HudsonReynolds/451-DBF-Team01/Assignment Deliverables/A2, Team 01, AAE451B.pdf

# System Assumptions & Constraints

# Assumptions: Environment

## - Density, ρ = 1.225 kg/m³

- Density at sea level, roughly where entire mission takes place
- From Anderson, standard atmosphere tables

## - Gravitational acceleration, g = 9.81 m/s²

- Known constant gravitational acceleration value
- NIST Fundamental Physical Constants

## - Takeoff friction coefficient, μTO

= 0.05
- From Gudmundsson, table 18-4
- Value used for concrete runway, no brakes

## - Landing friction coefficient, μlanding

= 0.08
- From Gudmundsson, table 18-4
- Value used for wet grass, no brakes

# Assumptions: Performance

- ϕcruise = 0.75
- Sadraey, chapter 4 page 126

### - γ = 16.7 degrees

- Calculated from mission altitude and estimated distance for climb
- Mission altitude: 30m
- Estimated climb distance: 100m

### - Span efficiency, e = 0.7

- Selected conservative value from range given by Sadraey, chapter 4 page 122
- AR = 5
- Selected aspect ratio of wing based on aircraft type and stall speed
- From Sadraey, table 5.8

# Assumptions: Performance

### - Max lift coefficient, CL,max = 1.5

- Selected from Sadraey, table 4.11 for home-built aircraft

### - Cruise lift coefficient, CL,C = 0.3

- Typical value for subsonic aircraft, Sadraey, chapter 4 page 132

### - Takeoff lift coefficient, CL,TO = 0.3

- Before rotation and no flaps, therefore similar to cruise

### - Lift coefficient at rotation, CLR = 1.24

- Calculated from CL,max and takeoff speed, 1.1 from takeoff velocity multiplier, Sadraey
- CD,0 = 0.04
- Selected from Sadraey, table 4.12 for home-built/GA with fixed gear
- CD = 0.048
- Calculated from CD,0, CL,C, and induced drag factor
- Sadraey, equation 4.41
- K = 0.091 induced drag factor, from Sadraey, eqn 4.41

# Assumptions: Performance

### - Takeoff drag coefficient, CD,TO = 0.048

- Before rotation and no flaps, therefore similar to cruise

### - Ground roll drag coefficient, CDG = 0.033

- Sadraey, equation 4.67a

### - Load factor, n = 1.5

- Selected conservative value from recommended range for RC planes
- From Sadraey, table 10.9
- ηp = 0.75
- From Gudmundsson, table 3-3 for fixed pitch propellor

### - ηp,TO = 0.45

- From Gudmundsson, table 3-3 for fixed pitch propellor, average efficiency during takeoff

# Assumptions: Performance

### - Stall speed, Vstall = 10.5 m/s

- Selected middle value from recommended stall speed range
- Range from A2 Handout from class

### - Cruise speed, Vcruise = 23.5 m/s

- Calculated from CL,max, CL,C, and stall speed

### - Takeoff speed, VTO

= 11.6 m/s
- From Sadraey, chapter 4, page 132
- Used 1.1 * Vstallas conservative value for takeoff velocity

### - Rturn = 20 m

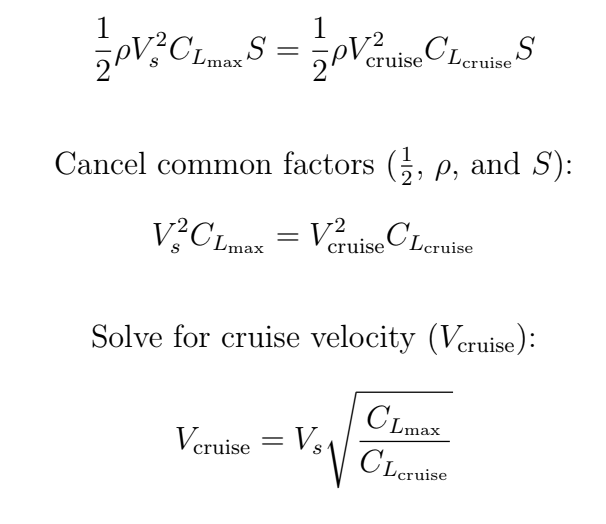
[picture p1: figure]

- Selected value smaller than required turn radius for mission flight path that also allowed for turn speed between stall and cruise speeds

### - Maneuver speed, VM = 14.8 m/s

- Calculated from selected turn radius and load factor

# Constraints (From RFP)

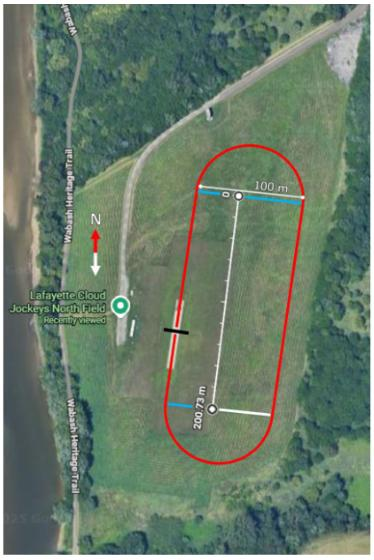
[picture p2: figure]

### - Wingspan ≤ 1.5 m - Aircraft Length ≤ 0.75 m - Aircraft Height ≤ 0.75 m - MTO ≤ 6 kg

- hcruise = 30 m
- Rturn,max = 50 m

### - STO ≤ 25 m

- Pmotor,max ≤ 1 kW

### - Stable with and without payload - Mpayload = 520g ± 10g - Lpayload = 50.8 mm (± 1mm) - Cost ≤ $400

# Constraints: Stall

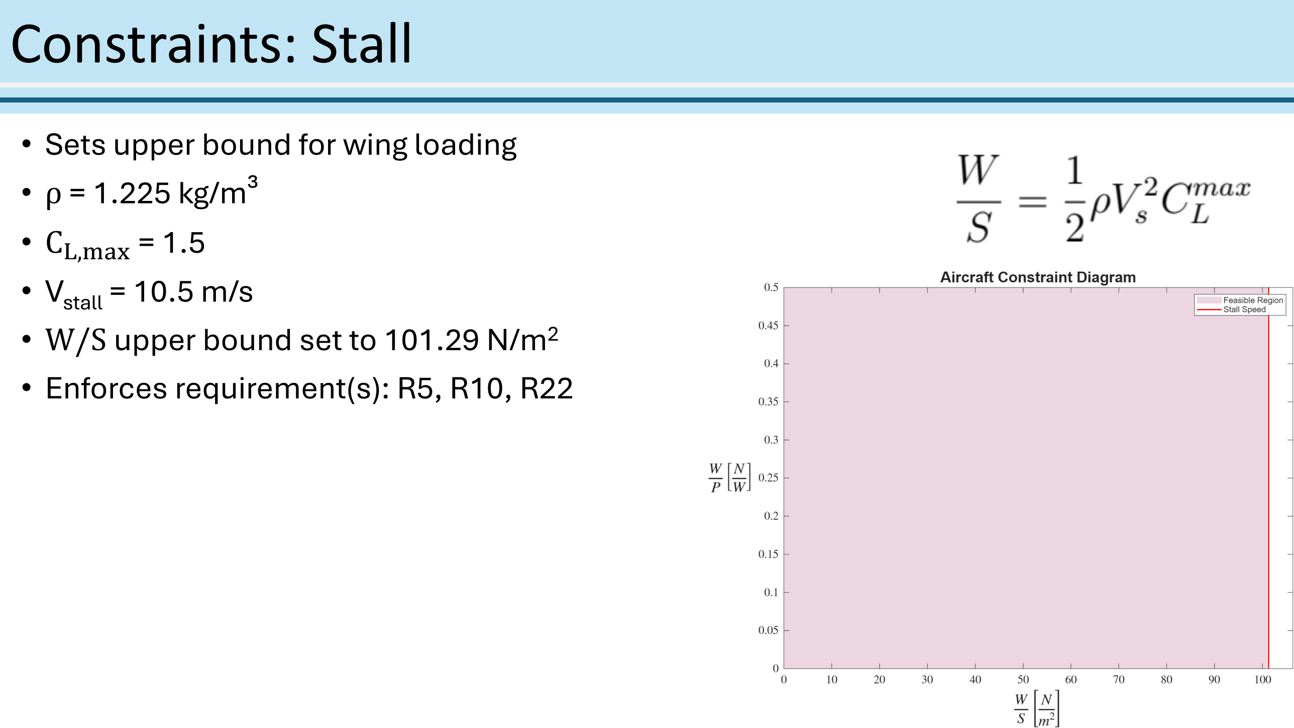
[picture p3: page 8]

### - Sets upper bound for wing loading - ρ = 1.225 kg/m³

- CL,max = 1.5

### - Vstall = 10.5 m/s - W/S upper bound set to 101.29 N/m² - Enforces requirement(s): R5, R10, R22

# Constraints: Climb

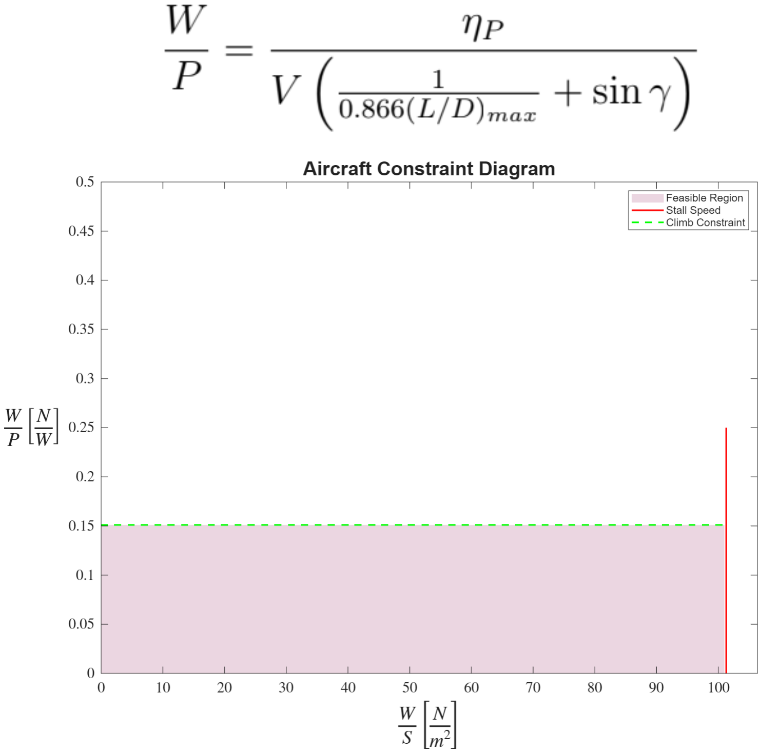
[picture p4: figure]

### - Sets upper bound for power loading

- ηp = 0.75

### - Vstall = 10.5 m/s

•

L
D max

= 6.23

### - γ = 16.7 degrees - Power loading limit set to 0.15 N/W - Enforces requirement(s): R2, R21, R22

# Constraints: Cruise

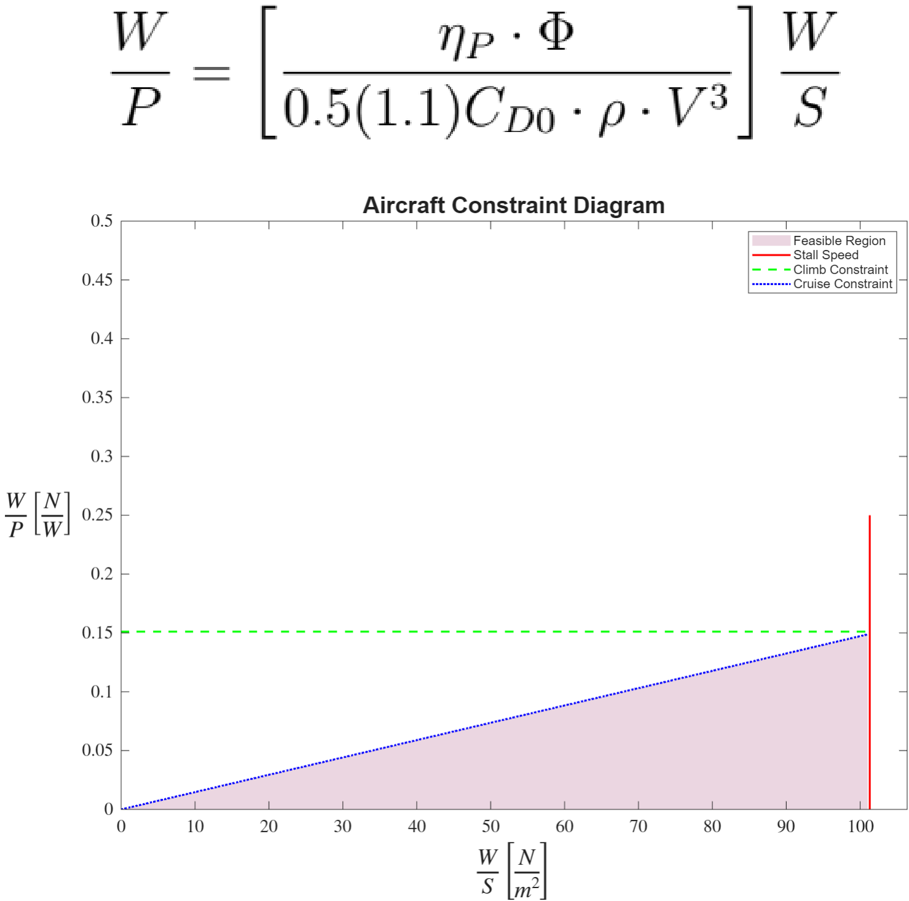
[picture p5: figure]

### - Sets upper bound for power loading

- ηp = 0.75

### - Vcruise = 23.5 m/s

- ϕcruise = 0.75

### - ρ = 1.225 kg/m³

- CD,0 = 0.04

### - Power loading limit set to 0.15 N/W at 101.29 N/m² - Enforces requirement(s): R3, R21

# Constraints: Maneuver

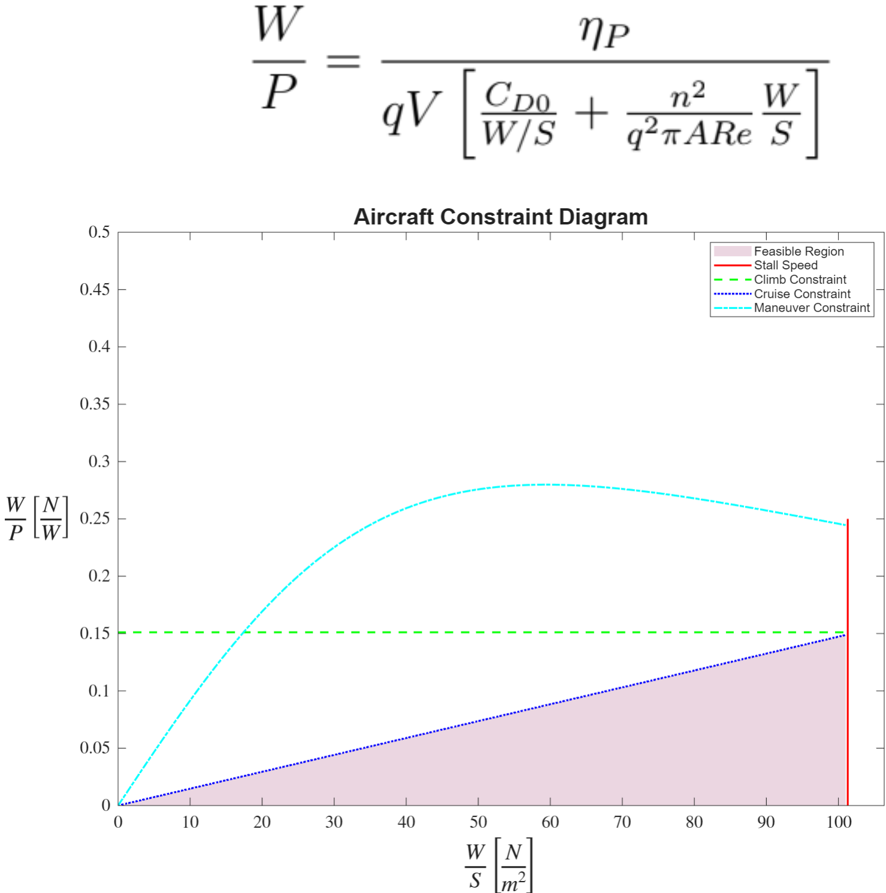
[picture p6: figure]

- Sets upper bound for power loading in our case
- ηp = 0.75
- q = 0.5 * ρ * V² = 134.3 Pa
- CD,0 = 0.04
- VM = 14.8 m/s
- Minimum turn radius of 20 m allows for maneuverability off the runway
- VM found using
- VM greater than VM,stall = 12.86, so chosen turn speed is viable
- n = 1.5
- AR = 5
- e = 0.7
- Does not impact feasible region
- Enforces requirement(s): R3, R4, R19

# Constraints: Take-Off

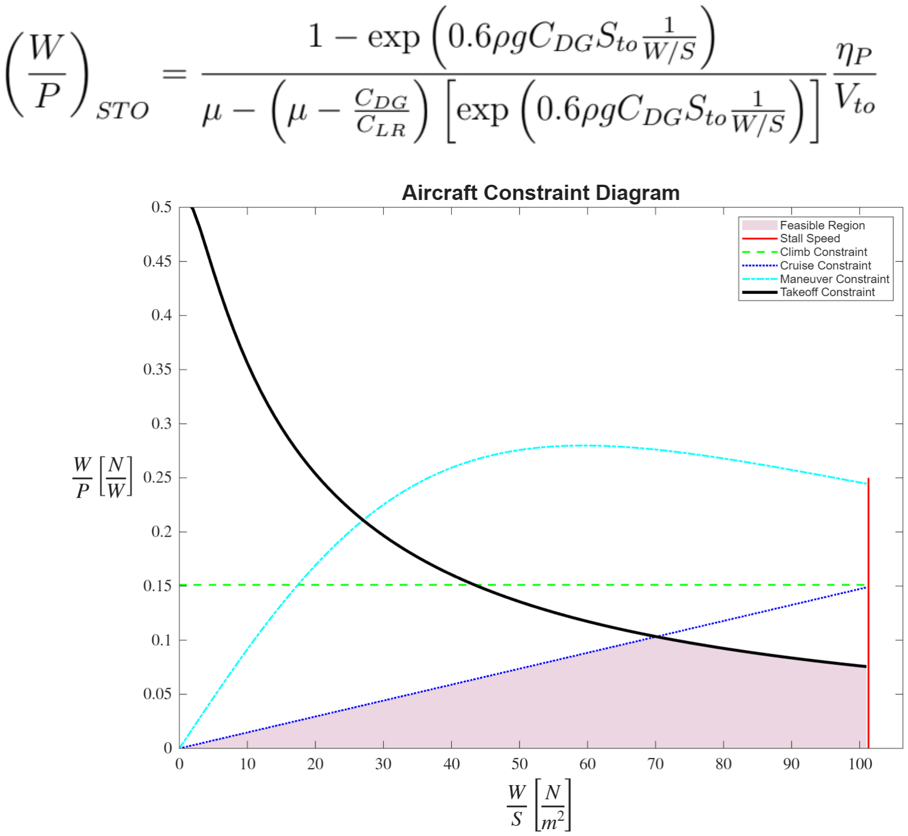
[picture p7: figure]

### - Sets upper bound for power loading - ηp,TO = 0.45 - ρ = 1.225 kg/m³ - g = 9.81 m/s² - CDG = 0.033 - CLR = 1.24

- μTO

= 0.05

### - STO = 25 m

- VTO

= 11.6 m/s

### - Power loading limit set to ~0.07 N/W at 101.29 N/m² - Enforces Requirement(s): R1, R21, R22

# Design Point

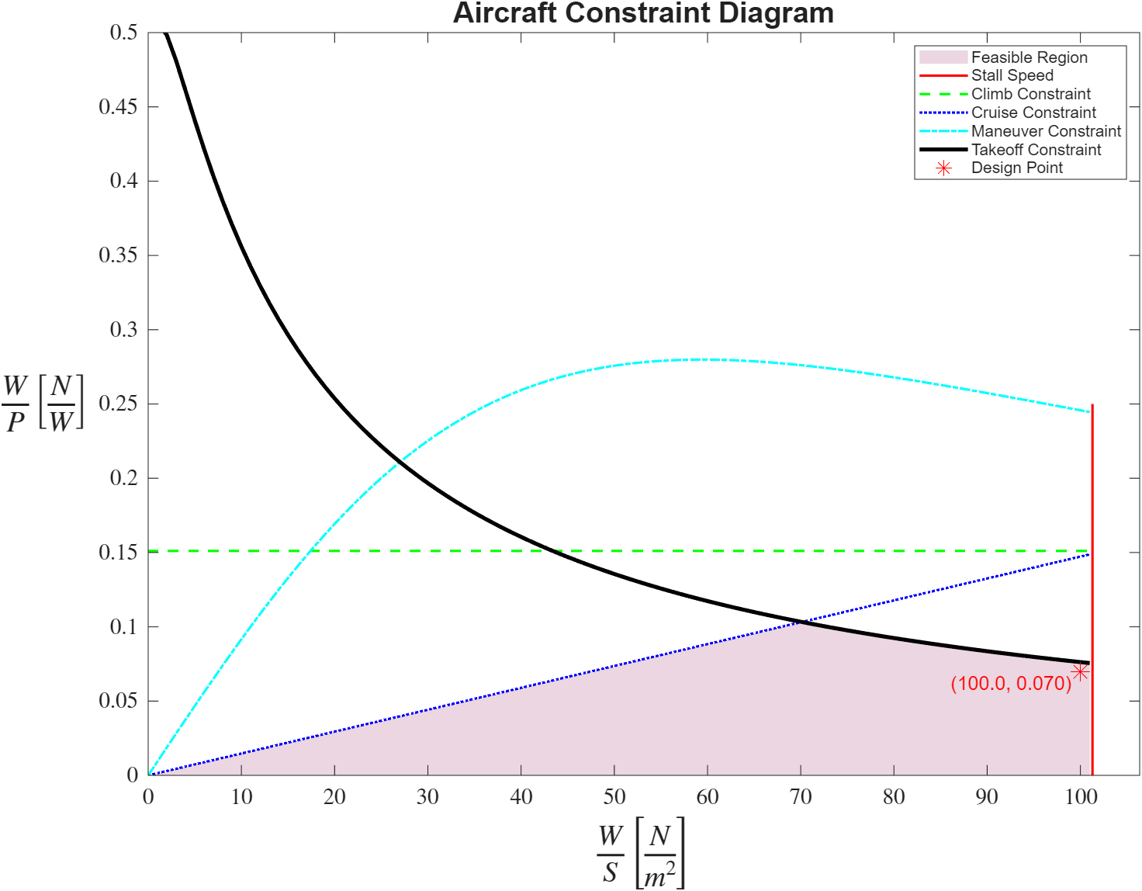
[picture p8: figure]

# Design Point

## - Wing loading selected at 100 N/m²

### - Near maximum for assumed stall speed - Minimizes wing area in feasible design space, reduces cost

## - Power loading selected at 0.07 N/W

### - Near maximum in design space for selected wing loading - Minimizes power requirement

## - Chose design point near takeoff and stall corner rather than near takeoff and climb corner because this allows for much smaller wing area with relatively similar required power

# Appendix

# Code:

Code for this project can be found in our team's GitHub repo here. (https://github.com/HudsonReynolds/451-DBF-Team01)

# Sources

Sadraey, M. H. (2012). Aircraft Design: A Systems Engineering Approach.

Gudmundsson, S. (2022). General Aviation Aircraft Design.

Anderson, J. D. (2016). Introduction to Flight, Eighth Edition.

## AAE 451 Lecture Notes
