HudsonReynolds/451-DBF-Team01/Assignment Deliverables/AAE451B, Team 01, A4.pdf

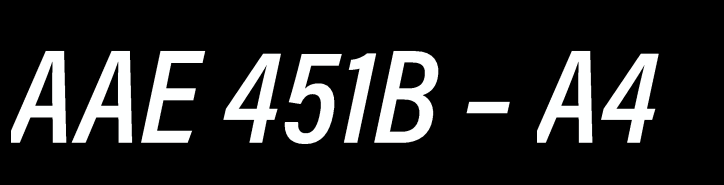
[picture p9: figure]
AAE 451B –A4

# Team 01

9/6/2026

Component | Option 1 | Option 2 | Option 3 | Option 4
Wings | High Wing | Mid Wing | Low Wing | Biplane
Propulsion | Tractor | Pusher | Double Tractor | Double Pusher
Landing Gear | Tricycle | Tail Dragger | Skis | Bicycle
Fuselage | Cylindrical Tube | Box Tube | Lifting Body | No external
Empennage | Conventional | V-Tail | H-Tail | Swept Tail

# - Below are 4 selected concepts for our vehicle - The options were chosen so that A, B, C, and D are feasible

Concept | Wing | Propulsion | Landing Gear | Fuselage | Empennage
1 | High Wing | Tractor | Tricycle | Cylindrical | Standard Tail
2 | Low Wing, Dihedral & Taper | Tractor | Tricycle | Cylindrical | Swept Vertical
3 | High Wing, Taper & Camber | Double Tractor | Tail Dragger | Cylindrical | H-tail
4 | Biplane | Tractor | Tail Dragger | Oval | Swept Vertical

- The letter "Y" signifies being compliant with the presented limit.
- The letter "N" signifies a lack of compliance to the presented limit.
Concept | Within Span Limit? | Within Weight Limit | Within Power Limit? | Holds Battery + Payload? | Passes Gate?
1 | Y | Y | Y | Y | Y
2 | Y | Y | Y | Y | Y
3 | Y | Y | Y | Y | Y
4 | Y | Y | Y | Y | Y

1. Takeoff distance: This is a hard requirement set by the RFP and can vary with aircraft configuration.
2. Ease of assembly: There are multiple requirements within the RFP that relate to the speed in which the aircraft needs to be transitioned from a state of disassembled storage to its flight ready configuration, including the empty weight being assembled in under 5 minutes, and the battery and payload being installed within 2 minutes.
3. Battery access: Circles back to RFP requirement of a hard 2 minute cap on battery installation, as well as the RFP requirement that the battery needs to be able to be accessed and removed without removal of aircraft components.
4. Safe landing: RFP dictates a landing within a soft grass field must be conducted without significant damage.
5. Stable/controllable: We need to ensure that our aircraft can reliably complete the 3 lap flight path presented in the RFP while also providing predictable flight behavior so the external pilot may easily avoid potential obstacles in the form of wildlife and/or bystanders.
6. Cost: Because our budget of $400 is a hard constraint, using expensive materials or manufacturing processes are out of the question. Factoring in cost for manufacturing allows us to obtain a realistic
design compromising material benefits for feasibility.

# Evaluation Matrix

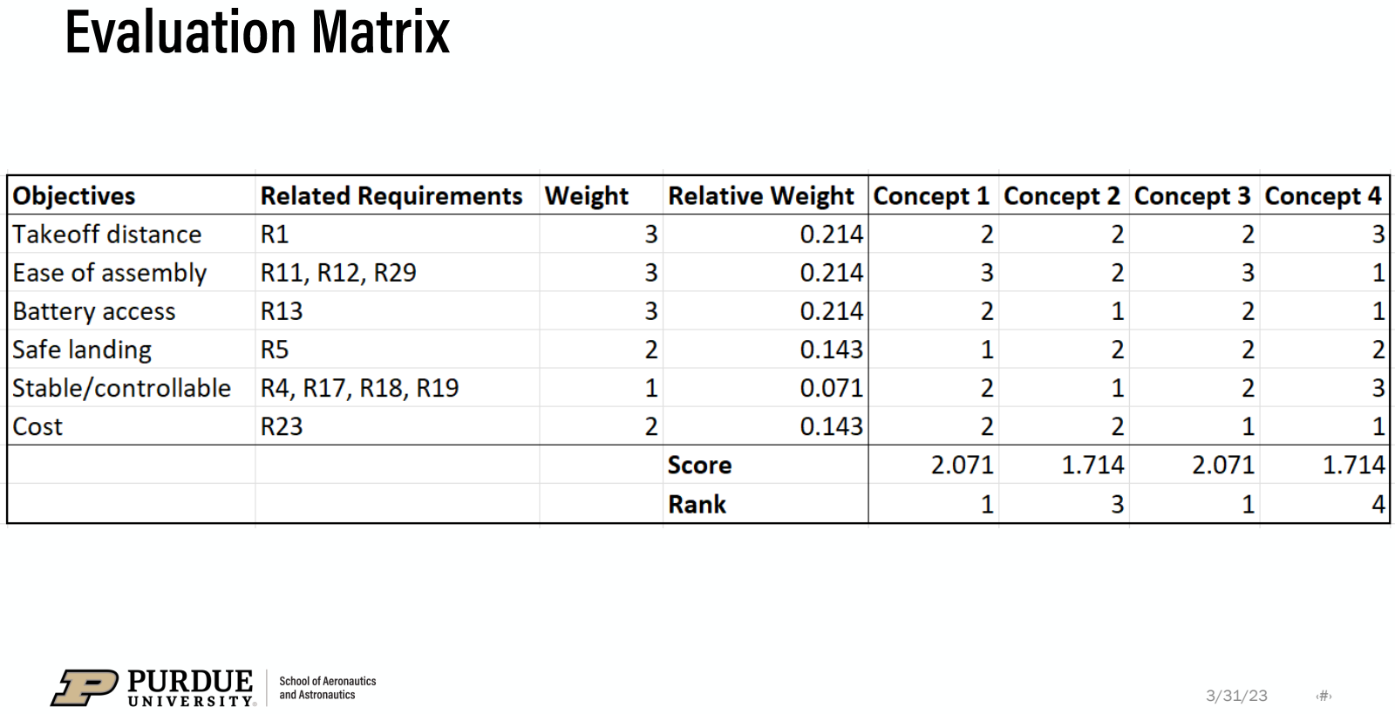
[picture p10: page 6]

# - Takeoff distance was weighted heavily because it is a hard requirement

- Ease of assembly and battery access were also weighted heavily because these can be significantly

# affected by the configuration selection

- Safe landing was given a medium weight because this can be affected by configuration, but is also

# affected by pilot ability

- Cost was also given a medium weight because it a strict requirement, but we expect most configurations

# can stay within budget

- Stable/controllable was given the lowest weight because it can be affected by configuration, but between

# the concepts we traded, stability will largely come down to the detailed design

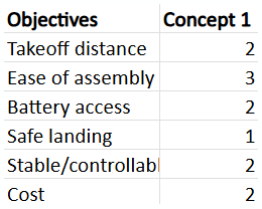
[picture p11: figure]

## - Consists of a high-wing with a NACA 2412 airfoil

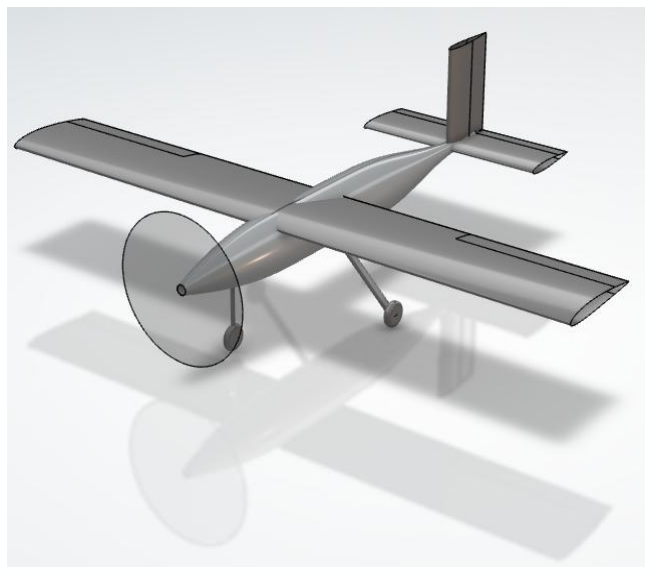
[picture p12: figure]

### - Straight wing (no twist or sweep, taper ratio of 1)

## - Ailerons that occupy 50% of span and 25% of chord

## - Tricycle landing gear - no extra clearance needed for tractor propeller

## - Standard tail

## - Payload, battery, and primary avionics reside in fuselage cavity

## - First row of parameter sheet

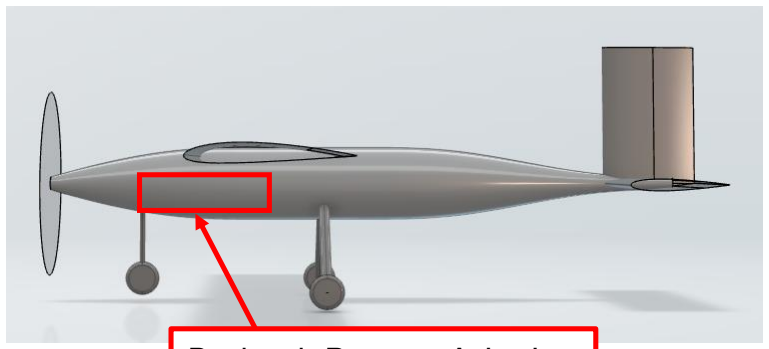
[picture p13: figure]
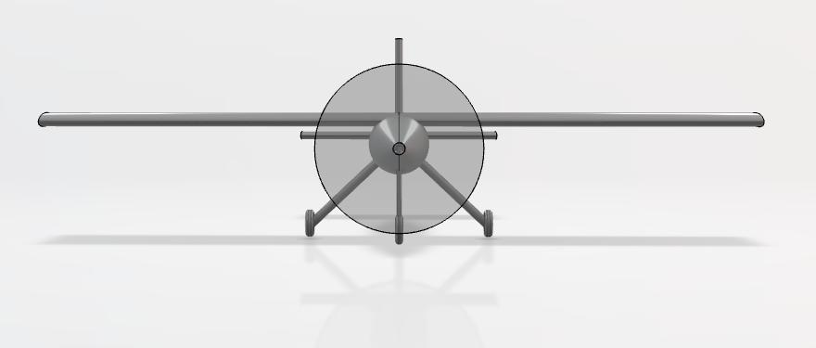
[picture p14: figure]

### 3/31/23 ‹#› Payload, Battery, Avionics

## Score Justification

- Takeoff distance: Given a 2 due to the lift C_L, no flaps, and wing area being about average relative to other choices
- Ease of assembly: High wing, single motor, and single rudder make this simple to assembly
- Battery access: Battery could be accessed through either the side or bottom, but not top
- Safe landing: Risk of a tail strike during landing if not careful
- Stable/controllable: High wings are more stable
- Cost: Relatively simple design without duplicated components

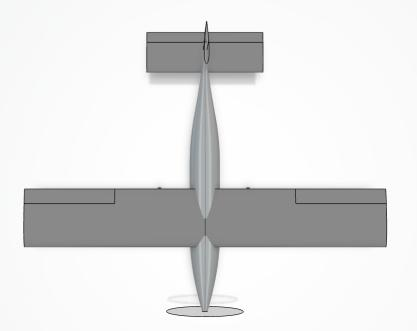
[picture p15: figure]

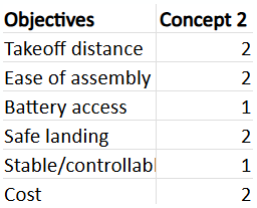
[picture p16: figure]

## - Consists of a low-wing with a NACA 2415 airfoil

### - Straight wing for 40% span, other 60% at 5° dihedral, taper ratio 0.75

## - Ailerons only on dihedral part of wing

## - Tail Dragger landing gear – gives extra prop clearance for tractor

## - Swept Tail at 5° backward with tapered vertical stabilizer

## - Payload, battery, and primary avionics reside in fuselage cavity

## - Second row of parameter sheet

# Bent Tapered Low-Wing, Standard Tail, Tail Dragger

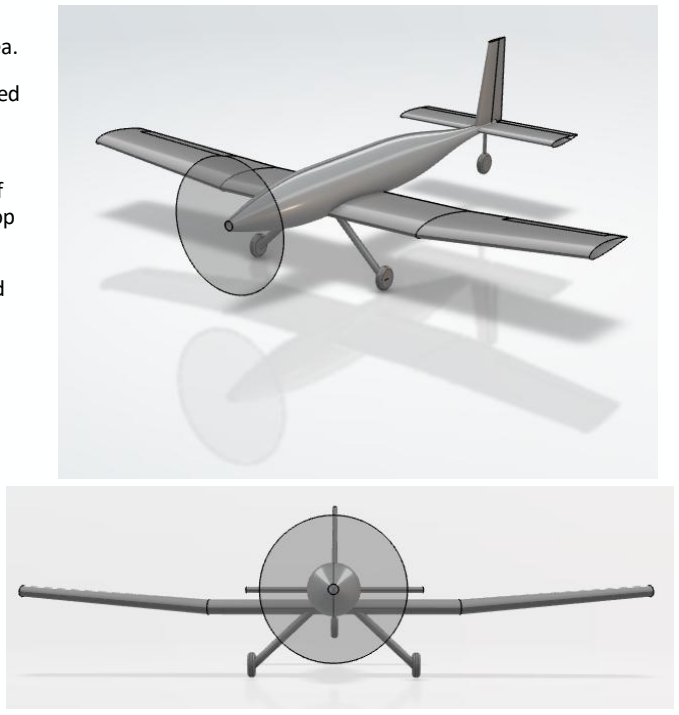
[picture p17: figure]
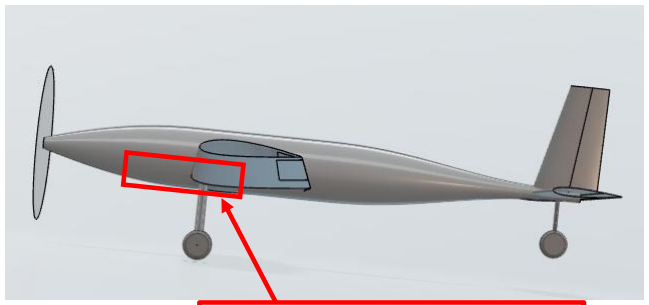
[picture p18: figure]

### 3/31/23 ‹#› Payload, Battery, Avionics

## Score Justification

- Takeoff distance: Given a 2 due to the lift C_L, no flaps, and wing area being about average relative to other choices.
- Ease of assembly: Simple aircraft with minimal components, but due to low wing might be hard to assembly the landing gear, wing, and body with the payload and battery in this area.
- Battery access: Wing/body structure will interfere with desired battery location, possibly making it harder to fit a battery in this area with ease.
- Safe landing: Tail dragger is easier to land because less risk of tail strike, more prop clearance, and twin props decrease prop size and lower strike risk, but easier to flip than tricycle
- Stable/controllable: Propeller adds net torque to vehicle, and swirled flow hits the tail that can cause instabilities.
- Cost: Low overall cost due to minimal material and single engine.

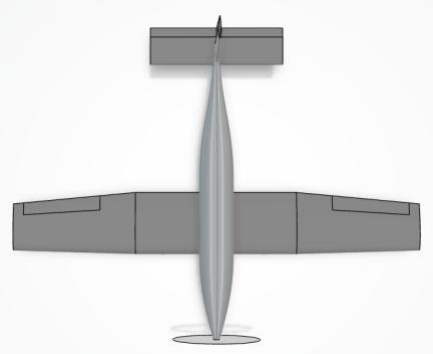
[picture p19: figure]

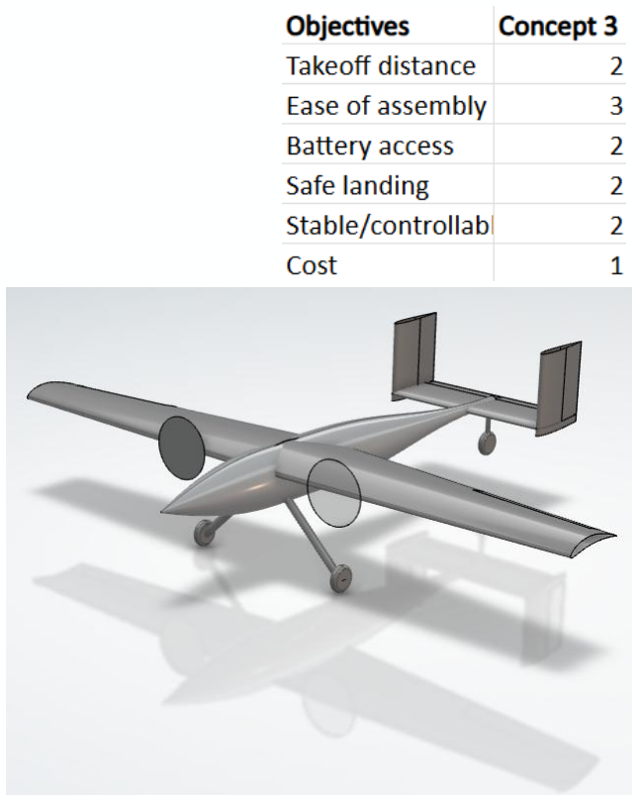
[picture p20: figure]

## - Consists of a high-wing with E423 airfoil to balance H-tail moment

### - Taper ratio 0.6, no twist or sweep

## - Ailerons on only ~38% of wing; double tractor propellers on front

## - Tail Dragger landing gear – gives extra prop clearance

## - H-tail with smaller span and smaller vertical height than standard

## - Payload, battery, and primary avionics reside in fuselage cavity

## - Third row of parameter sheet

# Cambered High-Wing, H-Tail, Double Tractor, Tail Dragger

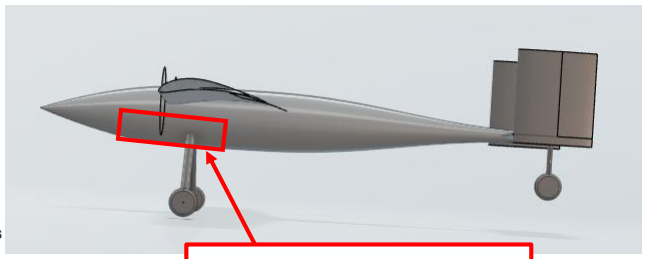
[picture p21: figure]

### Payload, Battery, Avionics

## Score Justification

- Takeoff distance: Given a 2 due to the lift C_L, no flaps, and wing area being about average relative to other choices. Initial AoA from tail dragger but smaller props less efficient
- Ease of assembly: Two motors and two rudders make assembly more complicated
- Battery access: Battery could be accessed through either the side or bottom, but not top
- Safe landing: Tail dragger is easier to land because less risk of tail strike, more prop clearance, and twin props decrease prop size and lower strike risk, but easier to flip than tricycle
- Stable/controllable: Dual engines cancel out torque, and increases stability in low speeds and while turning
- Cost: Dual engines more expensive and require more avionics, also additional tail material brings cost up

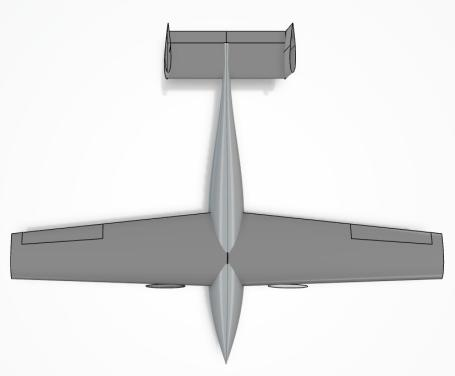
[picture p22: figure]
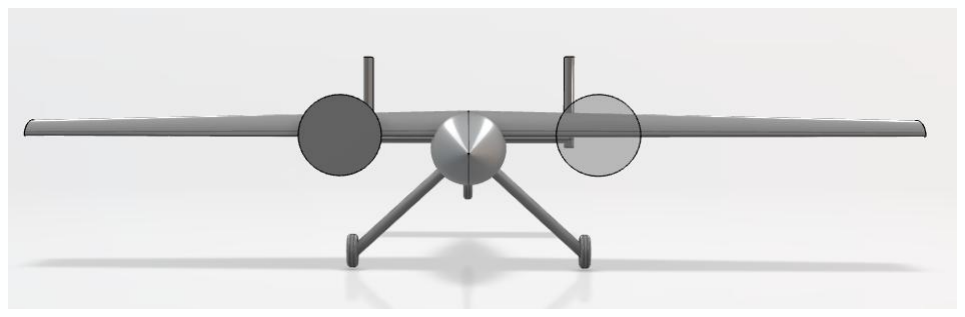
[picture p23: figure]

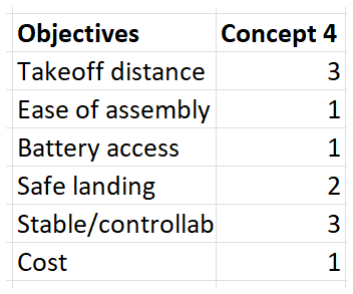
[picture p24: figure]

## - Consists of two wings with NACA 0012 airfoils

## - Straight wings (no twist or sweep) attached to oval fuselage

## - Ailerons on only ~38% of lower wing, none on upper wing

## - Tail Dragger landing gear – gives extra prop clearance

## - Standard tail, slightly swept vertical stabilizer

## - Payload, battery, and primary avionics reside in fuselage cavity

## - Fourth row of parameter sheet

# Biplane, H-Tail, Standard Tail, Tail Dragger

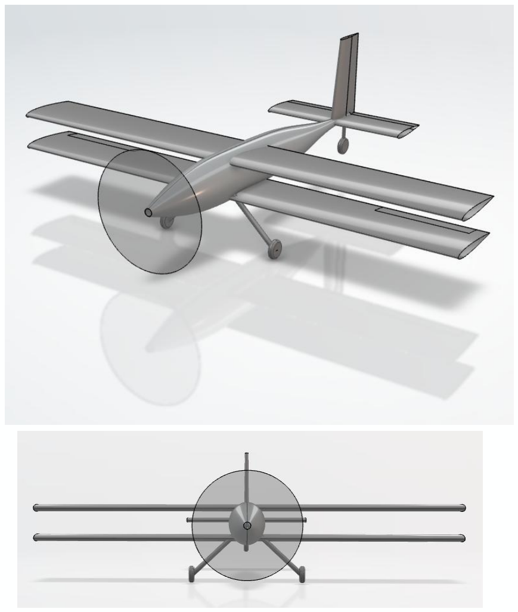
[picture p25: figure]
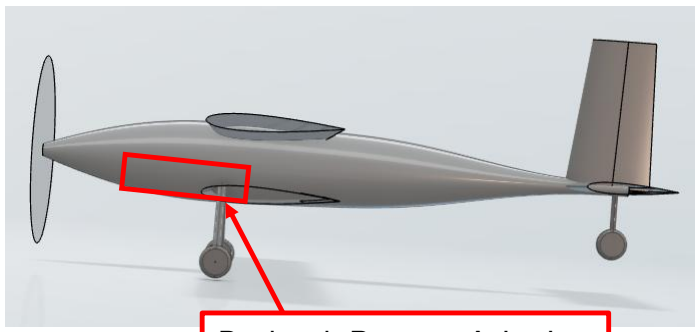
[picture p26: figure]

### 3/31/23 ‹#› Payload, Battery, Avionics

## Score Justification

- Takeoff distance: Given a 3 due to the high wing area and better clearance of prop from the ground, as well as a starting AoA from tail dragger gear.
- Ease of assembly: Increased amount of build and assembly required for 2 wings, location of components within the vehicle become harder to fit.
- Battery access: Wing/body structure will interfere with desired battery location, possibly making it harder to fit a battery in this area with ease.
- Safe landing: Tail dragger is easier to land because less risk of tail strike, more prop clearance, and twin props decrease prop size and lower strike risk, but easier to flip than tricycle
- Stable/controllable: Will likely perform well in low speed, low wing loading makes it more maneuverable
- Cost: Due to extra wing material, will require more material, bringing cost up.

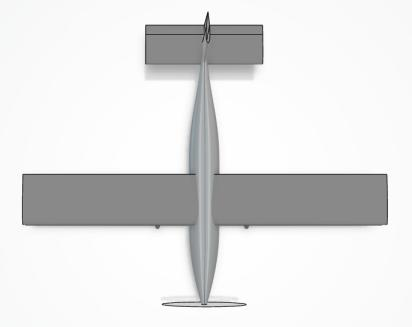
[picture p27: figure]

# Configuration Model Parameters

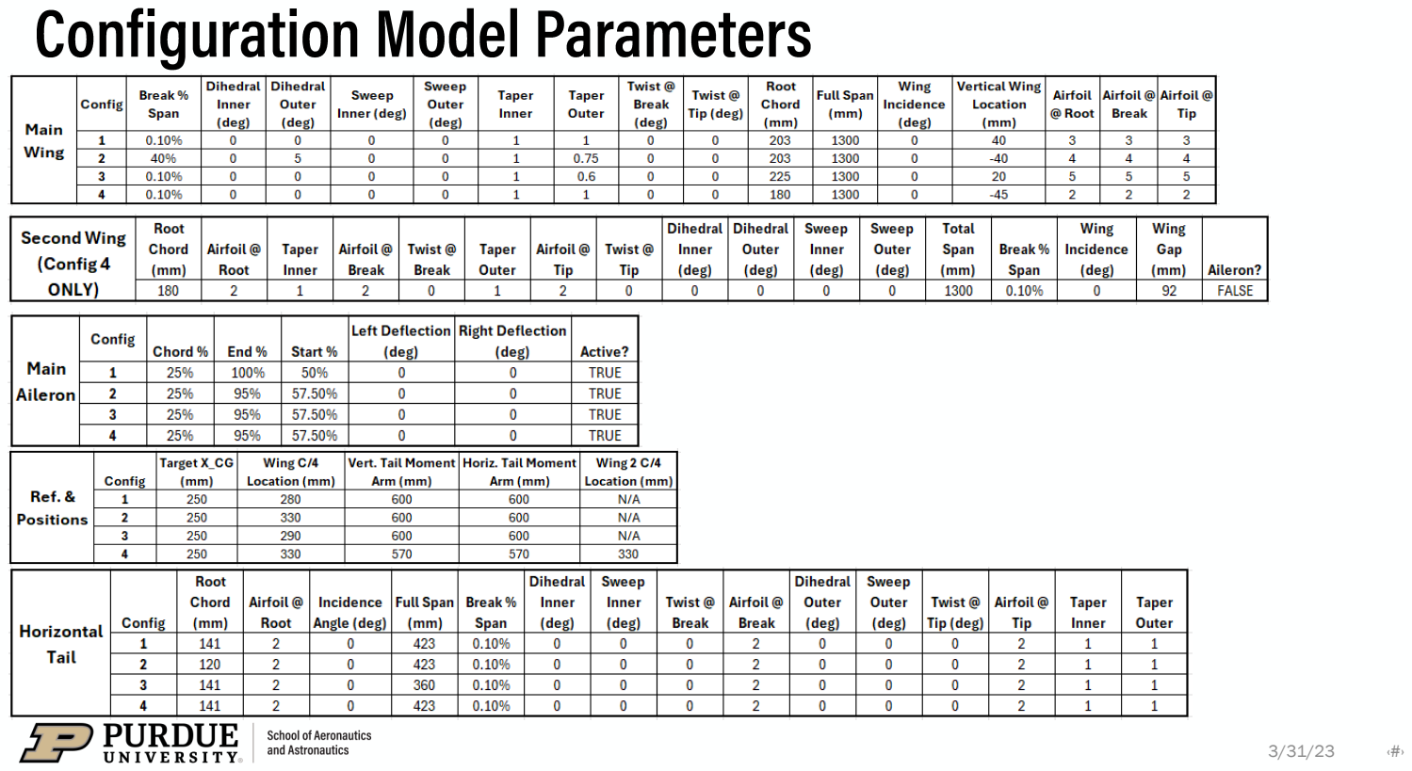
[picture p28: page 12]

# Configuration Model Parameters

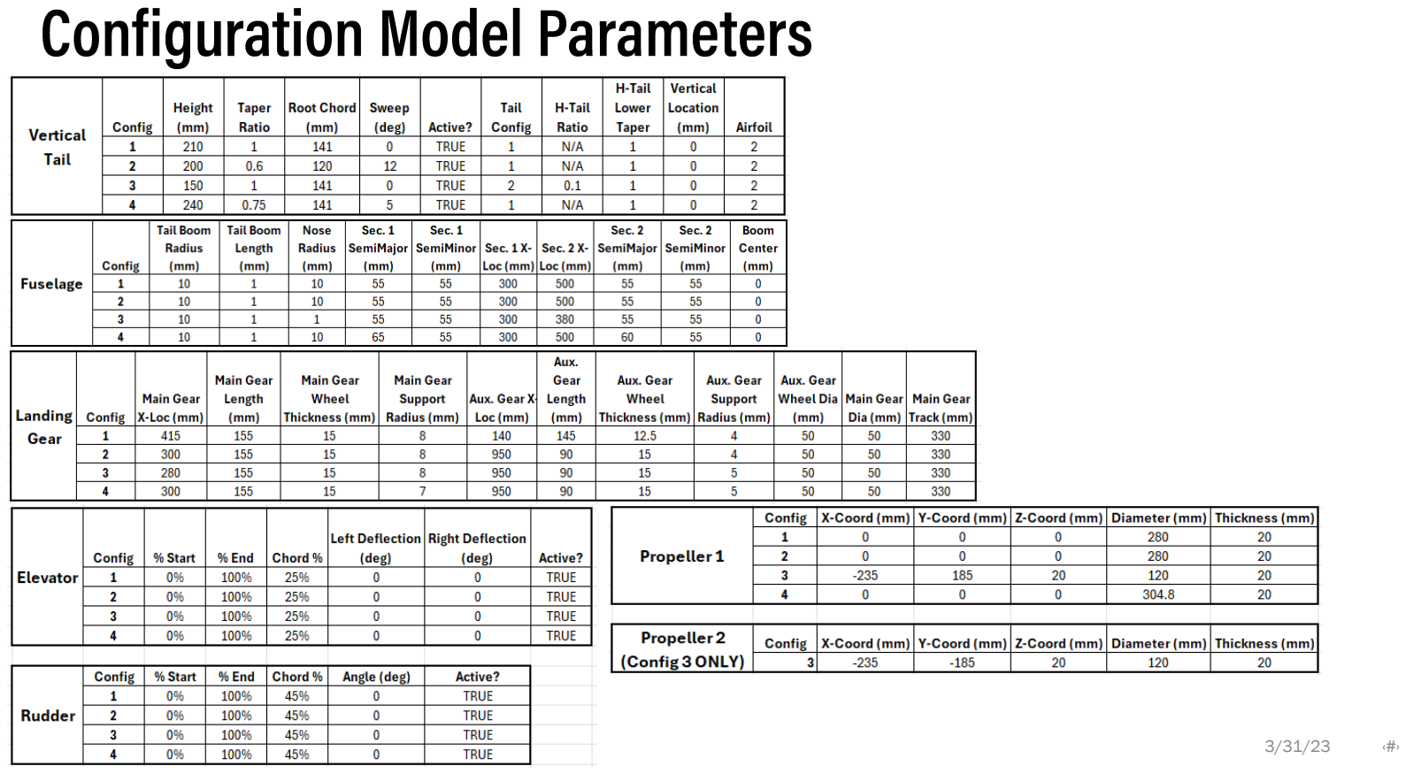
[picture p29: page 13]

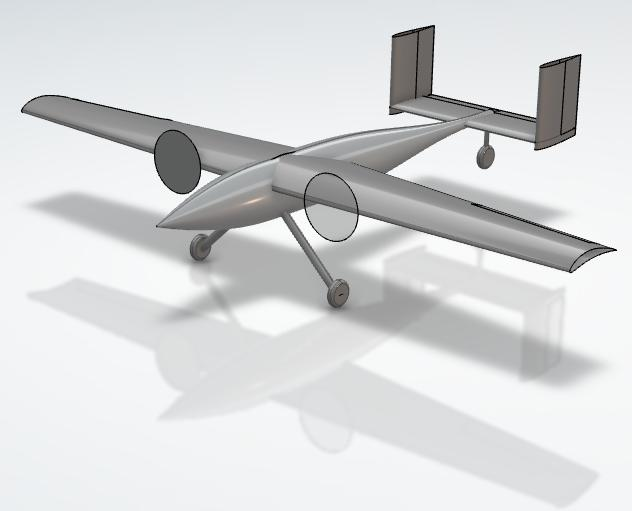
[picture p30: figure]

- Concept 3 has been chosen due to the result of the weighted matrix, even though it was tied for the 1st concept, and may be more expensive than concept 1 - Chosen due to unique design and interesting challenge of using an H tail over conventional tail - Bi-prop was chosen for easy of controllability due to torque imbalance from the propeller - Due to high wing design, wing can be a singular piece while still having access to battery and payload - Tail dragger chosen for lower overall drag and better propeller clearance - Tapered wing for better spanwise efficiency

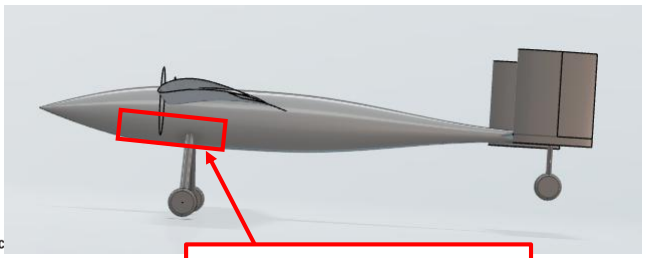
[picture p31: figure]
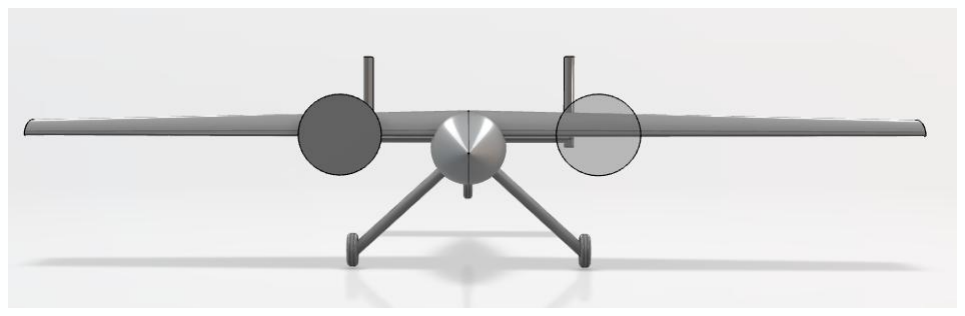
[picture p32: figure]

### 3/31/23 ‹#› Payload, Battery, Avionics
