HudsonReynolds/451-DBF-Team01/Assignment Deliverables/AAE451B, Team 01, A5.pdf

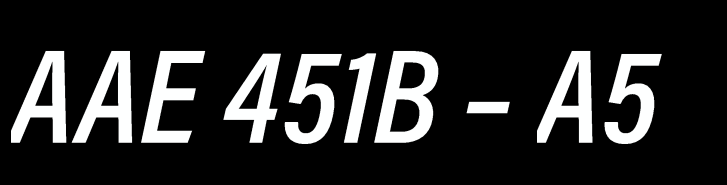
[picture p33: figure]
AAE 451B –A5

# Team 01

9/13/26

# - Velocities:

## - Cruise: 23.5 m/s - Stall: 10.5 m/s - Max: 28.2 m/s

# - Selected wingspan: 1.5 m - Chord: 0.318 m

## - From selected wing loading of 95 N/m² , estimated mass of 4.45 kg, and fuselage width of 55 mm

# - Air properties at standard sea level conditions: 101325 Pa, 288 K

## - Density: 1.225 kg/m³ - Viscosity: 1.796E-05 Pa-s

# - Reynolds number: Chord used as reference length

## - Cruise velocity: 510000 - Stall velocity: 230000 - Max velocity: 610000

# - Reynolds number range used for airfoil trade: 100000 – 700000

Criterion | Requirements it serves (reference from A1) | Weight | Relative Weight | Weight Justification
Cl,max | R1 | 3 | 0.214 | The flight mission includes a baseline requirement of taking off within 25 meters of the starting line. A high maximum lift coefficient is required to guarantee a successful takeoff relative to this requirement.
Cm0 | R4 | 3 | 0.214 | Highly cambered airfoils generate massive nose-down pitching moments. Balancing this requires the tail to generate significant downforce, which would result in a high level of trim drag.
(L/D)max | R3, R21 | 3 | 0.214 | The aircraft must sustain flight for 3 laps under a strict power cap. Maximizing aerodynamic efficiency directly improves the power efficiency during the cruising state.
Manufacturability | R23, R24 | 1 | 0.0714 | Choosing an airfoil that does not overtly cut into our budget or is too challenging to effectively manufacture is a crucial part of the design process that must be considered.
Alphastall | R5, R19 | 1 | 0.0714 | A higher stall angle provides a forgiving margin of error for the pilot in the case of any sudden actions that may be needed in the air
Cl,alpha | R19 | 1 | 0.0714 | Having a lift curve slope in either extremity (too steep/flat) may lead to overly sensitive or sluggish flight behaviors.
Cd,min | R21 | 1 | 0.0714 | Lower base drag saves battery power. It gets a lower weight than (L/D)max because it only shows the 'best-case’ drag, which might not be the angle our aircraft flies at during cruise.
Alpha at (L/D)max | R3 | 1 | 0.0714 | Aligning the airfoil's most efficient angle of attack with the aircraft's flat cruising angle can help ensure drag is minimized during flight.

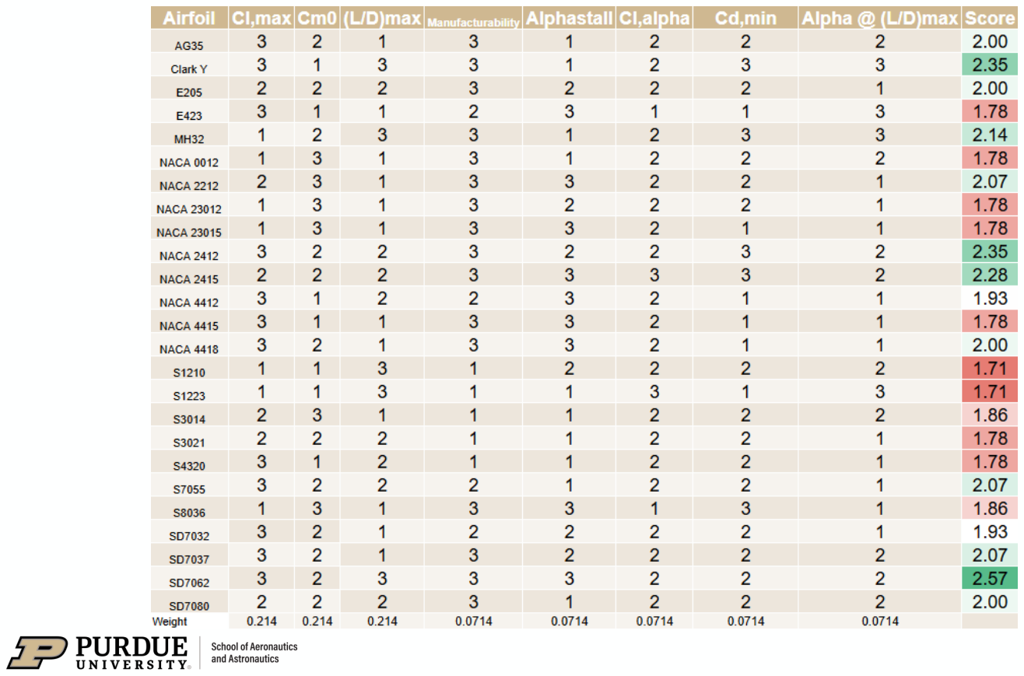
[picture p34: page 4]

# Airfoil Trade Study: Airfoils

# Re = 230000- Stall Speed

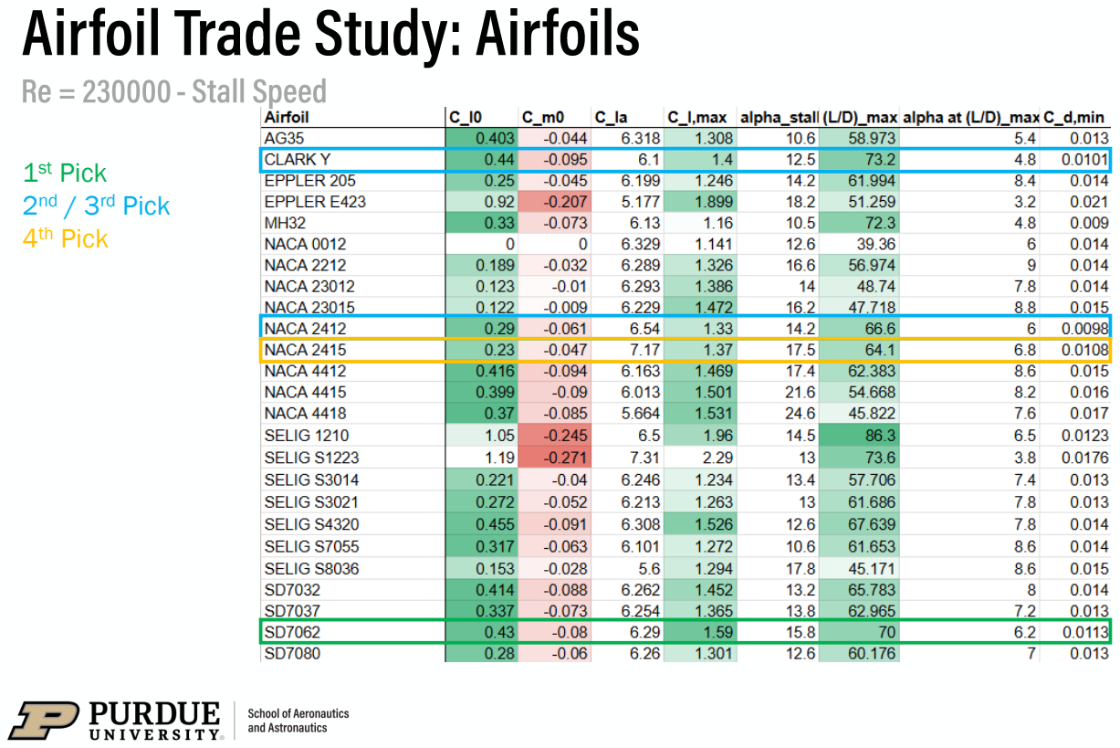
[picture p35: page 5]

1

## st Pick

2

## nd / 3rd Pick

4

## th Pick

# Airfoil Trade Study: Airfoils

# Re = 510000 - Cruise Speed

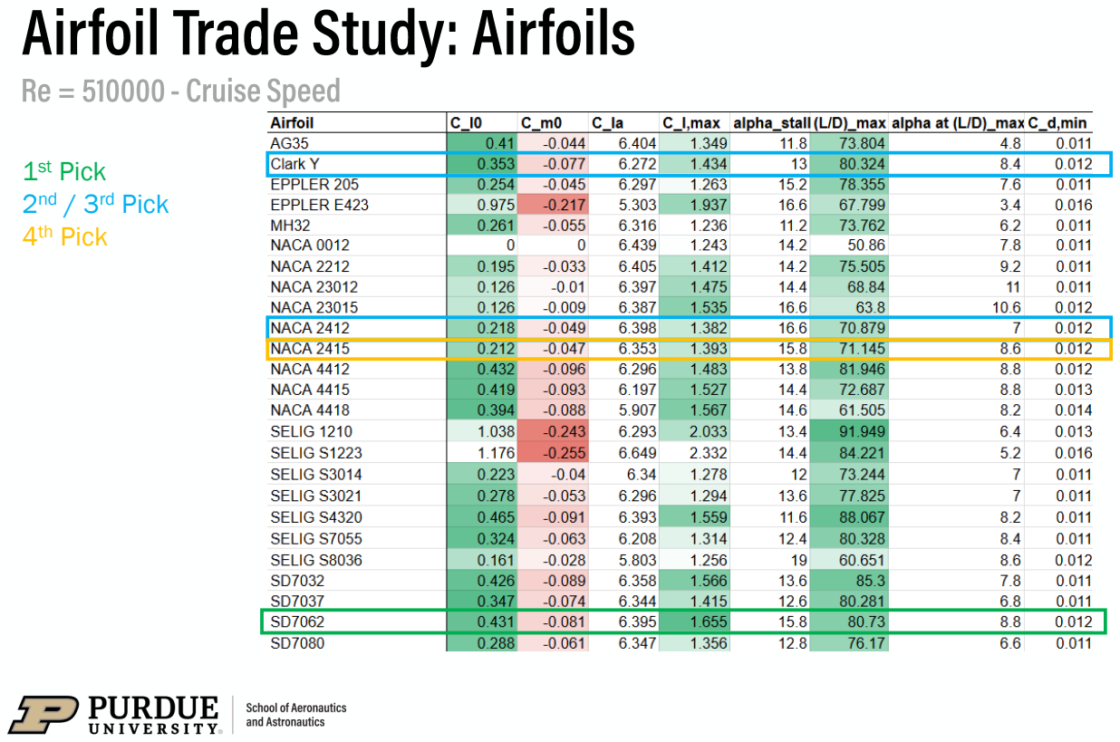
[picture p36: page 6]

1

## st Pick

2

## nd / 3rd Pick

4

## th Pick

# Airfoil Trade Study: Airfoils

# Re = 610000 - Max Speed

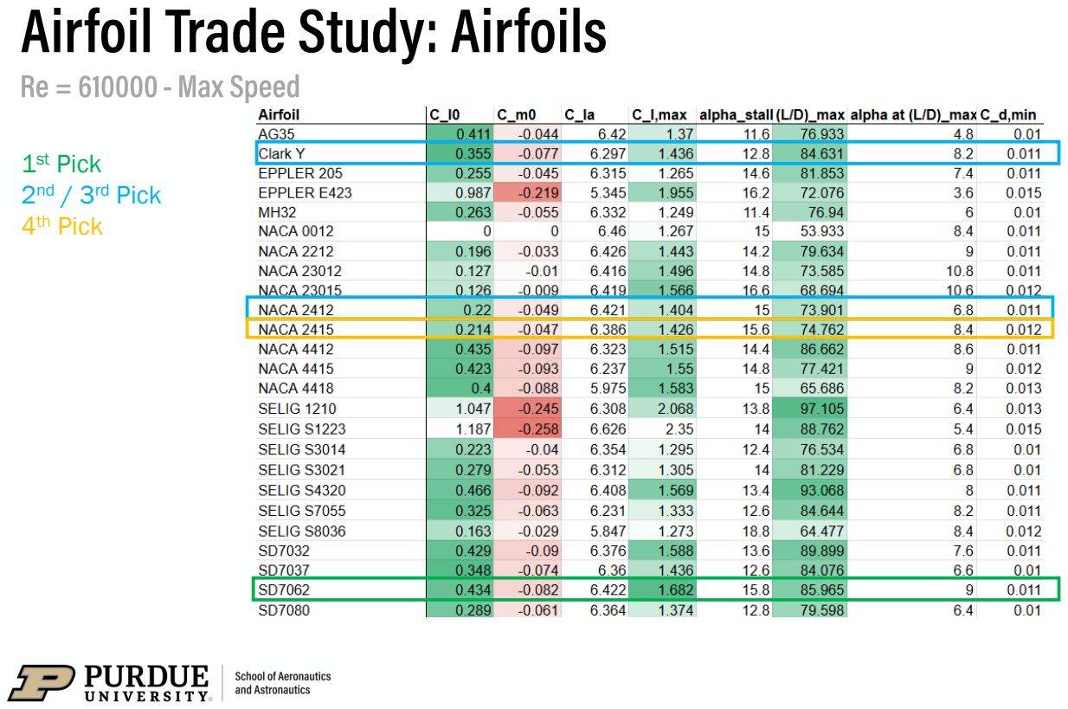
[picture p37: page 7]

1

## st Pick

2

## nd / 3rd Pick

4

## th Pick

# Airfoil Trade Study: Airfoils

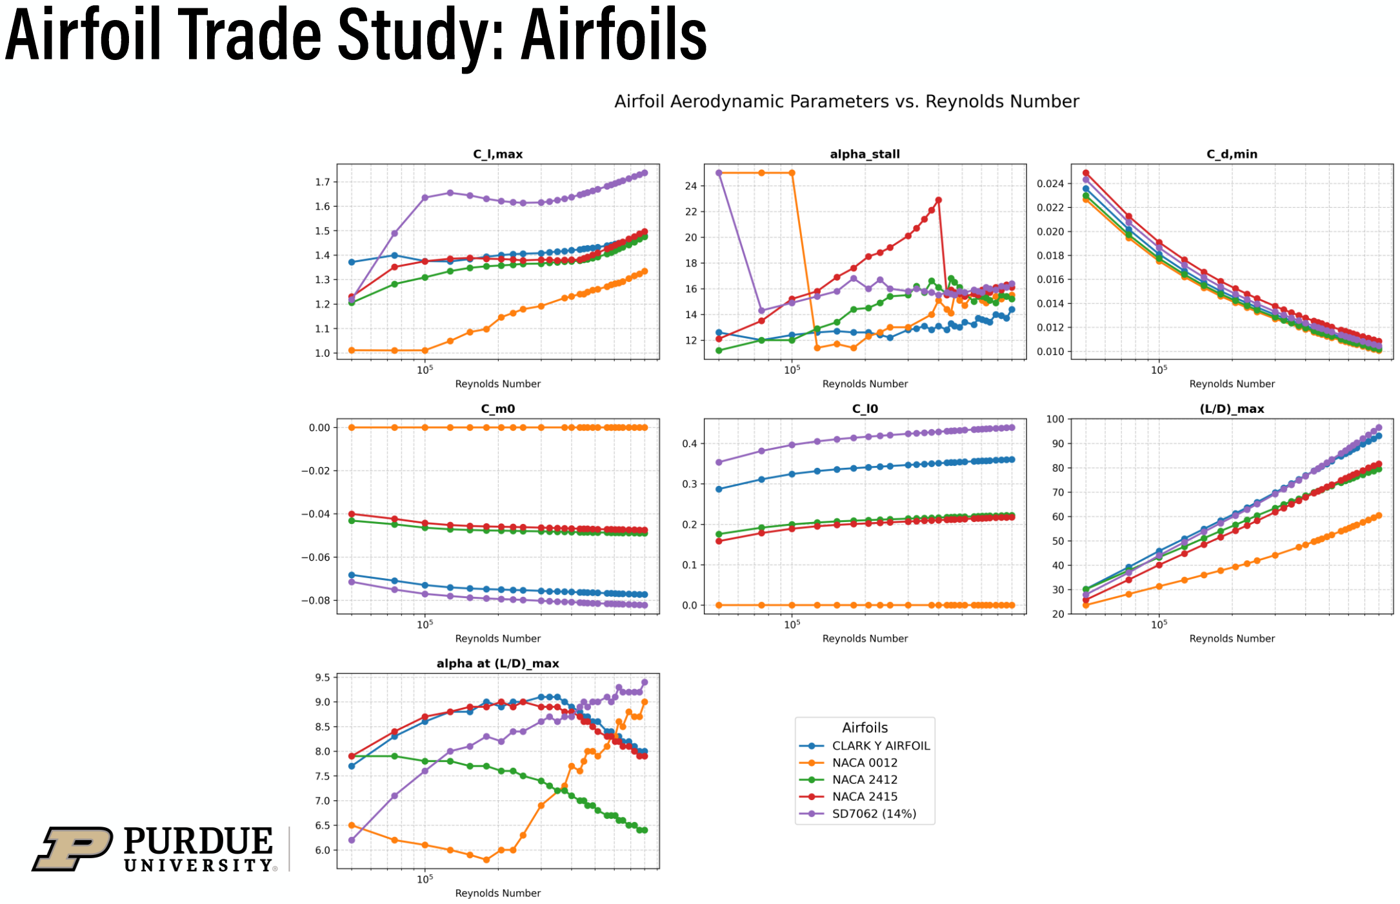
[picture p38: page 8]

# - No taper, sweep, twist, or dihedral

# - Simplifies manufacturing and assembly of wing - Not critical to meet requirements

# - Selected airfoil has slightly lower CL,max than assumed in A2 sizing

# - Moved stall constraint - Had to change design wing loading from 100 N/m²

# to 95 N/m²

# - Wingspan selected at RFP maximum of 1.5 m

# - This maximizes AR and aerodynamic efficiency for a given wing area

# - Wing area calculated from vehicle weight estimation and selected wing loading - Chord calculated from wing area and wingspan

# - Accounted for wingspan covered by fuselage

# Wing Parameters:

# - Wingspan: 1.5 m - Chord: 0.318 m

- AR: 4.72

# - Dimensions match CAD configuration - Drag coefficients:

# - Fuselage: 0.0023 - Wing: 0.0143

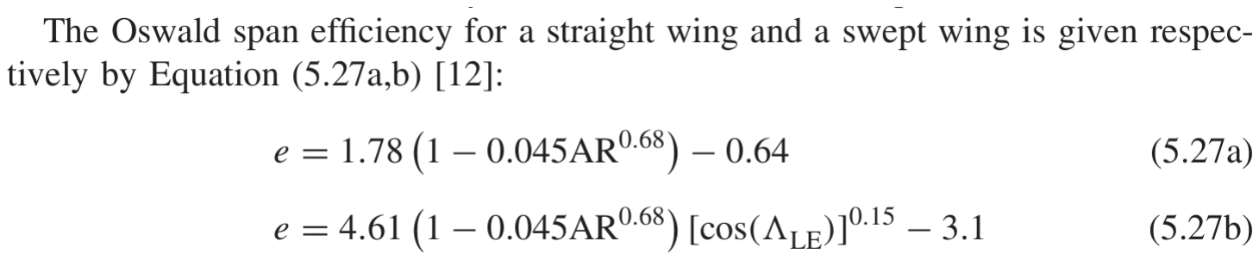
[picture p39: figure]

# - Horizontal stabilizer: 0.0034 - Vertical stabilizers: 0.0026 - Landing gear: 0.0061 - Leakage/protuberance: 0.0029

- CD0 = 0.0315

# - Oswald span efficiency empirical correlation from Sadraey equation 5.27a

- e = 0.91

# Clean Drag Polar

# - (L/D)max = 10.35

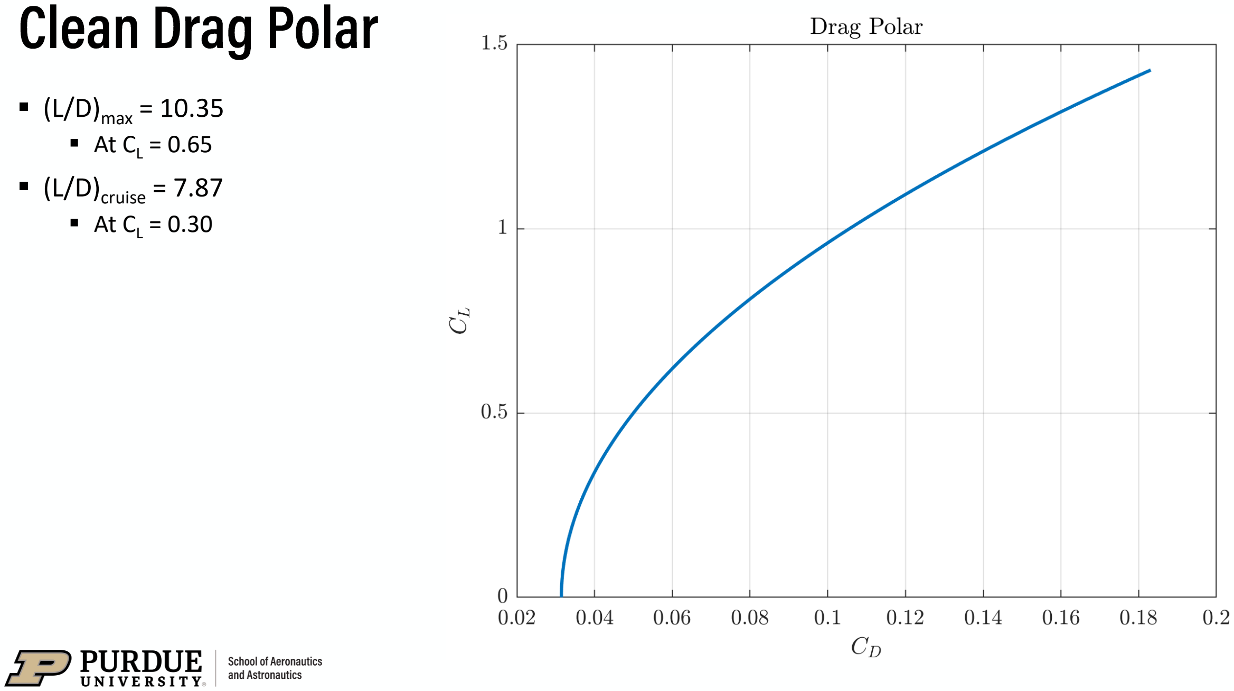
[picture p40: page 11]

# - At CL = 0.65

# - (L/D)cruise = 7.87

# - At CL = 0.30

# - This updated model in the team parameterized

# Wing Model

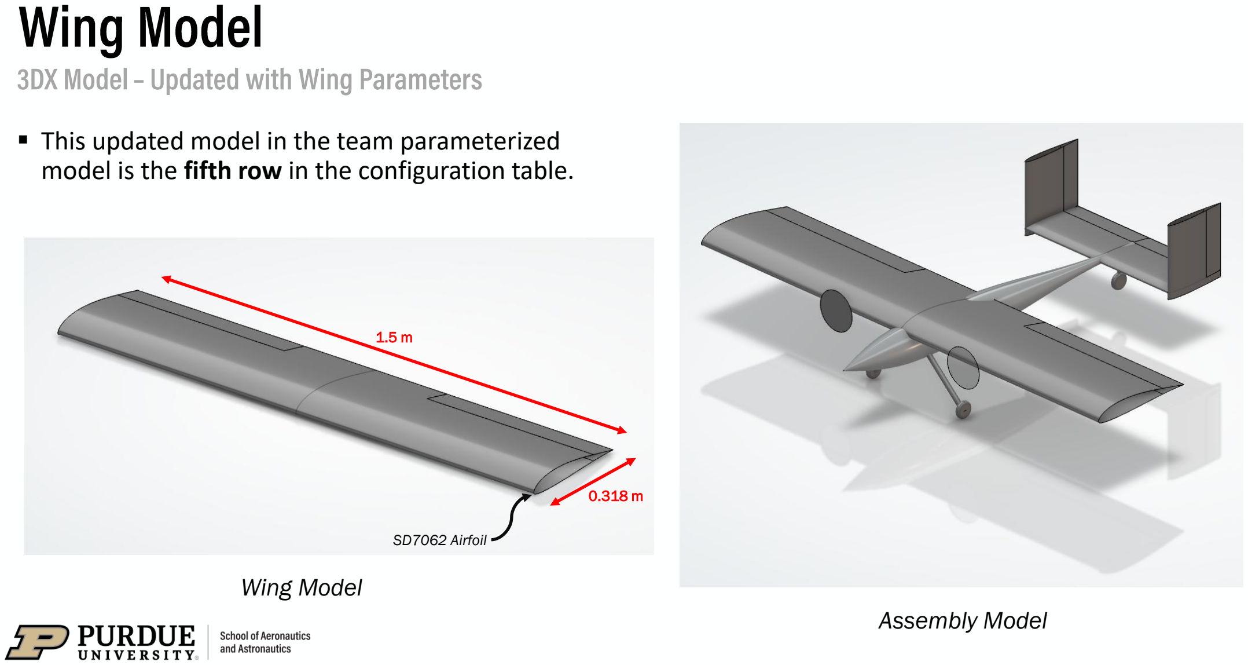
[picture p41: page 12]

model is the fifth row in the configuration table.

# 3DX Model –Updated with Wing Parameters

1.5 m

0.318 m

SD7062 Airfoil

## Wing Model Assembly Model
