HudsonReynolds/451-DBF-Team01/Assignment Deliverables/AAE451B, Team, 01, A6.pdf

# Team 01

9/20/26

# - Electrical power: 406 W per power plant, 812 W total

# - From selected power loading and vehicle weight estimate - Assumptions: - Cruise throttle = 0.75

- ηprop,cruise = 0.75
- ηprop,TO = 0.45

# - ηmotor = 0.80 - ηESC = 0.95

# - Static thrust: 15.24 N - Cruise thrust: 5.59 N

Configuration | Motor | Propeller | ESC | Battery | Pack Voltage | Motor Spec
1 | C-2820/10 | APC 8x4-E | RC Electric Parts Brushless ESC Classic (https://www.rcelectricparts.com/60a-esc---classic-series.html) | Turnigy 4S 4000 mAh 30C | 14.8 V | Link (https://www.innov8tivedesigns.com/images/specs/Cobra_2820-10_Specs.htm)
2 | C-2814/12 | APC 7x4-E | RC Electric Parts Brushless ESC Classic (https://www.rcelectricparts.com/60a-esc---classic-series.html) | Turnigy 4S 4000 mAh 30C | 14.8 V | Link (https://www.innov8tivedesigns.com/images/specs/Cobra_2814-12_Specs.htm)
3 | C-2221/10 | APC 7x6-E | RC Electric Parts Brushless ESC Classic (https://www.rcelectricparts.com/60a-esc---classic-series.html) | Common Sense RC 5200 mAh 50C | 11.1 V | Link (https://www.innov8tivedesigns.com/images/specs/Cobra_2221-10_Specs.htm)
4 | C-2814/10 | APC 7x6-E | RC Electric Parts Brushless ESC Classic (https://www.rcelectricparts.com/60a-esc---classic-series.html) | Common Sense RC 5200 mAh 50C | 11.1 V | Link (https://www.innov8tivedesigns.com/images/specs/Cobra_2814-10_Specs.htm)

# - Propeller data from APC - Data values linearly interpolated from RPM and airspeed/advance ratio inputs - Full throttle RPM determined by checking torque balance and propeller structural limits

# - Minimum of the two values sets maximum RPM

# - Assumed RPM linear with throttle

Config 1 | Factor | Value | Meets Needs?
Motor Input Voltage Range | 11.1-18.5 V | Y
Motor Max Cont. Current | 48 A | Y
Motor Kv | 1170 | Y
Motor Mass | 142 g | Y
Battery Mass | 452 g | N
Prop D, Ground Clearance | 8 in D, 2.5 in Clearance | Y
ESC Rating – Max Motor Current | 12 A | Y
Battery Cells, Discharge Rate | 4 Cells, 30 C Discharge | Y
Connectors | XT60 | Y

# - Meets all criteria except weight budget - Peak efficiency of about 67%

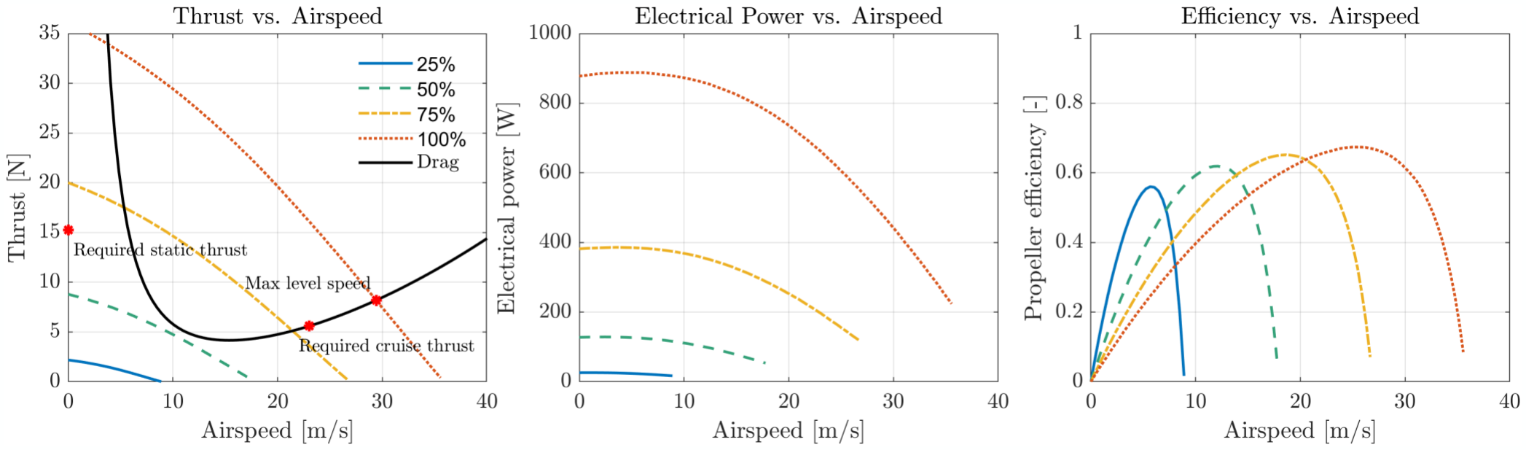
[picture p42: figure]

Config 2 | Factor | Value | Meets Needs?
Motor Input Voltage Range | 11.1-18.5 V | Y
Motor Max Cont. Current | 40 A | Y
Motor Kv | 1390 | Y
Motor Mass | 109 g | Y
Battery Mass | 452 g | N
Prop D, Ground Clearance | 7 in D, 3.5 in Clearance | Y
ESC Rating – Max Motor Current | 20 A | Y
Battery Cells, Discharge Rate | 4 Cells, 30 C Discharge | Y
Connectors | XT60 | Y

# - Meets all criteria except weight budget - Peak efficiency of about 70%

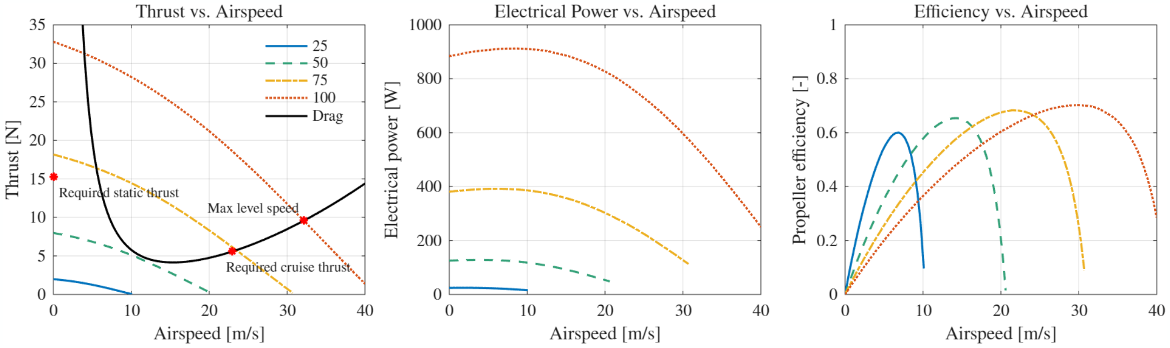
[picture p43: figure]

Config 3 | Factor | Value | Meets Needs?
Motor Input Voltage Range | 11.1-14.8 V | Y
Motor Max Cont. Current | 38 A | Y
Motor Kv | 1500 | Y
Motor Mass | 88 g | Y
Battery Mass | 350 g | Y
Prop D, Ground Clearance | 7 in D, 3.5 in Clearance | Y
ESC Rating – Max Motor Current | 22 A | Y
Battery Cells, Discharge Rate | 3 Cells, 50 C Discharge | Y
Connectors | XT60 | Y

# - Meets all criteria - Peak efficiency of about 78%

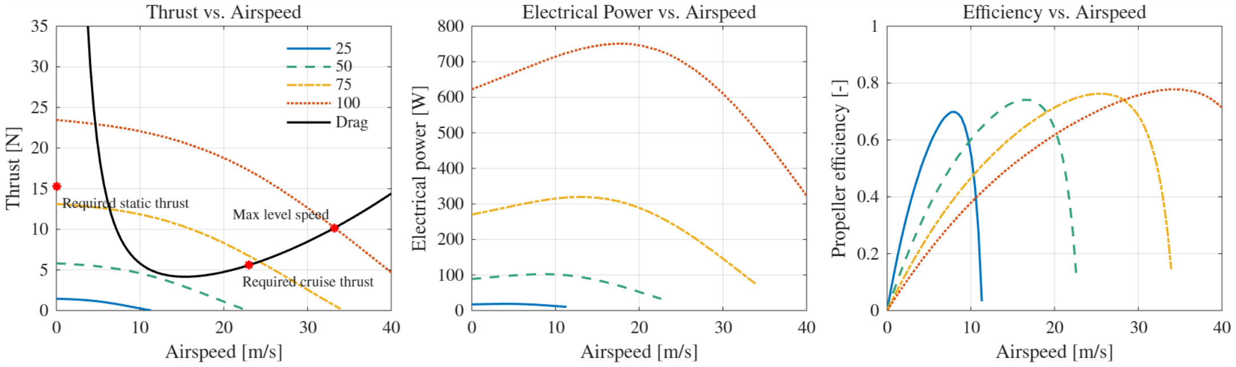
[picture p44: figure]

Config 4 | Factor | Value | Meets Needs?
Motor Input Voltage Range | 11.1-18.5 V | Y
Motor Max Cont. Current | 48 A | Y
Motor Kv | 1700 | Y
Motor Mass (each) | 109 g | Y
Battery Mass | 350 g | Y
Prop D, Ground Clearance | 7 in D, 3.5 in Clearance | Y
ESC Rating – Max Motor Current | 12 A | Y
Battery Cells, Discharge Rate | 3 Cells, 50 C Discharge | Y
Connectors | XT60 | Y

# - Meets all criteria except RFP power limit - Peak efficiency of about 79%

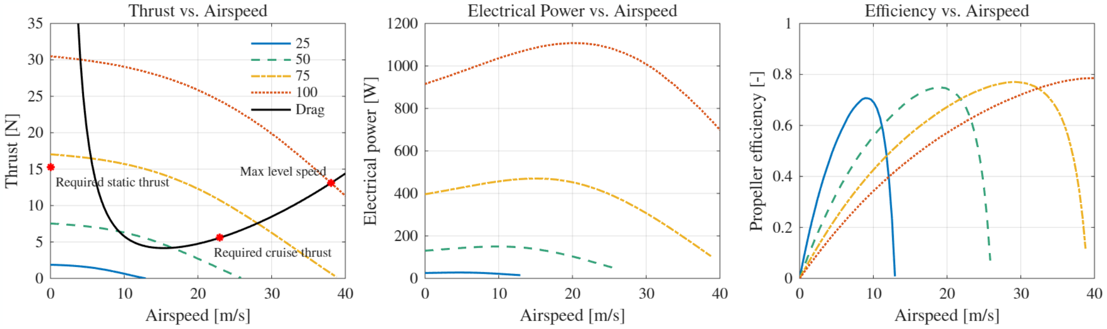
[picture p45: figure]

Component | Selected Part | Cost | Mass
Motor | C-2221/10 (x2) | $65.98 | 176 g
Propeller | APC 7x6-E (x2) | $5.42 | 9 g
ESC | RC Electric Parts Brushless ESC Classic (x2) | $56.98 | 136 g
Battery | Common Sense RC 5200 mAh 50C | $72.09 | 350g
Totals | Config 3 Selected | $200.47 ($215.20 after tax) | 671 g

# CAD Model –Components

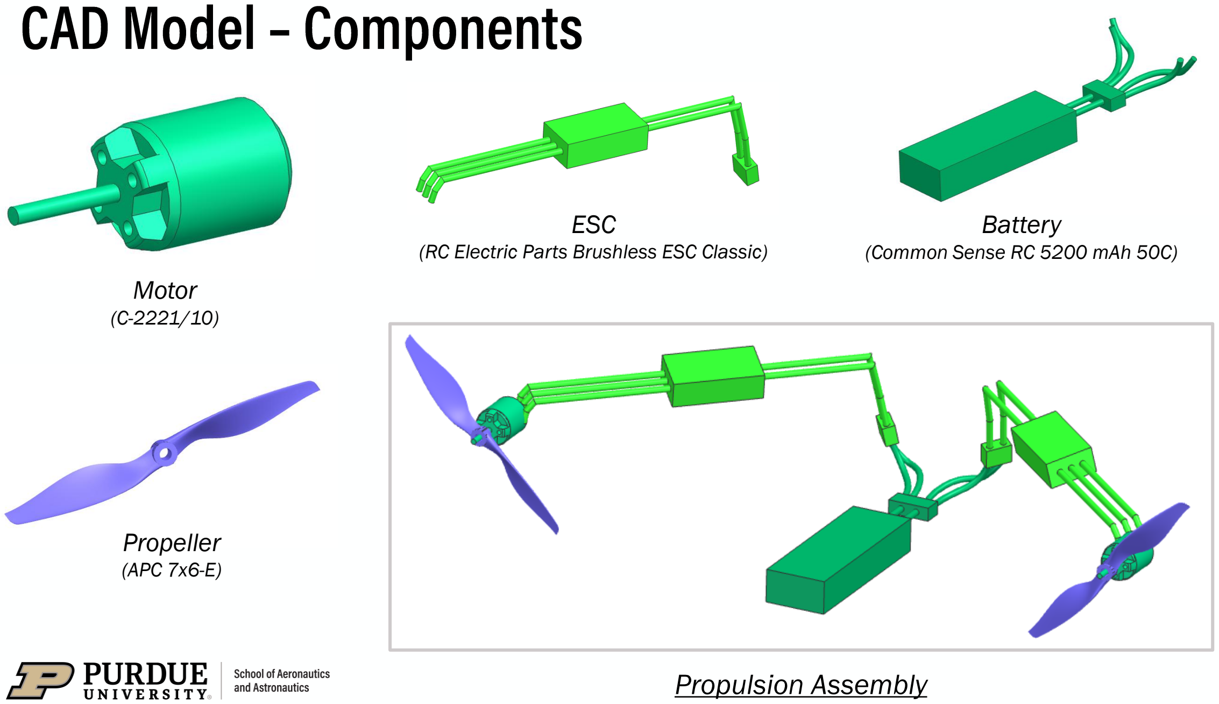
[picture p46: page 10]

## Motor

(C-2221/10)

## Propeller

### (APC 7x6-E)

## Battery

### (Common Sense RC 5200 mAh 50C)

## ESC

### (RC Electric Parts Brushless ESC Classic)

# Propulsion Assembly

# CAD Model –Updated Assembly

- Updated assembly model is in a breakout file from the parameterized model, and lives inside the team

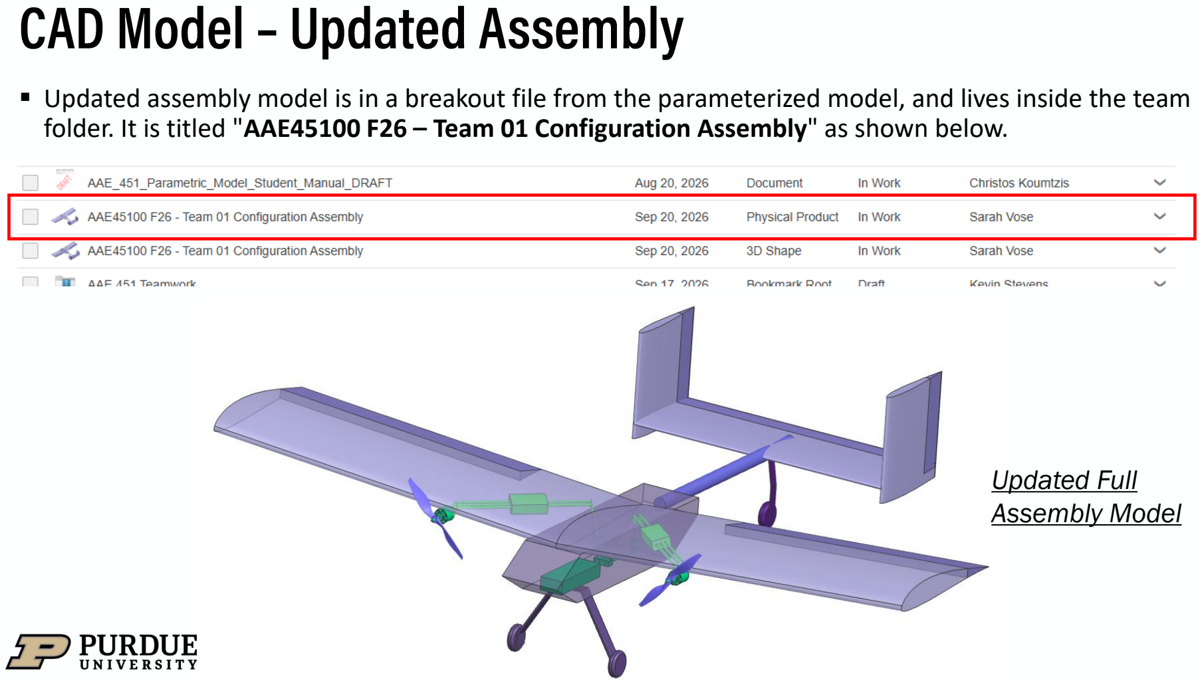
[picture p47: page 11]

folder. It is titled "AAE45100 F26 – Team 01 Configuration Assembly" as shown below.

# Updated Full Assembly Model
