HudsonReynolds/451-DBF-Team01/Assignment Deliverables/Team01_A3 (1).pdf

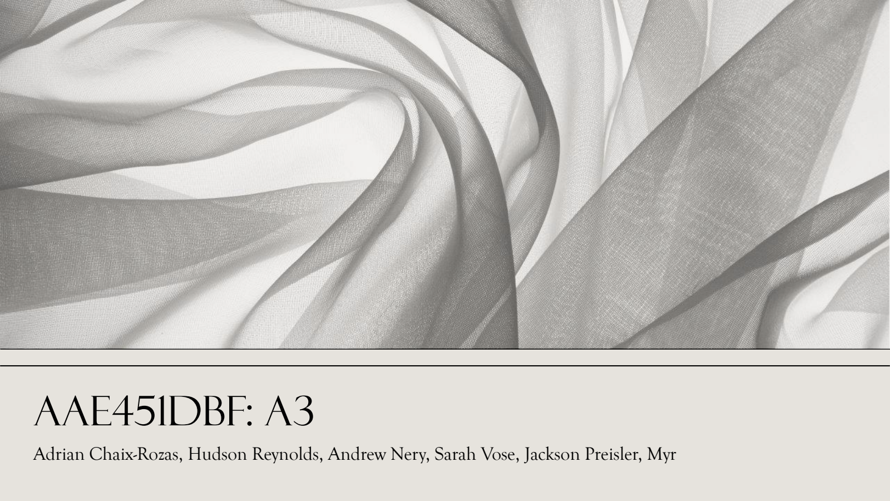
[picture p61: page 1]

## AAE451DBF: A3

Adrian Chaix-Rozas, Hudson Reynolds, Andrew Nery, Sarah Vose, Jackson Preisler, Myr

## Deliverable 1 - Assumptions

Battery Density: 5.27*10⁵

J/kg
- Given in 04 notes. Matches standard values for Li-Po batteries
Motor Efficiency (ηm): 0.7
- Calculated from Cobra Motor Datasheet (https://www.innov8tivedesigns.com/images/specs/Cobra_2820-10_Specs.htm) to be 0.8-0.85, chose 0.7 to be conservative prior to final motor choice. Empty Weight Fraction Estimate (We

): 0.8
- Assume weight fraction on higher end due to lack of DBF experience on team, provide extra margin.
Usable Battery Capacity (80%)
- Taken from Lecture slides.
Temperature Derate (70%)
- 70% efficiency, assuming historical weather data based on Li-Po battery temperature charts. All other assumptions are the same as in A2.

Deliverable 2 – mission Profile & Energy Estimate

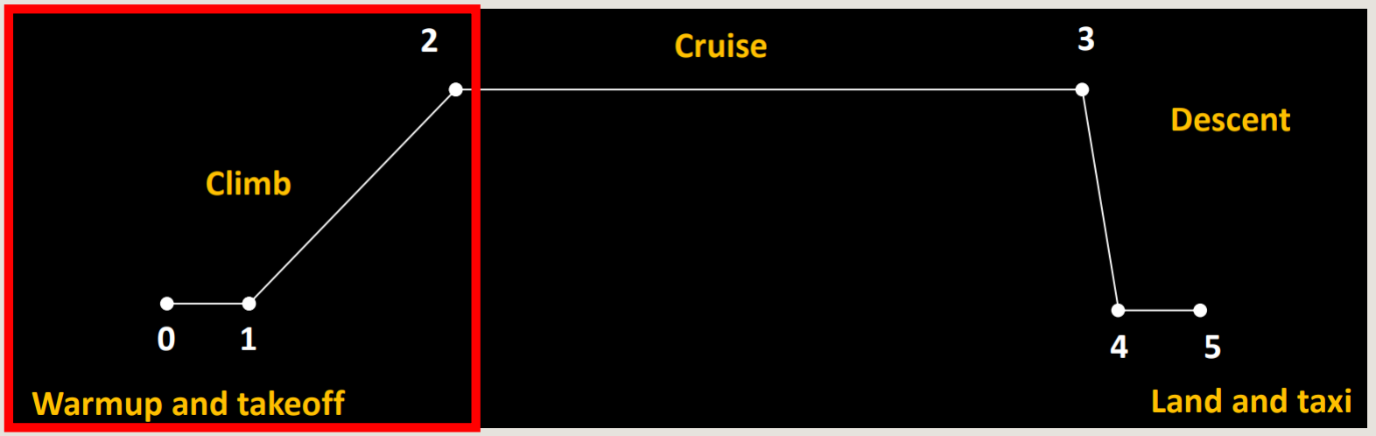
[picture p62: figure]

### 1. Warm Up:

- Equation used:
- Output: 0.0365

### 1. Take Off:

- Equation used:
- Output: 0.0037

### 2. Climb:

- Equation used:
- Output: 0.0017

Deliverable 2 – mission Profile & Energy Estimate

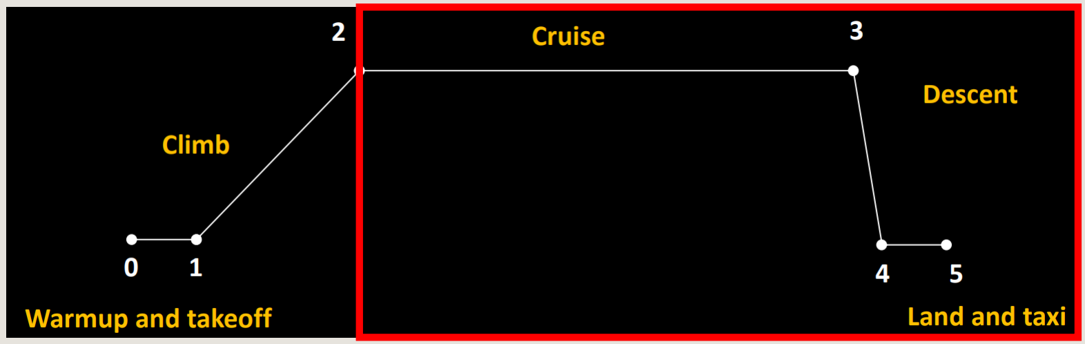
[picture p63: figure]

### 4. Cruise:

- Equation used:
- Output: 0.0027

### 5. Descent: Assumed to be negligible

- Equation used: N/A
- Output: 0

### 6. Land & Taxi: Assumed to be negligible

- Equation used: N/A
- Output: 0
- Energy Margin Calculated:
- Equation used:
- Output: 1.7857

### Deliverable 3 – Empty Weight Fraction

Empty Weight Fraction Estimate: 0.8

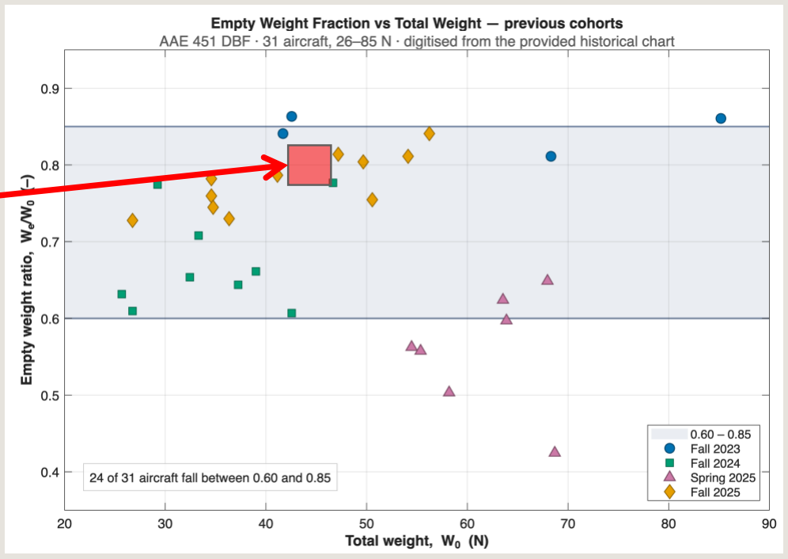
[picture p64: figure]

- Rationale: Assume weight fraction on higher end due to lack of DBF experience on team, provide extra margin

Weight Range Verification: Team 1 Estimate

## Deliverable 4 - MOTW

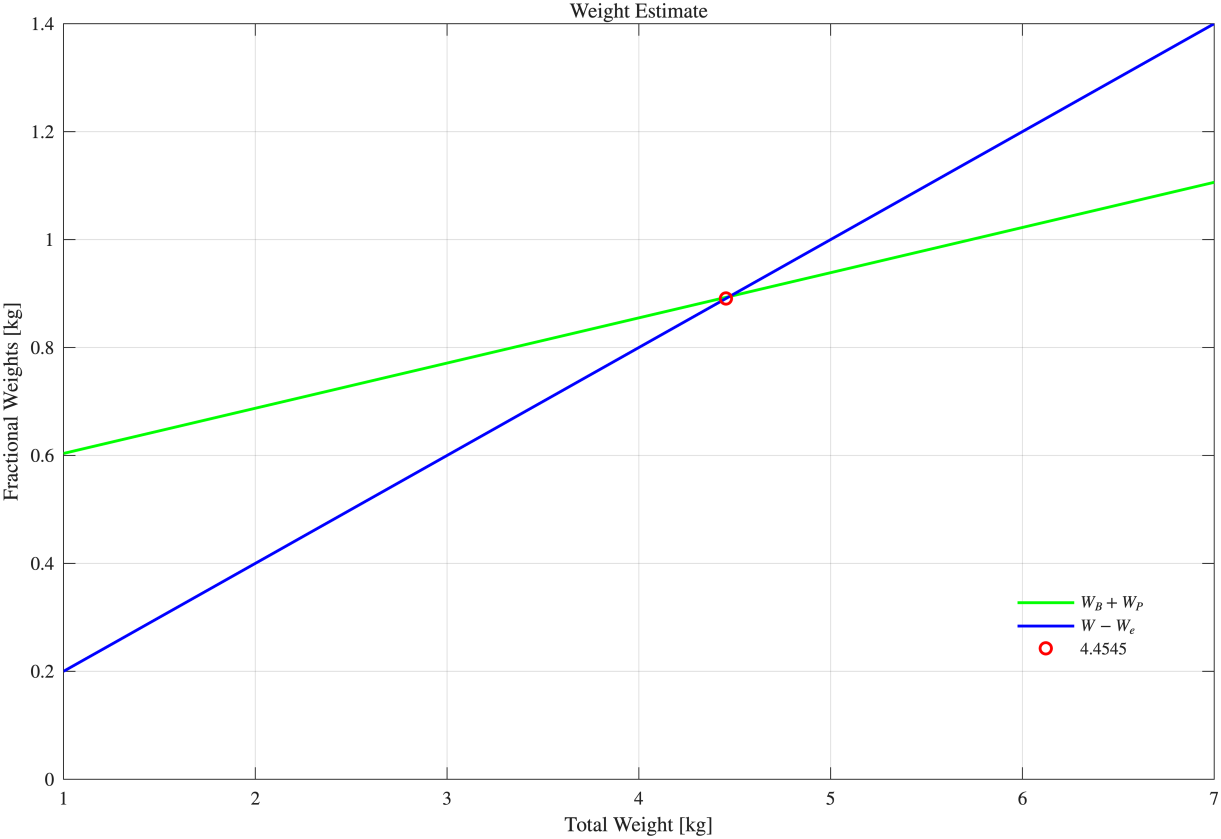
[picture p65: figure]

Equations Used:

1. Weight of the battery is dependent on the total weight, so we vary over a range of values:

### 2. The historical weight estimate relies on the total

weight and historical empty weight fraction values:

Final weight estimate (4.45 kg) is the intersection of these two lines, marked in red on the plot.

## Deliverable 5 – Weight Buildup table

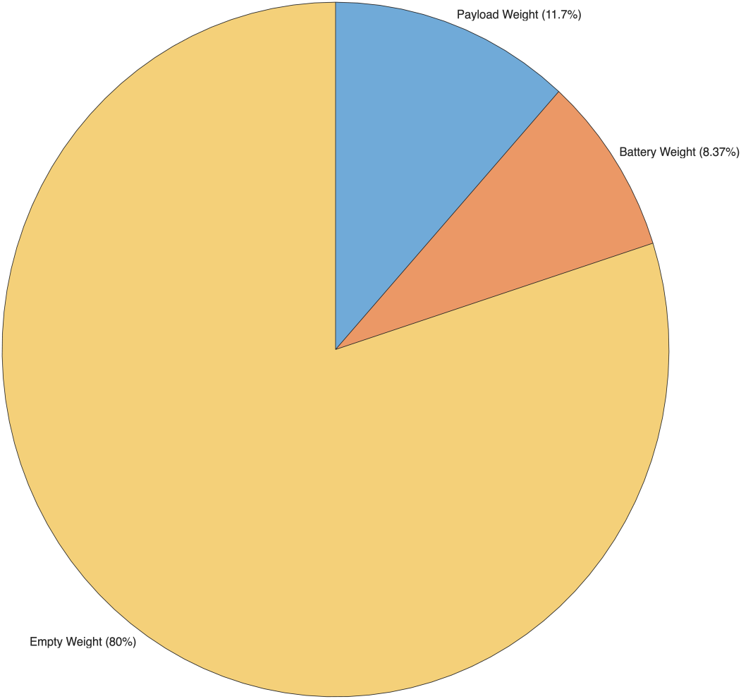
[picture p66: figure]

- 80% of weight for empty weight, based on our assumption
of the empty weight fraction
- 11.7% of the remaining weight is payload weight of 0.52 kg.
- Last 8.37% of the weight is the battery weight (0.373 kg)

Weight Table
Weight Allocation | Weight (kg)
We | 3.56
Wb | 0.37
Wp | 0.52

### Deliverable 6 – total energy calculation

### 1. Actual Energy Required per Flight Phase:

1. Warm Up: 85.7 kJ
2. Take Off: 8.6 kJ
3. Climb: 4.04 kJ
4. Cruise: 5.4 kJ
5. Descent: 0 J
6. Land & Taxi: 0 J

### 2. How Much Energy is Lost:

- 92.2 kJ

### 3. Total Energy Required by Battery:

- 197 kJ
