HudsonReynolds/451-DBF-Team01/Assignment Deliverables/Team01_A5B (1).pdf

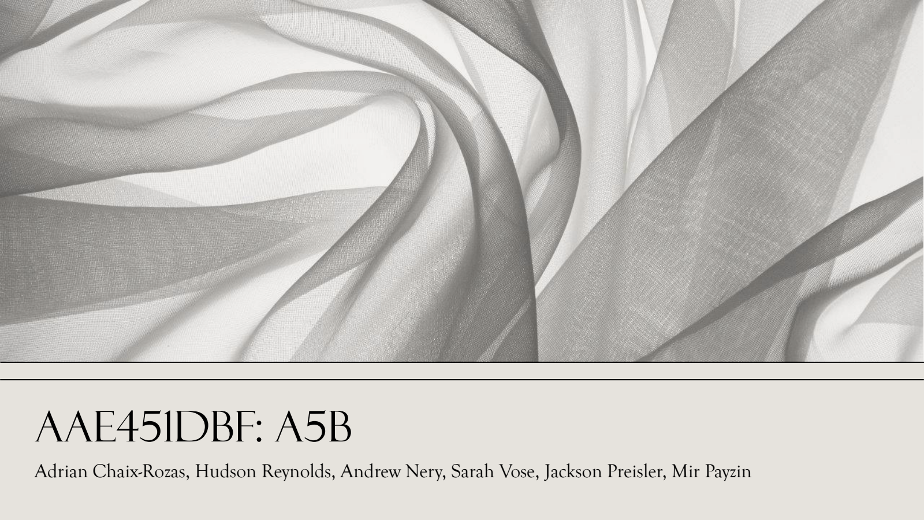
[picture p67: page 1]

## AAE451DBF: A5B

Adrian Chaix-Rozas, Hudson Reynolds, Andrew Nery, Sarah Vose, Jackson Preisler, Mir Payzin

### Deliverable 1 – Horizontal Tail planform

1. Chosen Airfoil for Horizontal Stabilizer: NACA 0010
- Justification: The NACA 0006 and 0008 have really rapid drop offs in the lift curves due to thin airfoil effects, while the NACA 0010 and 0012 do not. The NACA 0012 has higher drag since it is thicker, therefore 0010 is the best choice for this application.
2. Tail Arm – Distance from Wing ¼ chord to Horizontal Tail ¼ chord: 0.7 m
3. Horizontal Tail Area: 0. 106 m2
4. AR: 2.75
5. Taper Ratio: 1
6. Elevator Size – As a % of Wing Chord & Wingspan: 61.64%, based off control authority analysis. Will most likely decrease in future if tail moves back.
7. Additional Tail Parameters Defined in Analysis:
- Taper: N/A
- Sweep: N/A
- Incidence: N/A

Deliverable 2 – Scissor plot and Center-of-gravity limits

1. Scissor Plot Assumptions:
- CM0

is constant over the range of values; CM0

= −0. 08.
- Moment coefficient during rotation is 0.1.
- Elevator Travel Limits is +10°, −20°.
- Max wingspan of 1.5m.
- Wing Stall Angle of Attack is 15.8°.
- CLMAXof the Plane is 90% of the Airfoil’s CL.
2. Neutral Point – As a Fraction of Mean Aerodynamic Chord: 0.409.
3. Horizontal Tail Area: 0. 106 m2
4. CG target: 0.259 (% of MAC).
5. Chosen SM: 0.15.
6. See Scissor Plot in next slide.

# Scissor plot

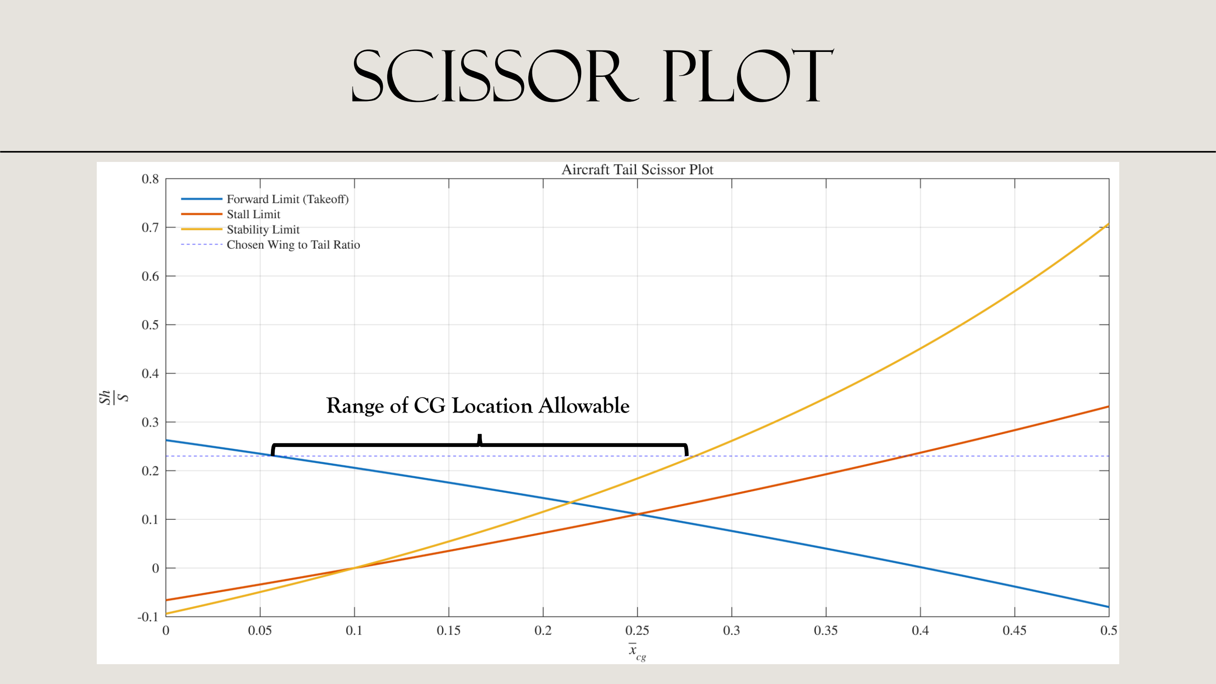
[picture p68: page 4]

Range of CG Location Allowable

## Deliverable 3 – Trim analysis

1. Elevator Deflection Required for Trim – Full Flight Envelope @ CG limits: Worst Case, 1° margin for Foreword Most CG.
2. See following slides for Drap Polar and Trim Envelope plots.

# Drag Polars

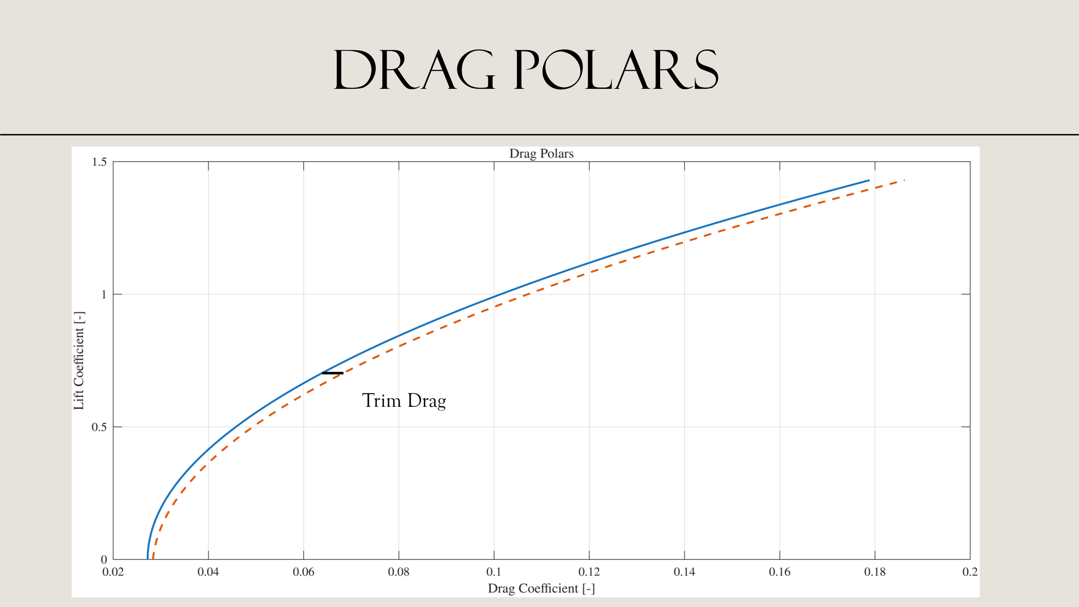
[picture p69: page 6]

Trim Drag

## Trim Envelope

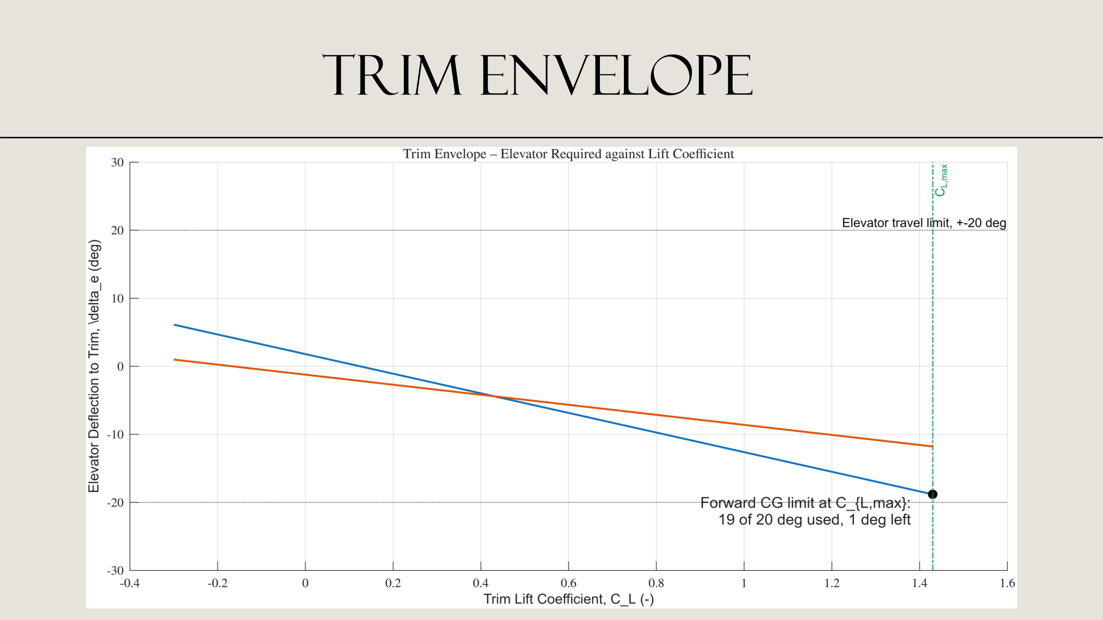
[picture p70: page 7]

### Deliverable 4 – Control surface sizing

1. Elevator, Ailerons, and Rudder Sizing – Stating Chord & Span Fraction for Each:
- Elevator Chord Fraction: 30%, Span Fraction: 100%.
- Aileron Chord Fraction: 25%, Span Fraction: 70-100% (per side).
- Rudder Chord Fraction: 30%, Span Fraction: 100%.
2. Authority Demonstration Against Following Criteria:
- Elevator – Trim at Forward CG limit, Max Lift Coefficient, with travel margin: 1° of travel margin at Forward CG Limit, assuming 20° control actuation limit.
- Ailerons – Roll rate target at airspeed and source: 120 deg/s, per flight turning speed wanted.
- Rudder – Crosswind / Engine Out Condition, state chosen crosswind ratio: 20% Crosswind Ratio.

### Deliverable 5 – Stability derivatives

1. Report Longitudinal Derivatives – Lift Curve Slop & Pitching Moment Slope, state CG they were computed at:
- CMα

= -0.835 rad/s (assuming design cg = 0.259).
- Static Margin: 0.15 (assuming design cg = 0.259).
- CLα

= 5.564 rad/s (assuming design cg = 0.259).

2. Report Lateral-Directional Derivates – Yawing & Rolling Moment due to sideslip, check against expected range for a stable aircraft of this class:
- CNβ

= 0.1676 rad/s (expected range 0.05 to 0.15).

- CLβ

= -0.1452 rad/s at 4° dihedral (expected range –0.05 to –0.2).

3. Report Dihedral, show effect on Rolling Moment: 4° Up, Effect on Rolling Moment is -0.1359 rad/s.

### Deliverable 6 – Tail models in 3dx

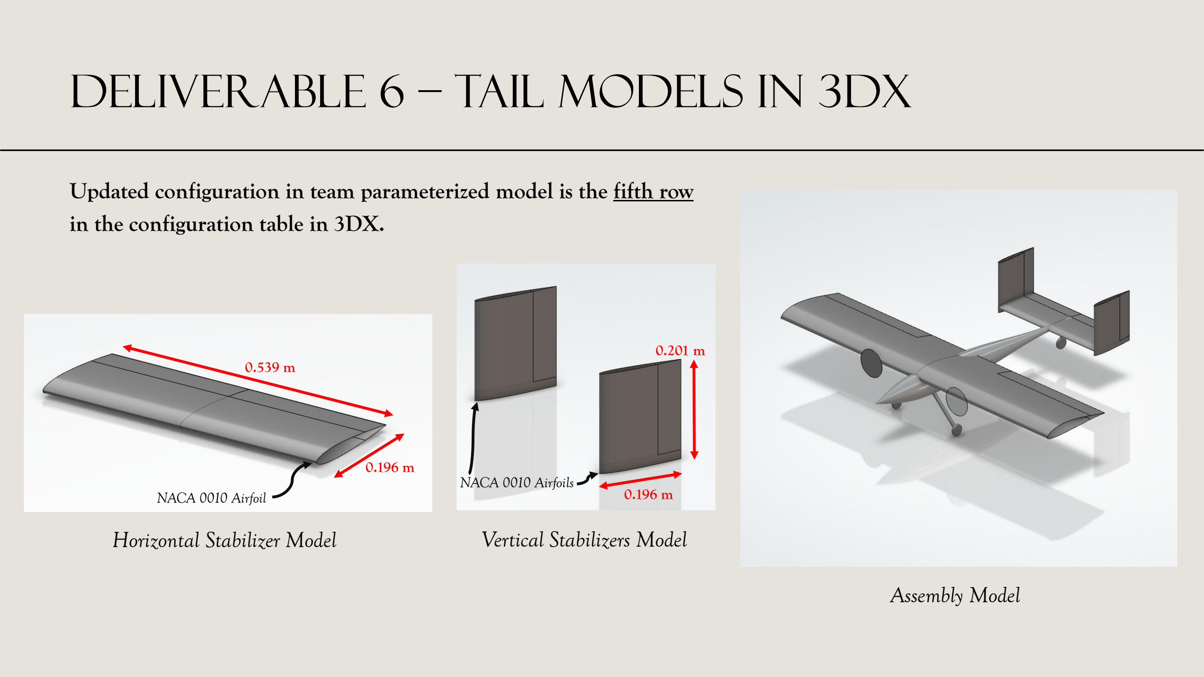
[picture p71: page 10]

Updated configuration in team parameterized model is the fifth row in the configuration table in 3DX.

0.539 m

0.196 m
NACA 0010 Airfoil | 0.196 m

0.201 m

NACA 0010 Airfoils

Horizontal Stabilizer Model | Vertical Stabilizers Model

Assembly Model
