HudsonReynolds/451-DBF-Team01/Assignment Deliverables/Team01_TraceabilityMatrix.pdf

## Team01_StakeholderNeeds

## Cat1 Mission Capability

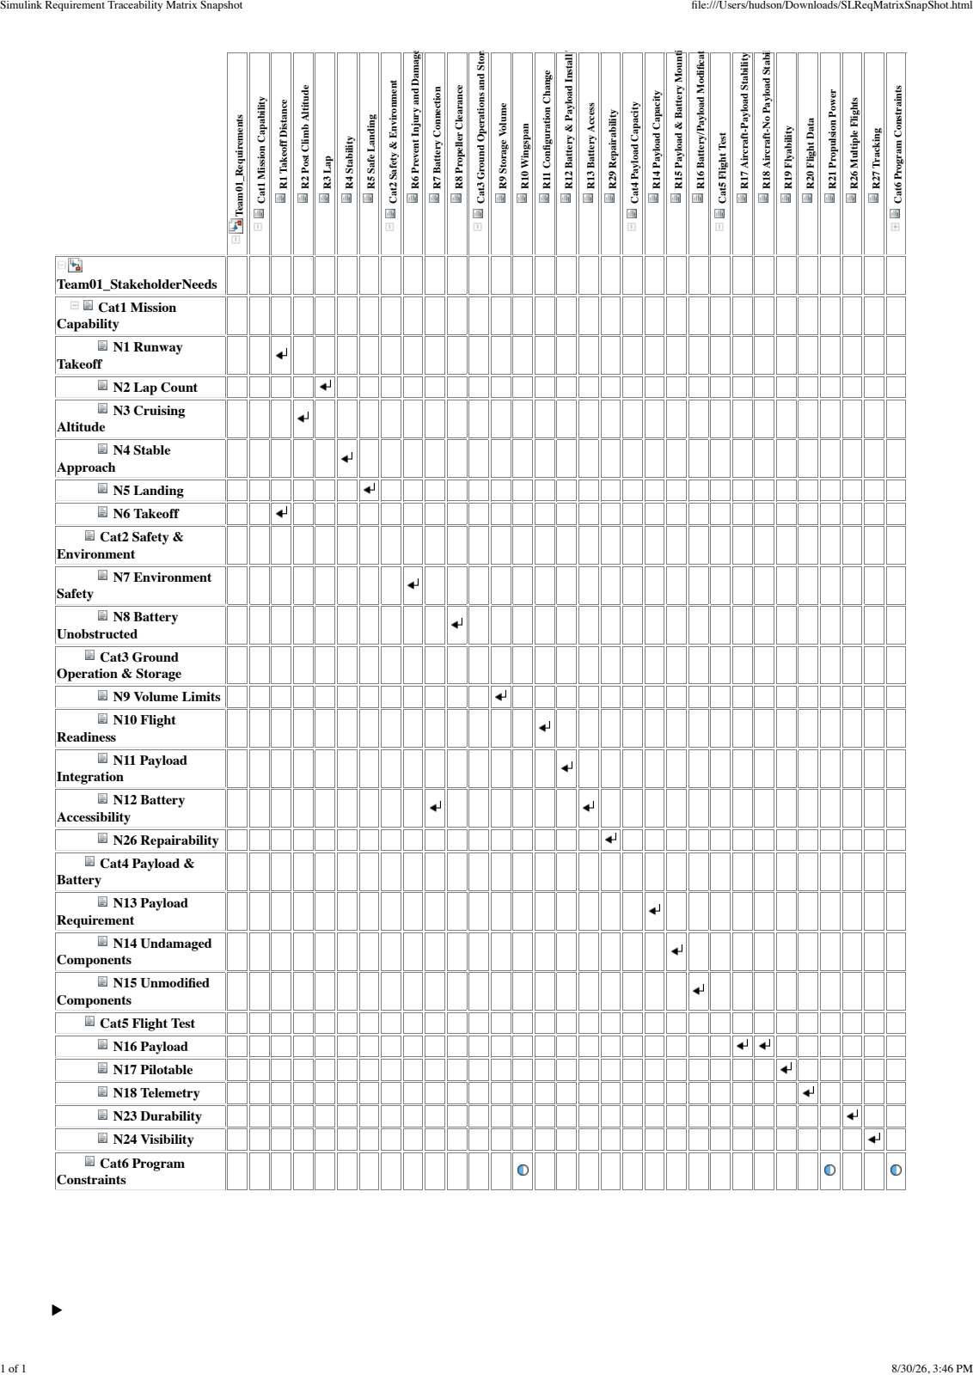
[picture p72: page 1]

Team01_Requirements

Cat1 Mission Capability
R1 Takeoff Distance

R2 Post Climb Altitude

R3 Lap

R4 Stability

R5 Safe Landing

Cat2 Safety & Environment

R6 Prevent Injury and Damage

R7 Battery Connection

R8 Propeller Clearance

Cat3 Ground Operations and Storage

R9 Storage Volume

R10 Wingspan

R11 Configuration Change

R12 Battery & Payload Install Time

R13 Battery Access
R29 Repairability

Cat4 Payload Capacity

R14 Payload Capacity

R15 Payload & Battery Mounting

R16 Battery/Payload Modifications

Cat5 Flight Test

R17 Aircraft-Payload Stability

R18 Aircraft-No Payload Stability

R19 Flyability

R20 Flight Data

R21 Propulsion Power
R26 Multiple Flights

R27 Tracking

Cat6 Program Constraints

## N1 Runway Takeoff

## N2 Lap Count

## N3 Cruising Altitude

## N4 Stable Approach

## N5 Landing

## N6 Takeoff

## Cat2 Safety & Environment

## N7 Environment Safety

## N8 Battery Unobstructed

## Cat3 Ground Operation & Storage

## N9 Volume Limits

## N10 Flight Readiness

## N11 Payload Integration

## N12 Battery Accessibility

## N26 Repairability

## Cat4 Payload & Battery

## N13 Payload Requirement

## N14 Undamaged Components

## N15 Unmodified Components

## Cat5 Flight Test

## N16 Payload

## N17 Pilotable

## N18 Telemetry

## N23 Durability

## N24 Visibility

## Cat6 Program Constraints

▶

Simulink Requirement Traceability Matrix Snapshot | file:///Users/hudson/Downloads/SLReqMatrixSnapShot.html
1 of 1 | 8/30/26, 3:46 PM
