HudsonReynolds/451-DBF-Team01/Assignment Deliverables/Team01_Intro.pdf

## AAE 451 – DBF: Team 1

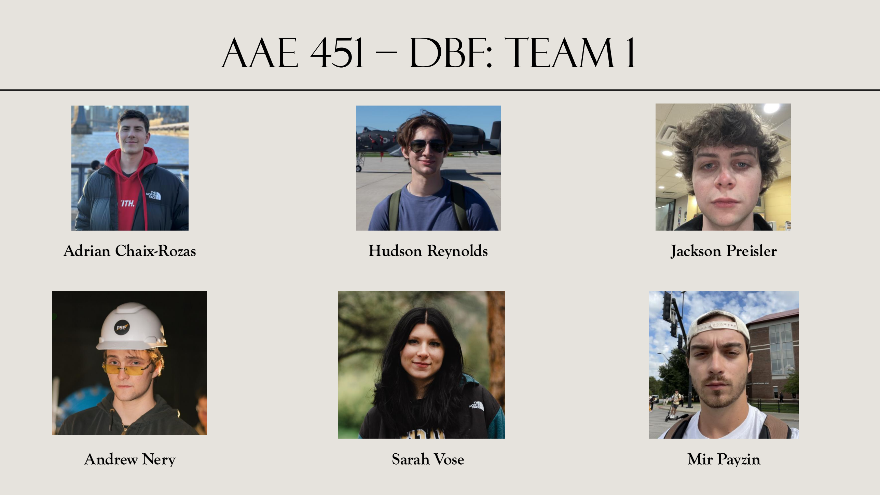
[picture p73: page 1]

Adrian Chaix-Rozas | Hudson Reynolds | Jackson Preisler
Andrew Nery | Sarah Vose | Mir Payzin
