HudsonReynolds/451-DBF-Team01/Plots/Aircraft_Trim_v_Trim_CL.png

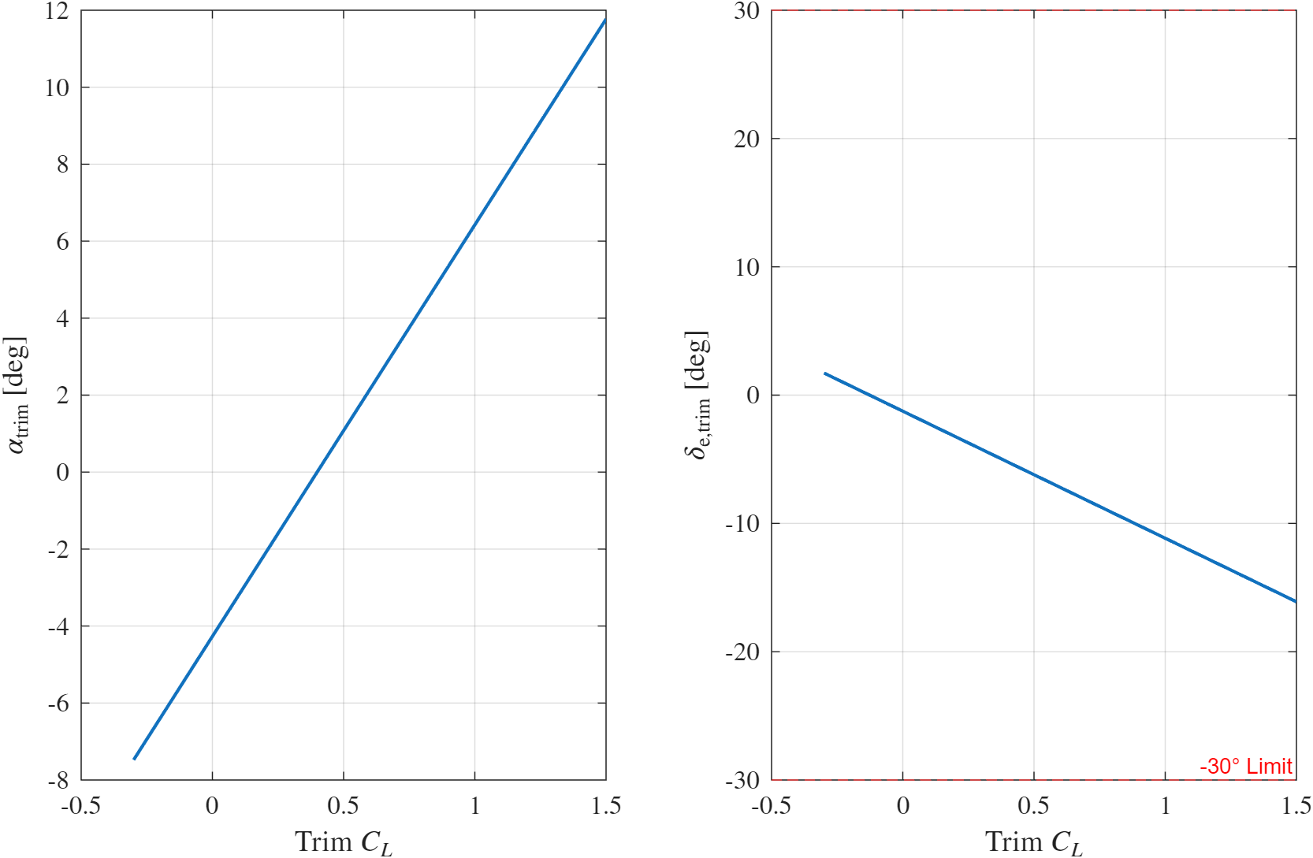
Plots/Aircraft_Trim_v_Trim_CL.png
