HudsonReynolds/451-DBF-Team01/Plots/Drag_Polars.png

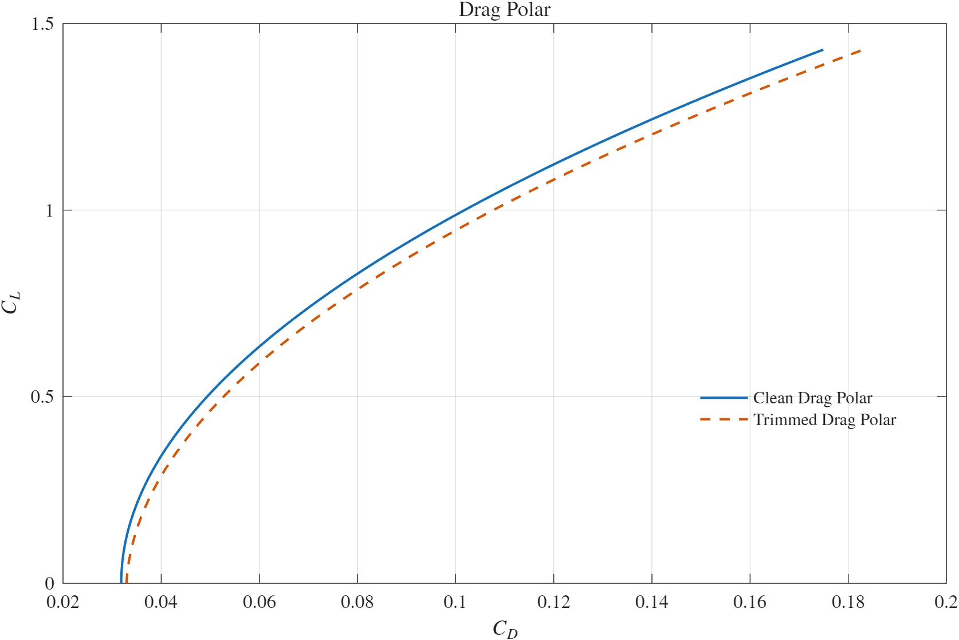
Plots/Drag_Polars.png
