HudsonReynolds/451-DBF-Team01/Plots/Fuselage_Cases.png

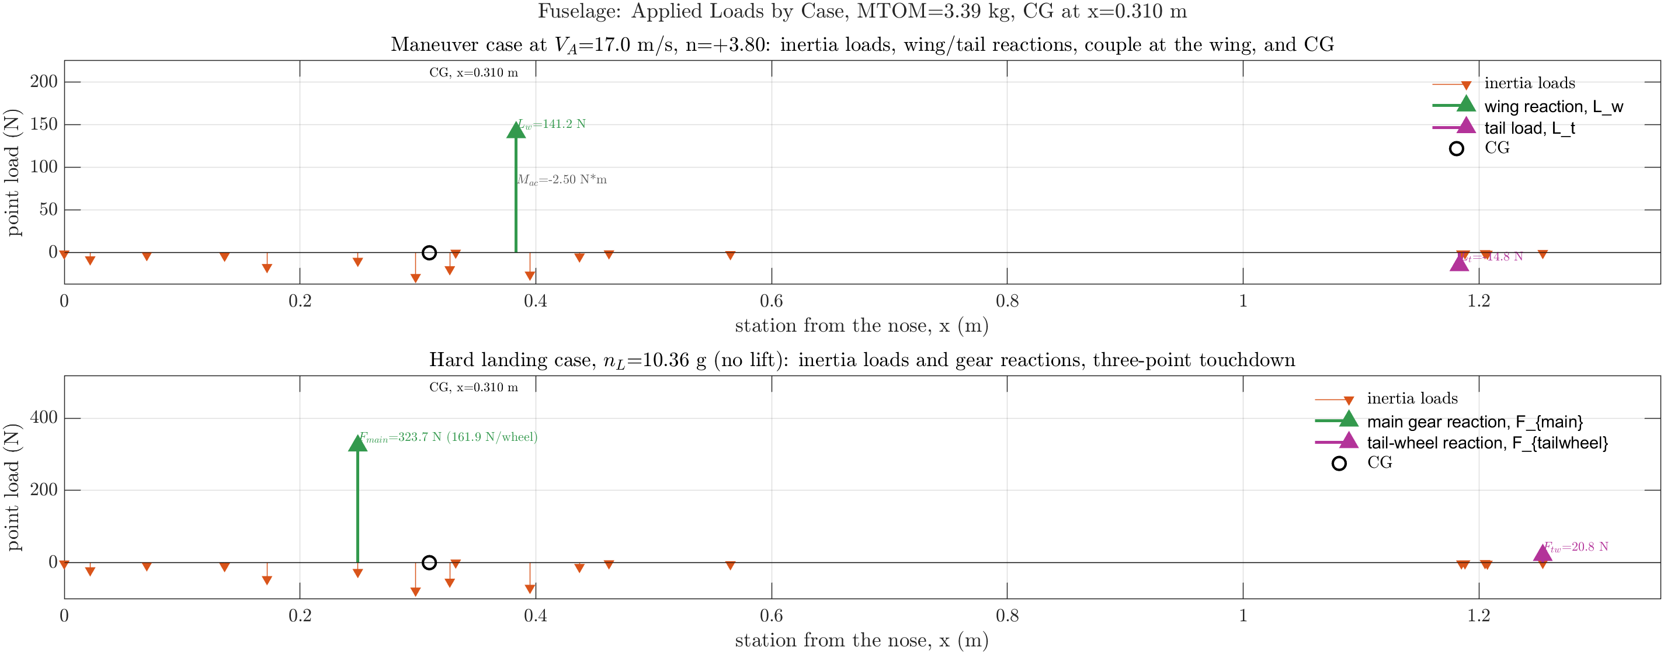
Plots/Fuselage_Cases.png
