HudsonReynolds/451-DBF-Team01/Plots/Fuselage_Loads.png

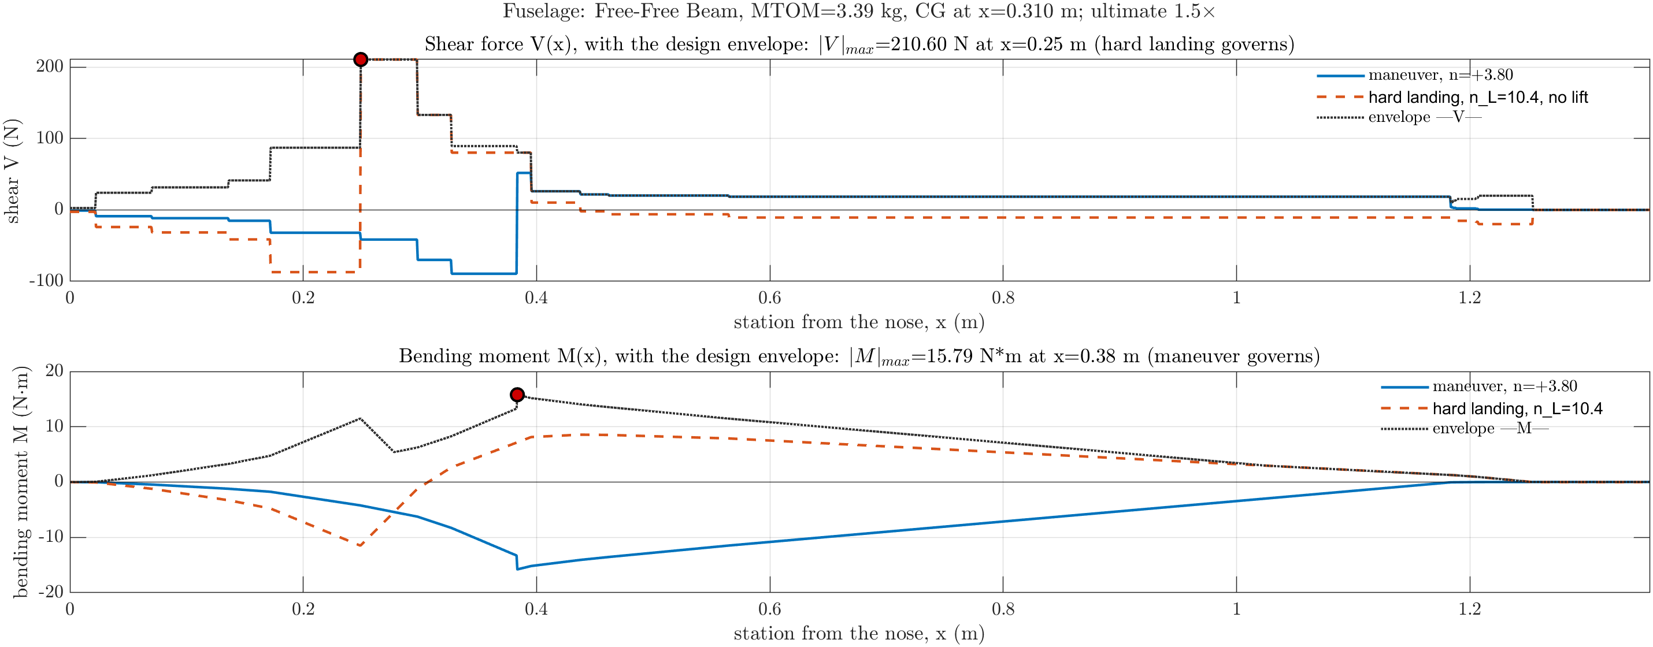
Plots/Fuselage_Loads.png
