HudsonReynolds/451-DBF-Team01/Plots/Landing_Gear_Placement.png

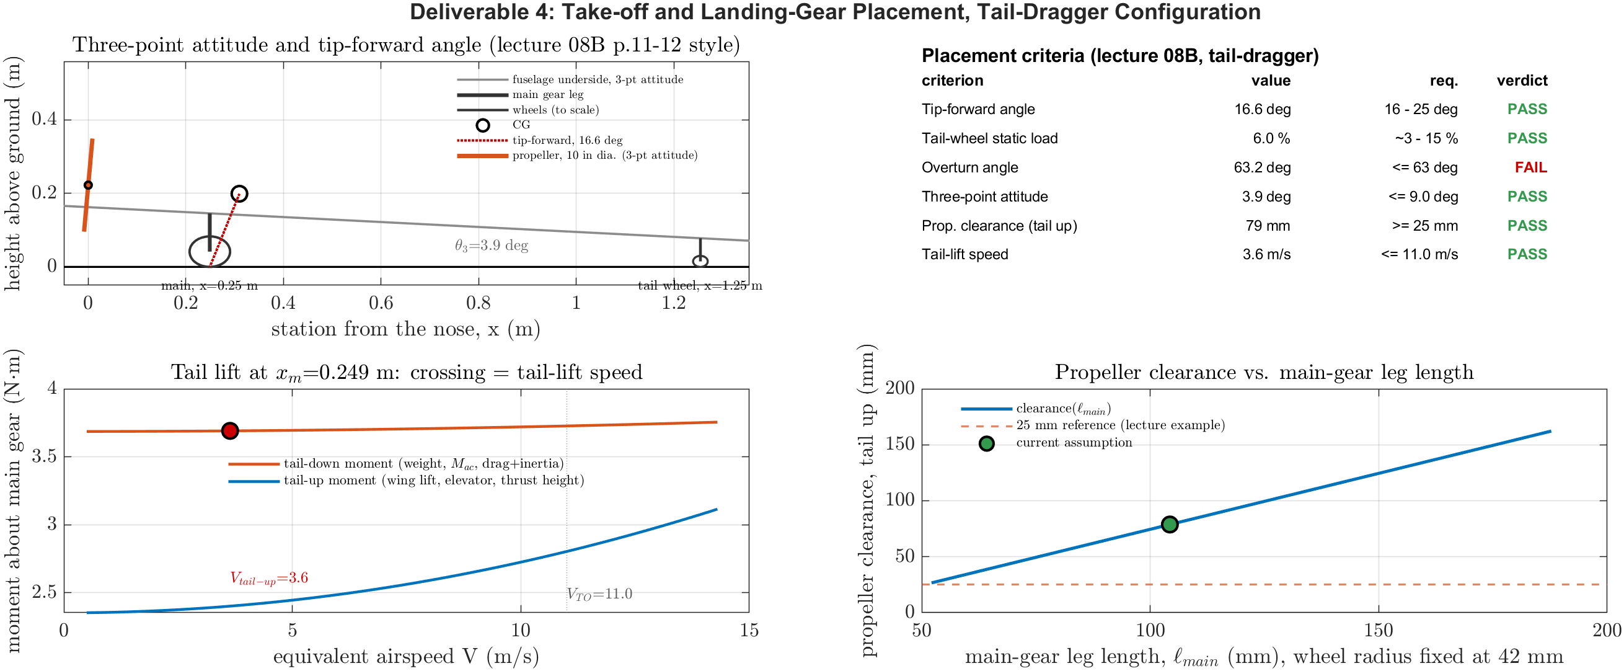
Plots/Landing_Gear_Placement.png
