HudsonReynolds/451-DBF-Team01/Plots/Tail_Loads_Horizontal_Tail_Symmetric_.png

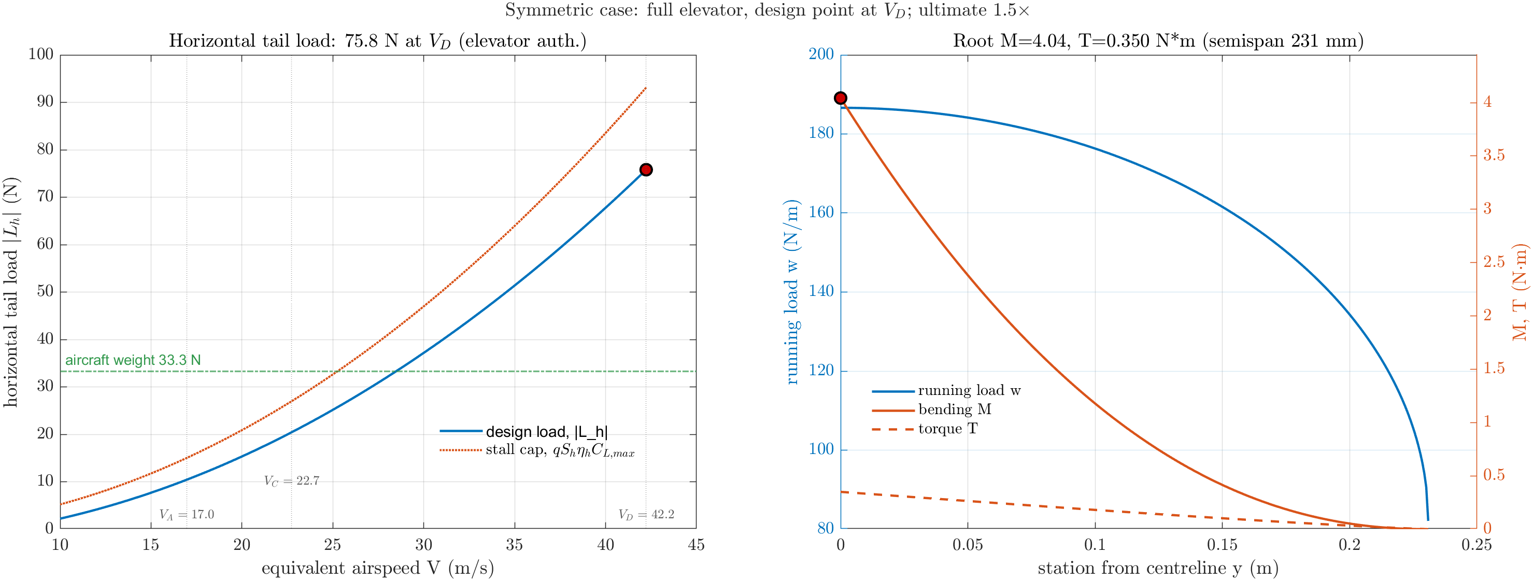
Plots/Tail_Loads_Horizontal_Tail_Symmetric_.png
