HudsonReynolds/451-DBF-Team01/Plots/Tail_Loads_Vertical_Tail_Asymmetric_Rudder_.png

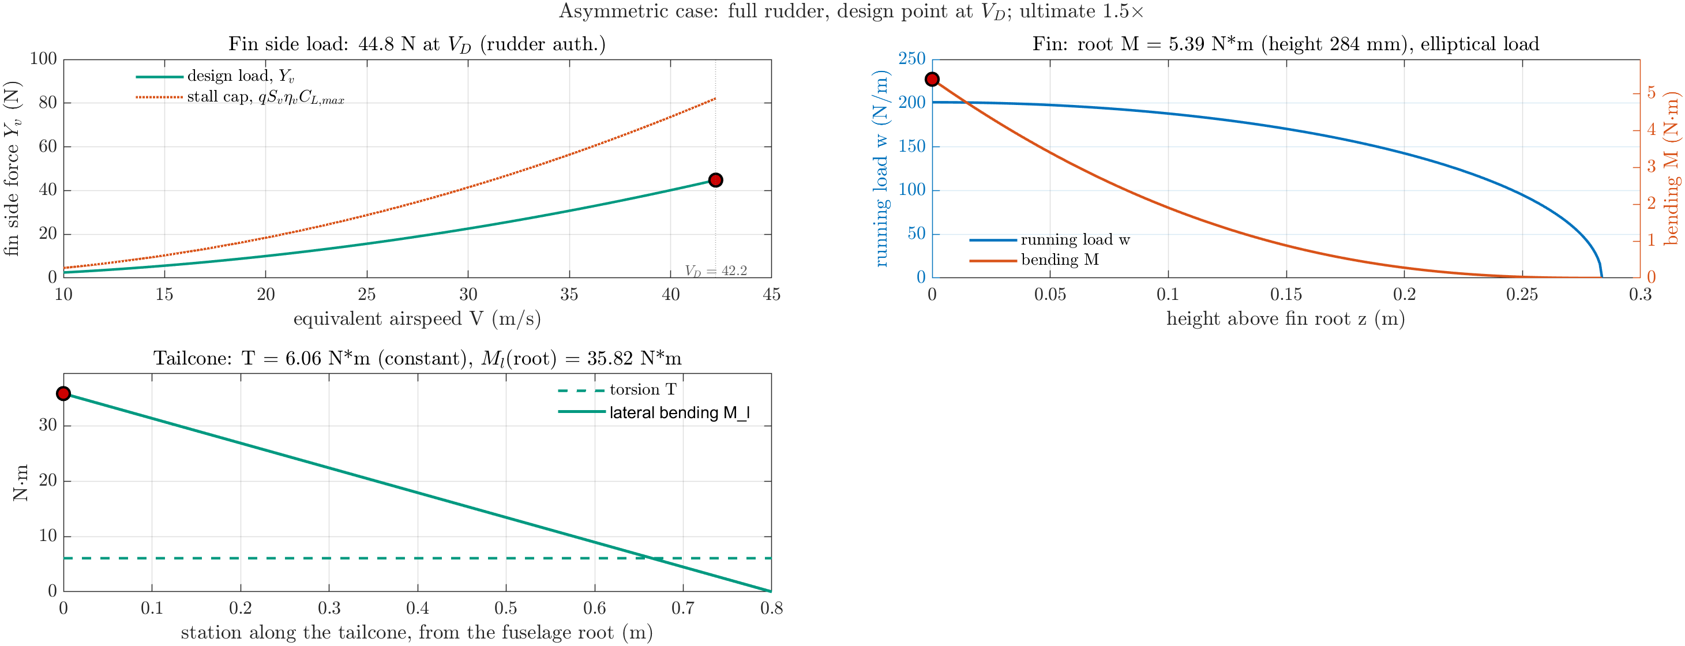
Plots/Tail_Loads_Vertical_Tail_Asymmetric_Rudder_.png
