HudsonReynolds/451-DBF-Team01/Plots/Wing_Loads_Positive_Symmetric.png

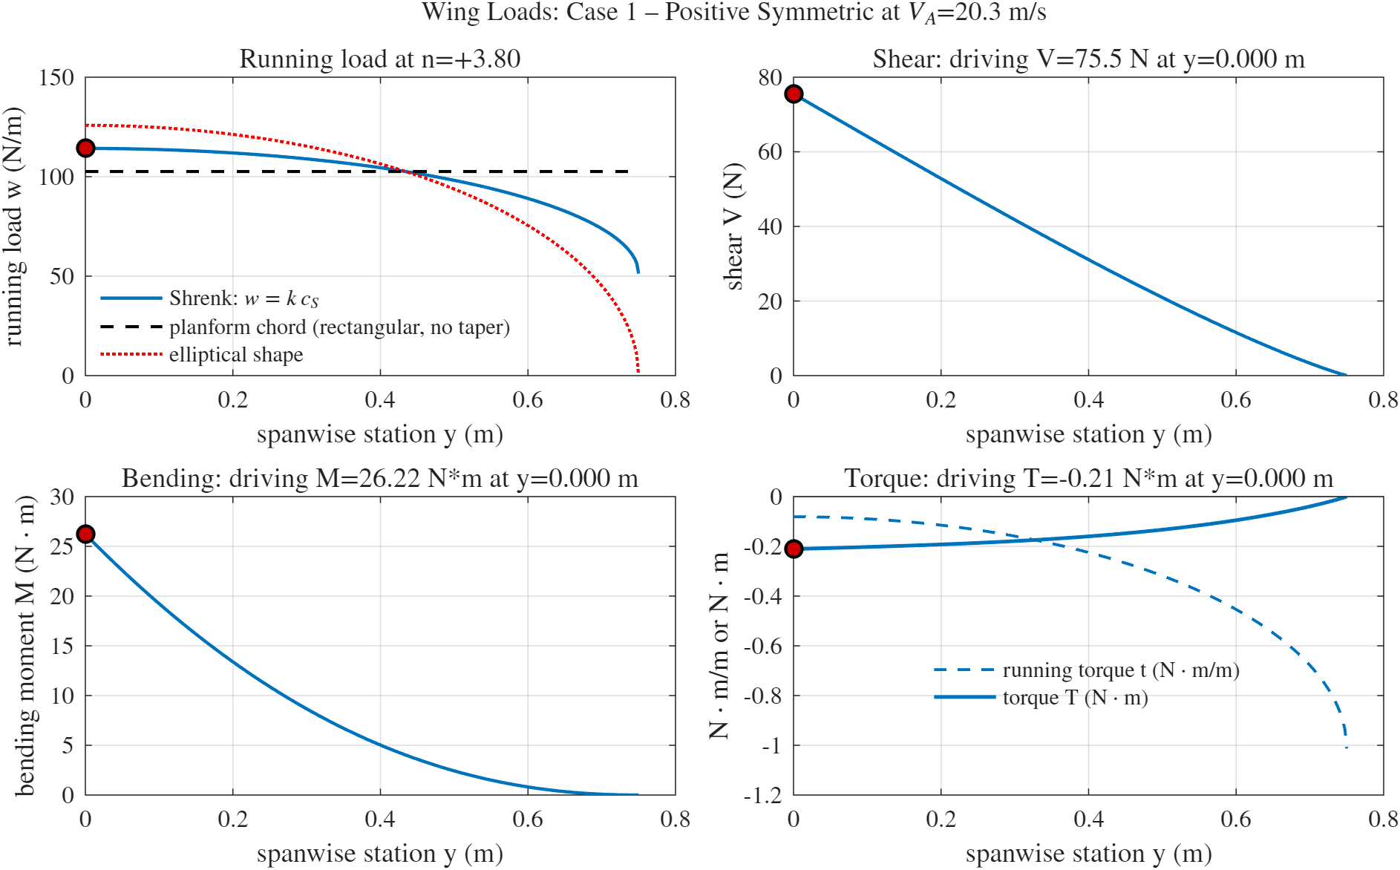
Plots/Wing_Loads_Positive_Symmetric.png
