HudsonReynolds/451-DBF-Team01/Plots/Wing_Loads_Rolling_Maneuver.png

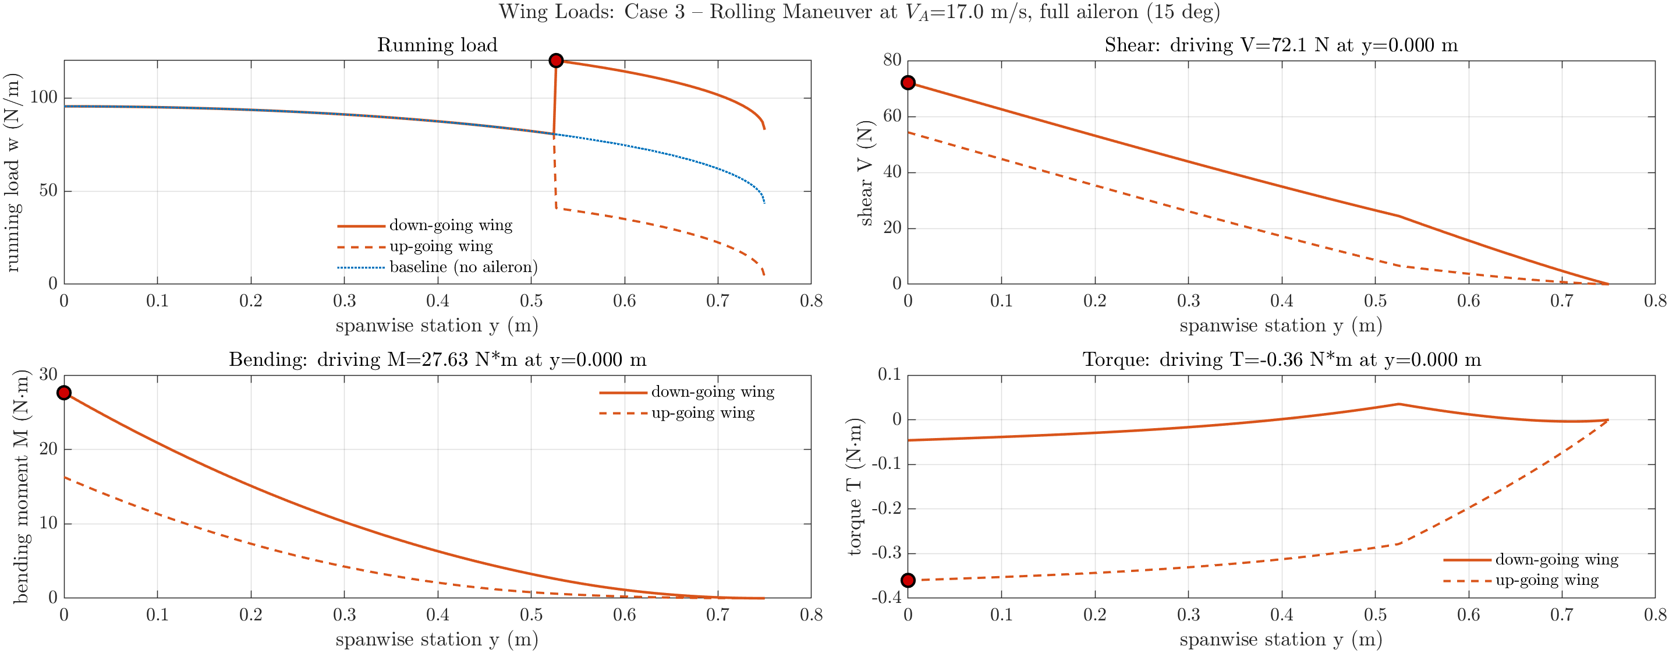
Plots/Wing_Loads_Rolling_Maneuver.png
