HudsonReynolds/451-DBF-Team01/CostBreakdown.xlsx

Sheet: Aircraft Cost Grand Total
Total Cost | $379.50

Sheet: Per Assembly Cost -->
Assembly | Total Cost
Avionics | 15.12
Structures | 165.943
Mechanism | 57.22066667
Propulsion | 141.22

Sheet: Avionics BOM
Part | Type | Quantity | Total Cost | LAB STOCK? | Link
Servo Extension Wires 36 in | Purchased | 4 | 7.16 | Y | https://www.readymaderc.com/products/details/90cm-36in-jr-22awg-servo-cable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
Servo extension wire 24 in | Purchased | 1 | 1.59 | Y | https://www.readymaderc.com/products/details/60cm-24-inch-jr-style-22awg-twisted-servo-cable
Battery Strap | Purchased | 3 | 2.97 | Y | https://www.readymaderc.com/products/details/strix-battery-strap-20-300-mm-2pcs
Zip Ties | Purchased | 20 | 2.40 | Y | https://www.mcmaster.com/2113N16/
Airspeed Sensor Print ABS | Printed | 1 | 1 | Printed | https://us.store.bambulab.com/products/pla-basic-filament?id=42844629008520

Sheet: Structures BOM
Part | Type | Quantity | Total Cost | LAB STOCK? | Link
Birch plywood .205 In | Purchased | 2ft x 4ft | 8.08 | Y | https://www.homedepot.com/p/SANDEPLY-5-2mm-Sandeply-Plywood-1-4-in-Category-Common-1-4-in-x-4-ft-x-8-ft-Actual-0-205-in-x-48-in-x-96-in-479023/203414042
Foam Board 2 in thickness | Purchased | 1.5 x 8ft | 20.85 | Y | https://www.homedepot.com/p/Owens-Corning-FOAMULAR-NGX-F-250-2-in-x-4-ft-x-8-ft-SSE-R-10-XPS-Rigid-Foam-Board-Insulation-52DDNGX/315197962
M4 30mm bolt | Purchased | 5 | 2.97 | N | https://www.mcmaster.com/products/91290a172/
M4 25mm bolt | Purchased | 25 | 4.6 | N | https://www.mcmaster.com/products/91274a122/
M4 60mm bolt | Purchased | 25 | 5.55 | N | https://www.mcmaster.com/products/91290a647/
M4 x 0.7mm washer | Purchased | 100 | 3.93 | N | https://www.mcmaster.com/products/93475a230/
M4 think locknut | Purchased | 25 | 7.14 | N | https://www.mcmaster.com/products/90453a112/
1/16 x 1/2 x 1/2 aluminum tube - 6ft | Purchased | 1 | 24.6 | N | https://www.mcmaster.com/products/6546k49/
1/16 x 1/2 x 1/2 aluminum tube - 3ft | Purchased | 1 | 14.27 | N | https://www.mcmaster.com/products/6546k49/
1ft x 1.125 x 1.125 in extruded L Aluminum | Purchased | 1 | 3.94 | N | https://www.mcmaster.com/products/8982k6/
Gorilla Wood Glue | Purchased | 6 oz | 3.74 | Y | https://www.homedepot.com/p/Gorilla-8-oz-Wood-Glue-Natural-62000/100672167
Gorilla Super Glue | Purchased | 15g | 5.99 | Y | https://www.homedepot.com/p/Gorilla-25g-Super-Glue-XL-7400202/329800516
Aluminum 40mm x 8 mm OD Spacer | Purchased | 4 | 9.84 | N | https://www.mcmaster.com/94669A135/
Foam Adhesive Tape | Purchased | 12 ft | 4.07 | Y | https://www.homedepot.com/p/Owens-Corning-HomeSealR-3-in-x-180-ft-Foam-Board-Joint-Tape-1441820/300223152
Tail Mount Print ABS | Printed | 1 | 1 | Printed | https://us.store.bambulab.com/products/abs-filament
Wing Dihedral Print ABS | Printed | 1 | 0.5 | Printed | https://us.store.bambulab.com/products/pla-basic-filament?id=42844629008520
Motor Cover Print PETG | Printed | 1 | 2 | Printed | https://us.store.bambulab.com/products/petg-basic
3m double sided tape | Purchased | 6 ft | 0.51 | Y | https://www.uline.com/Product/Detail/S-24954/3M-Double-Sided-Tape/3M-GPT-020-Double-Coated-Tape-1-2-x-55-yds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
adhesive velcro singe sided | Purchased | 1.5 ft | 2.48 | Y | https://www.homedepot.com/p/VELCRO-5-ft-x-3-4-in-Sticky-Back-Tape-90086/202261917
Duct tape | Purchased | 10 ft | 0.39 | Y | https://www.homedepot.com/p/Duck-Pro-1-88-in-x-60-yds-Silver-All-Purpose-Duct-Tape-242760/309334754
Bambu Skewers | Purchased | 1 | 0.03 | Shared | https://www.homedepot.com/p/GrillPro-100-Piece-12-in-Bamboo-Skewers-11070/322906473
JB WELD | Purchased | 1/2 package | 3.49 | Y | https://www.homedepot.com/p/J-B-Weld-Two-1-oz-Twin-Tube-Cold-Weld-Epoxy-8265-s/100189012
carbon fiber tail tube .314 in OD | Purchased | 39 in | 35.98 | N | https://www.mcmaster.com/2153T84/

Sheet: Mechanisms BOM
Part | Type | Quantity | Total Cost | LAB STOCK? | Link
mg90s servo | Purchased | 4 | 13.88 | Y | https://www.amazon.com/Miuzei-Geared-Helicopter-Arduino-Project/dp/B0CP98TZJ2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
Servo Mount ABS | Printed | 2 | 0.5 | Printed | https://us.store.bambulab.com/products/pla-basic-filament?id=42844629008520
Control Horns | Purchased | 4 | 2.99 | Y | https://www.amazon.com/Standard-Control-17-5x26-Airplane-Replacement/dp/B019I0U8NG
Control Rods | Purchased | 2 | 4.44 | Y | https://www.amazon.com/uxcell-Stainless-Crafts-Helicopter-Airplane/dp/B0F9FLP8ZX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
Main Landing Gear | Purchased | 1 | 14.99 | Y | https://www.horizonhobby.com/product/main-landing-gear-valiant-10cc/HAN508010.html
Main Landing Gear Wheels | Purchased | 2 | 11.33 | Y | https://www.horizonhobby.com/product/wheel-set-3-carbon-z-t-28/EFL1310.html
Rear Landing Gear | Purchased | 1 | 8.97 | Y | https://www.amazon.com/Wheel-Assembly-60x25mm-Airplane-Replacement/dp/B019IF9PYE
Rubber Bands | Purchased | 20 | 0.12 | Y | https://www.mcmaster.com/12205T76/

Sheet: Propulsion BOM
Part | Type | Quantity | Total Cost | LAB STOCK? | Link
11x7E Prop | Purchased | 1 | 4.17 | Y | https://www.horizonhobby.com/product/apc-landing-products-electric-propeller-11-x-7e/APC11070E.html
Cobra 3520/12 | Purchased | 1 | 57.99 | Y | https://www.cobramotorsusa.com/motors-3520-12.html
RC Electric Parts 80A ESC | Purchased | 1 | 38.49 | Y | https://www.amazon.com/RC-Electric-Controller-Brushless-Motors/dp/B071GRSFBD?th=1
Turnigy 4Cell 4000 mAh Battery | Purchased | 1 | 40.57 | Y | https://hobbyking.com/en_us/turnigy-battery-4000mah-4s-30c-lipo-pack-xt-60.html
