HudsonReynolds/451-DBF-Team01/Aicraft Performance Simulation/RequirementsValidation.xlsx

Deliverable 9 -- Requirements Validation (last run: 2026-10-06 17:29)
ID | Summary | Status | Detail | Action
R1 | Takeoff Distance | Verified | computed 11.11 m vs limit 25.0 m (Deliverable 2)
R2 | Post Climb Altitude | Verified | ROC_max = 7.45 m/s > 0, so the modelled climb reaches 30 m (Deliverable 3)
R3 | Lap (3 full laps) | Verified | Deliverable 6 simulates exactly 3 laps (R3-cited) and checks the energy budget covers them
R4 | Stability (center-mark, lap 3) | Open | not modelled -- needs a dynamic-stability check at a specific mission point, outside this performance pipeline | Flight test: fly the as-built aircraft through a representative lap configuration at the payload condition, verify handling and recovery; before competition.
R5 | Safe Landing (dirt/grass) | Open | not modelled -- landing-gear energy absorption / structural check, not a performance-pipeline quantity | Flight test: land the as-built aircraft on the actual grass/dirt surface, inspect the airframe for damage after each landing; during flight-test sessions.
R6 | Prevent Injury and Damage | Open | operational/safety -- not a MATLAB-computable quantity | Inspection + flight test: review the structure for exposed hazards (prop, sharp edges) and confirm nothing separates on a hard landing; before first flight.
R7 | Battery Connection | Open | mechanical/CAD layout -- not modelled here | Physical inspection: verify connector type, polarity, and secure mounting once the battery and fuselage are both built; at integration.
R8 | Propeller Clearance | Open | mechanical/CAD layout -- not modelled here | Physical measurement: measure as-built prop-to-ground and prop-to-fuselage clearance once the airframe and gear are assembled; at integration.
R9 | Storage Volume (75x75x150 cm) | Open | needs the folded/disassembled stowed envelope -- not modelled (only flight geometry exists here) | Physical fit-check: fold/disassemble the as-built aircraft and measure the stowed envelope against 75x75x150 cm; once assembly is complete.
R10 | Wingspan (<=150 cm) | Verified | wingspan = 1.500 m vs 1.50 m limit
R11 | Configuration Change (<5 min) | Open | operational/human-factors timing -- not modelled | Timed demonstration: time a team member performing the configuration change on the as-built aircraft; during a practice/readiness review.
R12 | Battery & Payload Install (<2 min) | Open | operational/human-factors timing -- not modelled | Timed demonstration: time battery and payload installation on the as-built aircraft; during a practice/readiness review.
R13 | Battery Access (no tooling) | Open | mechanical design -- not modelled | Physical demonstration: remove and install the battery by hand, confirm no tools are needed; at integration.
R14 | Payload Capacity (>=0.52 kg) | Verified | baseline design payload W_pay = 0.520 kg vs 0.52 kg requirement
R15 | Payload & Battery Mounting | Open | mechanical design -- not modelled | Physical inspection: verify mounting hardware secures both under expected flight loads; at integration.
R16 | Battery/Payload Modifications | Open | mechanical design -- not modelled | Physical inspection: confirm no aircraft modification is needed to swap battery or payload; at integration.
R17 | Aircraft-Payload Stability | Open | dynamic stability with payload -- not modelled (A5B checks static margin only, at one configuration) | Flight test: fly with payload installed, assess handling qualities qualitatively; during flight-test sessions.
R18 | Aircraft-No Payload Stability | Open | dynamic stability without payload -- not modelled | Flight test: fly without payload, assess handling qualities qualitatively; during flight-test sessions.
R19 | Flyability (non-team pilot) | Open | subjective/qualitative -- flight test item | Flight test: have a non-team-member pilot fly the aircraft and report on handling; during a flight-test session.
R20 | Flight Data (telemetry) | Open | avionics hardware capability -- not a performance-model quantity | Bench/ground test: verify the telemetry/avionics package powers on and logs or transmits data correctly; at avionics integration.
R21 | Propulsion Power (<=1000 W) | Verified | peak electrical draw checked against 1000 W across the whole mission (Deliverable 6)
R22 | Maximum Take Off Weight (<=6 kg) | Verified | MTOM = 4.052 kg vs 6.0 kg limit
R23 | Budget (<=$400) | Open | cost tracking -- not a performance-model quantity | Cost audit: tally as-built/as-purchased costs against the $400 cap; ongoing, finalized before competition.
R24 | Schedule (ready Week 12) | Open | project management -- not a performance-model quantity | Program review: confirm the aircraft is flight-ready against the team's build schedule; at the Week 12 milestone.
R25 | As-Built Justifications | Open | documentation/process item -- not a performance-model quantity | Documentation review: compile and review as-built design-change justifications; before final report submission.
R26 | Multiple Flights (3x T.O./landing, no repair) | Open | structural durability over repeated flights -- not modelled | Flight test: fly 3 consecutive take-off/landing cycles without repair, inspect the airframe between flights; during flight-test sessions.
R27 | Tracking (visible to 200 m) | Open | paint/marking scheme -- not modelled | Visual demonstration: view the as-built, as-painted aircraft from 200 m and confirm visibility; during a flight-test or ground check.
R28 | Weight Margin (as-designed <=90% of 6 kg) | Verified | MTOM = 4.052 kg vs 5.40 kg (90% of 6 kg)
R29 | Repairability (<=1 hr) | Open | mechanical design / assembly process -- not modelled | Timed demonstration: simulate a representative field repair on the as-built aircraft and time it; during a practice/readiness review.
(D8) | Maximum payload found vs. R14/R28 margin | Verified | Deliverable 8 found a maximum payload of 2.468 kg while holding every other constraint, vs. the 0.52 kg R14 requires
