HudsonReynolds/451-DBF-Team01/SizingParams.xlsx

Sheet: Inputs
Parameter | Subclass | Value | Units | Description | Notes
DqA_wheel | aero | 0.25 | - | Wheel drag per frontal area (D/q/A)
DqA_strut | aero | 0.3 | - | Strut drag per frontal area (D/q/A)
CD_0_misc_factor | aero | 0.1 | - | Misc. drag as fraction of component CD_0
CL_max | aero | 1.43 | - | Max lift coefficient (stall)
CL_C | aero | 0.3 | - | Design cruise lift coefficient
CL_0 | aero | 0.43 | - | Lift coefficient at zero AoA
CM_ac_w | aero | -0.08 | - | Wing pitching moment about AC
CM_0_Wing | aero | -0.08 | -
Airfoil_Alpha_Stall | aero | 15.8 | deg | Airfoil stall angle
e_t | aero | 0.65 | - | Oswald efficiency, horizontal tail
crosswind_ratio | aero | 0.33 | - | Crosswind ratio
roll_rate_target_dps | aero | 120 | deg/s | Target roll rate
CM_EquivalentRotate | aero | 0.1 | - | Extra pitch moment for takeoff rotation
Q_wing | aero | 1 | - | Interference factor, wing
Q_hstab | aero | 1.05 | - | Interference factor, horizontal tail
Q_vstab | aero | 1.05 | - | Interference factor, vertical tail
S_wet_factor | aero | 1.02 | - | Wetted area per side / planform area
g | env | 9.81 | m/s^2 | Gravitational acceleration
rho | env | 1.225 | kg/m^3 | Air density (sea level)
visc | env | 1.796e-05 | Pa-s | Air dynamic viscosity
mu_TO | env | 0.05 | - | Takeoff rolling friction coefficient
mu_L | env | 0.08 | - | Landing friction coefficient
S_wing | geometry | 0.449 | m^2 | wing area
SM | geometry | 0.15 | - | Design static margin (fraction of MAC)
wingspan | geometry | 1.5 | m | Wing span
width_fuselage | geometry | 0.08 | m | Fuselage width
len_fuselage | geometry | 1 | m | Fuselage length
S_wet_fuselage | geometry | 0.433 | m^2 | Fuselage wetted area
tc_wing | geometry | 0.14 | - | Wing airfoil max thickness (SD7062)
xcm_wing | geometry | 0.255 | - | Wing airfoil max-thickness location
tc_hstab | geometry | 0.1 | - | H-stab airfoil max thickness (NACA 0010)
xcm_hstab | geometry | 0.3 | - | H-stab airfoil max-thickness location
AR_hstab | geometry | 2.5 | - | H-stab aspect ratio
AR_vstab | geometry | 1.07 | - | Aspect ratio per vertical fin
tc_vstab | geometry | 0.1 | - | Fin airfoil max thickness (NACA 0010)
xcm_vstab | geometry | 0.3 | - | Fin airfoil max-thickness location
main_wheel_dia | geometry | 0.083 | m | Main wheel diameter
main_wheel_width | geometry | 0.047 | m | Main wheel width
main_gear_len | geometry | 0.1043 | m | Main gear strut VERTICAL HEIGHT - USED FOR DRAG AND GEAR PLACEMENT
main_strut_dia | geometry | 0.00635 | m | Main Strut Diameter
tail_wheel_dia | geometry | 0.03 | m | Tail wheel diameter
tail_wheel_width | geometry | 0.01 | m | Tail wheel width
tail_gear_len | geometry | 0.063 | m | Tail gear strut length
tail_strut_dia | geometry | 0.0025 | m | Tail gear strut diameter
V_v | geometry | 0.08 | -- | Vertical tail volume coefficient
df | geometry | 0.1 | m | Fuselage depth at wing
zw | geometry | 0.04 | m | Wing root height above fuselage centerline
x_ac | geometry | 0.25 | - | Wing AC location (fraction of MAC)
l_t | geometry | 0.8 | m | Wing AC to tail AC distance
St_S | geometry | 0.17 | - | H-stab area / wing area
kappa | geometry | 2 | - | Downwash gradient factor
n_vfins | geometry | 1 | - | Number of vertical fins
E | geometry | 0.3 | - | Elevator chord fraction
delta_e_limit_deg | geometry | 30 | deg | Max elevator deflection
E_r | geometry | 0.3 | - | Rudder chord fraction
delta_r_limit | geometry | 30 | deg | Max rudder deflection
E_a | geometry | 0.25 | - | Aileron chord fraction
y1_frac | geometry | 0.7 | - | Aileron inboard edge (fraction of semispan)
y2_frac | geometry | 1 | - | Aileron outboard edge (fraction of semispan)
delta_a_limit | geometry | 15 | deg | Max aileron deflection
Gamma_dihedral_deg | geometry | 5 | deg | Wing dihedral angle
V_S | performance | 10 | m/s | Stall speed
mult_V_TO | performance | 1.1 | - | Takeoff speed multiplier
phi_C | performance | 0.75 | - | Cruise throttle setting
n | performance | 1.5 | - | Max load factor
R_M | performance | 20 | m | Min turn radius
R_req | performance | 50 | m | Required turn radius
climb_alt | performance | 30 | m | Mission altitude
climb_dist | performance | 100 | m | Ground distance to climb to altitude
S_TO | performance | 25 | m | Takeoff distance
lap_length | performance | 200 | m | Course length per lap
W_S_design | performance | 95 | N/m^2 | Design wing loading
W_P_design | performance | 0.07 | N/W | Design power loading
W_e_frac | performance | 0.8 | - | Empty weight fraction
W_pay | performance | 0.52 | kg | Payload mass
warmupN | performance | 10 | - | Warm-up energy as multiple of takeoff energy
MTOM | performance | 3.45 | kg | Takeoff mass
eta_p_C | prop | 0.75 | - | Propeller efficiency, cruise
eta_p_TO | prop | 0.45 | - | Propeller efficiency, takeoff
n_motors | prop | 1 | - | Number of motors
eta_m | prop | 0.75 | - | Motor efficiency
eta_ESC | prop | 0.95 | - | ESC efficiency
Kv | prop | 820 | RPM/V | Motor velocity constant
I0 | prop | 1.45 | A | Motor no-load current
R_motor | prop | 0.026 | Ohm | Motor winding resistance
V_batt | prop | 14.8 | V | Battery voltage (4S)
prop_file | prop | PER3_11x7E.txt | - | APC propeller data file
rho_battery | prop | 527000 | J/kg | Battery specific energy
useableCapacity | prop | 0.8 | - | Usable fraction of battery capacity
temp_derate | prop | 0.7 | - | Battery temperature derating
T_static_actual | prop | 20.45385 | N
linkage_ratio_aileron | controls | 1 | - | Aileron servo-arm / control-horn mechanical advantage
linkage_ratio_elevator | controls | 1.2 | - | Elevator servo-arm / control-horn mechanical advantage
linkage_ratio_rudder | controls | 1 | - | Rudder servo-arm / control-horn mechanical advantage
linkage_efficiency | controls | 0.85 | - | Pushrod/linkage mechanical efficiency (friction losses); applies to all three surfaces
V_servo_rail | controls | 5.5 | V | Servo rail (BEC output) voltage used to evaluate torque at the actual operating voltage -- matches the MG90S stall-torque rating quoted at 5.5V
CL_max_neg | aero | -0.66 | - | Negative (inverted-flight) max lift coefficient
x_spar | structures | 0.25 | - | Wing spar/shear-center location, fraction of chord aft of LE
eta_h | structures | 1 | - | Horizontal tail dynamic-pressure ratio q_tail/q_freestream
eta_v | structures | 1 | - | Vertical tail (fin) dynamic-pressure ratio
CL_max_tail | structures | 1 | - | Max lift coefficient of the tail's symmetric section (NACA 0010)
D_fus_tail | structures | 0.0127 | m | Fuselage/tailboom depth at the fin root
x_LE_wing | structures | 0.295 | m | Fuselage station of the wing's MAC leading edge, from the nose
sink_rate | structures | 1 | m/s | Design sink rate for the landing load factor derivation
gear_stiffness | structures | 35000 | N/m | Main landing gear vertical stiffness (both legs), value makes load factor ~ n = 10
gear_track | structures | 0.346 | m | Lateral distance between the two main wheels (track), ASSUMPTION -- needed for the overturn-angle check, not previously modelled (~20% of wingspan)
P_limit_RFP | performance | 1000 | W | RFP Max Power Requirement
P_motor_rated | prop | 890 | W | Motor Spec per Jackson
I_motor_limit | prop | 60 | A | Motor Spec per Jackson
V_S_landing_limit | performance | 11.94154344 | m/s | COMPUTED each run by MaxPayloadSweep.m = 1.25x the baseline self-consistent stall speed; In line with other aircraft of this size.
fty_al_6061_t6 | materials | 241 | MPa | FROM MMPDS, AMS 4080 (DRAWN TUBE)
fsu_al_6061_t6 | materials | 186 | MPa | FROM MMPDS, AMS 4080 (DRAWN TUBE)
fbry_al_6061_t6 | materials | 462 | MPa | FROM MMPDS, AMS 4080 (DRAWN TUBE)
fc_plywood | materials | 30 | MPa | FROM https://www.metsagroup.com/globalassets/metsa-wood/dop-documents/dop_metsa_wood_birch_plywood_muf_2019-12-2_en.pdf
fs_panel_plywood | materials | 9.5 | MPa | FROM https://www.metsagroup.com/globalassets/metsa-wood/dop-documents/dop_metsa_wood_birch_plywood_muf_2019-12-2_en.pdf
fs_planar_plywood | materials | 2.5 | MPa | FROM https://www.metsagroup.com/globalassets/metsa-wood/dop-documents/dop_metsa_wood_birch_plywood_muf_2019-12-2_en.pdf
E_al_6061_t6 | materials | 68900 | MPa | FROM MMPDS
ftu_petg | materials | 40 | MPa | From UltiMaker
gear_strut_length | geometry | 0.148 | m | MAIN STRUT BEAM LENGTH - USED FOR STRESS MARGINS
gear_strut_thickness | geometry | 0.004 | m
gear_strut_width_max | geometry | 0.04 | m
gear_strut_width_min | geometry | 0.023 | m
gear_strut_angle | geometry | 50 | deg
height_fuselage | geometry | 0.09 | m
wall_thick_fuselage | geometry | 0.00635 | m
width_spar | geometry | 0.0127 | m
length_spar | geometry | 0.76 | m
wall_thick_spar | geometry | 0.001524 | m
width_tail_boom | geometry | 0.0127 | m
length_tail_boom | geometry | 0.565 | m | Length that sticks out of fuselage
wall_thick_tail_boom | geometry | 0.001524 | m
washer_OD | geometry | 0.009 | m
washer_ID | geometry | 0.0043 | m
bolt_OD | geometry | 0.004 | m
wall_thick_tail_mount | geometry | 0.002 | m
width_tail_mount | geometry | 0.0167 | m

Sheet: Outputs
Parameter | Subclass | Value | Units | Description | Source | Written by writeOutputs.m on 2026-10-22 21:05
CL_max | aero | 1.419137543 | - | Wing CL_max with dihedral knockdown | Overwritten input (Sheet1 value: 1.43)
CL_max_neg | aero | -0.6549865585 | - | Negative wing CL_max with dihedral knockdown | Overwritten input (Sheet1 value: -0.66)
k_dihedral | aero | 0.9924038765 | - | Dihedral lift knockdown | Calculated
CL_TO | aero | 0.3 | - | Takeoff CL before rotation, no flaps, same as cruise | Calculated
CL_R | aero | 1.172840945 | - | Rotation CL | Calculated
e_wing | aero | 0.9091110575 | - | Oswald efficiency, Sadraey eqn 5.27a | Calculated
K_wing | aero | 0.07380740305 | - | Induced drag factor | Calculated
K_hstab | aero | 0.1958830069 | - | H-stab induced drag factor | Calculated
CD_0 | aero | 0.03208872584 |  |  | Calculated
CD_C | aero | 0.03873139212 | - | Cruise CD | Calculated
CD_TO | aero | 0.03873139212 | - | Takeoff CD | Calculated
CD_G | aero | 0.02373139212 | - | Ground roll CD, Sadraey eqn 4.67a | Calculated
L_D_C | aero | 7.745654974 | - | L/D at cruise | Calculated
L_D_max | aero | 10.2741004 | - | Max L/D of parabolic polar | Calculated
CL_Alpha_Tail | aero | 3.01985498 |  |  | Calculated
CL_Alpha_Wing | aero | 4.172553771 |  |  | Calculated
de_da | aero | 0.5599494245 |  |  | Calculated
CL_Alpha | aero | 5.501442693 |  |  | Calculated
CM_0 | aero | -0.08862250622 |  |  | Calculated
tau_e | aero | 0.6607459491 |  |  | Calculated
tau_a | aero | 0.608997781 |  |  | Calculated
CL_Alpha_VT | aero | 1.575327021 |  |  | Calculated
tau_r | aero | 0.6607459491 |  |  | Calculated
Cn_beta_VT | aero | 0.1260261617 |  |  | Calculated
CL_ground_attitude | aero | 0.8005805876 |  |  | Calculated
c_wing | geometry | 0.3161971831 | m | Wing chord, area excludes fuselage section | Calculated
AR | geometry | 4.743875278 | - | Wing aspect ratio | Calculated
S_hstab | geometry | 0.07633 | m^2 | H-stab area from area ratio | Calculated
span_hstab | geometry | 0.4368352092 | m | H-stab span | Calculated
c_hstab | geometry | 0.1747340837 | m | H-stab chord | Calculated
V_H | geometry | 0.4301113586 | - | Horizontal tail volume coefficient | Calculated
S_v | geometry | 0.06735 | m^2 | Total fin area from volume coefficient, fin arm = l_t | Calculated
S_fin | geometry | 0.06735 | m^2 | Area per fin | Calculated
span_vstab | geometry | 0.268448319 | m | Fin span | Calculated
c_vstab | geometry | 0.2508862795 | m | Fin chord | Calculated
x_cg_fwd | geometry | NaN |  |  | Calculated
x_cg_aft | geometry | 0.261766098 |  |  | Calculated
x_n | geometry | 0.37994766 |  |  | Calculated
x_cg_design | geometry | 0.22994766 |  |  | Calculated
MTOW | performance | 33.8445 | N | Takeoff weight | Calculated
W_S | performance | 75.37750557 | N/m^2 | Wing loading, hardcoded wing area (Inputs sheet) | Calculated
V_C | performance | 20.33119851 | m/s | Cruise speed from design CL_C | Calculated
V_TO | performance | 11 | m/s | Takeoff speed | Calculated
V_M | performance | 14.81074841 | m/s | Maneuver speed for turn radius R_M | Calculated
V_S_M | performance | 12.24744871 | m/s | Stall speed at load factor n | Calculated
bank_angle | performance | 48.1896851 | deg | Bank angle at load factor n | Calculated
gamma | performance | 16.69924423 | deg | Climb angle | Calculated
totBatteryMass_kg | performance | 0.4473549269 |  |  | Calculated
totBatteryEnergy_J | performance | 235756.0465 |  |  | Calculated
usableBatteryEnergy_J | performance | 132023.386 |  |  | Calculated
V_max_level | performance | 31.76748761 |  |  | Calculated
T_static_design | performance | 11.26369473 |  |  | Calculated
n_limit_pos | performance | 3.8 |  |  | Calculated
n_limit_neg | performance | -1.52 |  |  | Calculated
n_ult_pos | performance | 5.7 |  |  | Calculated
n_ult_neg | performance | -2.28 |  |  | Calculated
V_A | performance | 18.15295737 |  |  | Calculated
V_NO | performance | 24.6970718 |  |  | Calculated
V_NE | performance | 35.73842356 |  |  | Calculated
V_D | performance | 39.70935951 |  |  | Calculated
V_tailUp | performance | 4.061006661 |  |  | Calculated
RPM_max | prop | 11198.55157 |  |  | Calculated
throttle_settings | prop | [0.25 0.5 0.75 1] |  |  | Calculated
wing_M_driving | structures | 28.41921928 |  |  | Calculated
wing_M_driving_location | structures | 0 |  |  | Calculated
wing_governing_case | structures | rolling maneuver (down-going wing) |  |  | Calculated
wing_V_driving | structures | 73.83598421 |  |  | Calculated
wing_V_driving_location | structures | 0 |  |  | Calculated
wing_T_driving | structures | -1.210788012 |  |  | Calculated
wing_T_driving_location | structures | 0 |  |  | Calculated
horizontal_tail_M_root | structures | 3.144056524 |  |  | Calculated
horizontal_tail_T_root | structures | 0 |  |  | Calculated
fin_M_root | structures | 4.038417719 |  |  | Calculated
tailcone_T | structures | 4.264200155 |  |  | Calculated
tailcone_Ml | structures | 20.03003736 |  |  | Calculated
tailcone_V | structures | 35.45139356 |  |  | Calculated
fuselage_M_envelope_max | structures | 15.01260897 |  |  | Calculated
fuselage_M_envelope_station | structures | 0.3746568084 |  |  | Calculated
fuselage_governing_case | structures | maneuver |  |  | Calculated
fuselage_V_envelope_max | structures | 212.4082893 |  |  | Calculated
fuselage_V_envelope_station | structures | 0.2493195398 |  |  | Calculated
fuselage_governing_case_V | structures | hard landing |  |  | Calculated
landing_n_L | structures | 10.26728145 |  |  | Calculated
landing_F_main | structures | 326.5189897 |  |  | Calculated
landing_F_tailwheel | structures | 20.97201742 |  |  | Calculated
x_cg_abs | structures | 0.3096544546 |  |  | Calculated
mass_table_MTOM | structures | 3.45 |  |  | Calculated
mass_table_MTOW | structures | 33.8445 |  |  | Calculated
alpha_tf_deg | structures | 16.61687653 |  |  | Calculated
prop_clearance_tailUp | structures | 0.0661 |  |  | Calculated
overturn_phi_deg | structures | 51.75362121 |  |  | Calculated
sigma_bend_spar | structures | 187.3797618 |  |  | Calculated
tau_shear_spar | structures | 3.613204446 |  |  | Calculated
tau_torsion_spar | structures | 4.770584825 |  |  | Calculated
sigma_vm_spar | structures | 187.5618579 |  |  | Calculated
tau_spar_max | structures | 8.383789271 |  |  | Calculated
MoS_spar_vm | structures | 0.2849094301 |  |  | Calculated
MoS_spar_shear | structures | 21.18567213 |  |  | Calculated
tail_def_angle | structures | 3.257235633 |  |  | Calculated
tail_def | structures | 0.02141330651 |  |  | Calculated
sigma_bend_tail_boom | structures | 132.0663876 |  |  | Calculated
tau_shear_tail_boom | structures | 1.734833418 |  |  | Calculated
tau_torsion_tail_boom | structures | 16.80123057 |  |  | Calculated
sigma_vm_tail_boom | structures | 135.2345177 |  |  | Calculated
tau_tail_boom_max | structures | 18.53606399 |  |  | Calculated
MoS_tail_boom_vm | structures | 0.7820893959 |  |  | Calculated
MoS_tail_boom_shear | structures | 9.034492767 |  |  | Calculated
sigma_bend_fuselage | structures | 0.4464952721 |  |  | Calculated
tau_shear_fuselage | structures | 0.339718406 |  |  | Calculated
tau_torsion_fuselage | structures | 0.08174974813 |  |  | Calculated
tau_combined_fuselage | structures | 0.4214681542 |  |  | Calculated
MoS_fuselage_bend | structures | 66.18996118 |  |  | Calculated
MoS_fuselage_shear | structures | 21.54025578 |  |  | Calculated
sigma_bend_gear | structures | 218.4088318 |  |  | Calculated
sigma_comp_gear | structures | 2.039087426 |  |  | Calculated
tau_gear | structures | 2.566496261 |  |  | Calculated
MoS_gear_vm | structures | 0.09322873564 |  |  | Calculated
MoS_gear_shear | structures | 71.47234405 |  |  | Calculated
MoS_wing_joint | structures | 45.20102812 |  |  | Calculated
MoS_boom_joint | structures | 4.311524277 |  |  | Calculated
MoS_tail_mount | structures | 0.6709659663 |  |  | Calculated
MoS_motor_mount | structures | 221.3736775 |  |  | Calculated
MoS_gear_mount | structures | 0.9108318549 |  |  | Calculated
lastControlSurfaces.Elevator.E | stability | 0.3 |  |  | Calculated
lastControlSurfaces.Elevator.delta_flare_deg | stability | 23.63955112 |  |  | Calculated
lastControlSurfaces.Elevator.margin_deg | stability | 6.360448876 |  |  | Calculated
lastControlSurfaces.Aileron.E_a | stability | 0.25 |  |  | Calculated
lastControlSurfaces.Aileron.y1_frac | stability | 0.7 |  |  | Calculated
lastControlSurfaces.Aileron.y2_frac | stability | 1 |  |  | Calculated
lastControlSurfaces.Aileron.pb_2V | stability | 0.120453117 |  |  | Calculated
lastControlSurfaces.Aileron.roll_rate_dps | stability | 119.625224 |  |  | Calculated
lastControlSurfaces.Rudder.S_v | stability | 0.06735 |  |  | Calculated
lastControlSurfaces.Rudder.AR_v | stability | 1.07 |  |  | Calculated
lastControlSurfaces.Rudder.E_r | stability | 0.3 |  |  | Calculated
lastControlSurfaces.Rudder.delta_r_deg | stability | 29.16215456 |  |  | Calculated
lastControlSurfaces.Rudder.margin_deg | stability | 0.8378454435 |  |  | Calculated
lastDerivatives.CL_Alpha | stability | 5.501442693 |  |  | Calculated
lastDerivatives.x_n | stability | 0.37994766 |  |  | Calculated
lastDerivatives.SM | stability | 0.15 |  |  | Calculated
lastDerivatives.CM_Alpha | stability | -0.825216404 |  |  | Calculated
lastDerivatives.Cn_beta | stability | 0.1260261617 |  |  | Calculated
lastDerivatives.Gamma_deg | stability | 5 |  |  | Calculated
lastDerivatives.Cl_beta | stability | -0.1913549912 |  |  | Calculated

Sheet: MassBudget
Component | Mass_g | X_m | Z_m
Propeller+spinner | 25.9 | 0 | 0.06
Motor | 210 | 0.022 | 0.06
Motor mount/firewall | 74.6 | 0.07 | 0.056
ESC | 96.2 | 0.136 | 0.018
Tail wheel | 9 | 1.254 | -0.022
Battery | 451 | 0.172 | 0.049
Flight controller/avionics | 119.9 | 0.437 | 0.053
Wiring + connectors | 44.7 | 0.565 | 0.087
Misc electronics | 0.05 | 0.332 | 0.125
Servo, aileron 1 | 20.7 | 0.462 | 0.146
Servo, aileron 2 | 20.7 | 0.462 | 0.146
Payload cube | 520 | 0.327 | 0.032
Wing (spar+foam) | 688.5 | 0.395 | 0.126
Main gear (pair) | 256 | 0.249 | -0.044
Fuselage (keel+shell) | 763.7 | 0.298 | 0.046
Servo, elevator | 22 | 1.188 | 0.117
Servo, rudder | 23.3 | 1.185 | 0.073
Horizontal tail (spar+foam) | 31.3 | 1.207 | 0.077
V-tail (spar+foam) | 13.9 | 1.205 | 0.188

Sheet: Hinge Moments
Control-Surface Hinge Moments - Thin-Airfoil (Glauert) Theory
Geometry linked live from the Sheet1 tab. Inviscid 2-D theory typically over-predicts the real hinge moment by ~2x - conservative for servo sizing.
PARAMETER | AILERON | ELEVATOR | RUDDER
Reference (root) chord, c (m) | 0.251 | 0.196 | 0.196 | Ch_alpha, Ch_delta from closed-form thin-airfoil (Glauert) flap theory, verified
Control-surface chord fraction, Ef = cf/c | 0.2500 | 0.3000 | 0.3000 | against an independent numerical vortex-panel solution to 4 sig. figs.
Control-surface chord, cf = Ef*c (m) | 0.063 | 0.059 | 0.059 | Yellow cells are NOT linked to Sheet1 -- check/edit them:
Control-surface span, bf (m) | 0.225 | 0.539 | 0.243 | - c_hstab, c_vstab, span_hstab, span_vstab, and V_C (cruise speed) are not defined in Sheet1; literal values carried over from the old sheet -- verify/update manually.
Max deflection, delta_max (deg) | 15.0 | 30.0 | 30.0 | - alpha assumption per surface defaults to 0 deg (pure control deflection case);
Local AoA assumed for this case, alpha (deg) | 0.0 | 1.0 | 0.0 | raise it for combined maneuver cases (e.g. elevator at high AoA).
Design airspeed for this case, V (m/s) | 23.000 | 23.000 | 23.000 | - V_design defaults to V_C (cruise, not in Sheet1); consider a higher design/dive speed if known.
Air density, rho (kg/m^3) | 1.225 | 1.225 | 1.225 | Theory is inviscid/2-D and typically over-predicts real hinge moment ~2x --
Extra servo safety margin factor (x) | 1.0 | 1.0 | 1.0 | conservative (safe) for servo torque sizing, but state that factor in the report.
Linkage ratio, servo arm / control horn (mechanical advantage) | 1.00 | 1.20 | 1.00 | Servo torque scales by (linkage ratio / efficiency): a longer servo arm vs. horn cuts required torque;
Linkage efficiency, eta_linkage (friction losses) | 0.85 | 0.85 | 0.85 | friction losses in the linkage mean the servo must output more torque than the ideal case.
THIN-AIRFOIL DERIVATION
theta_f = ACOS(2*Ef-1) (rad) | 2.0944 | 1.9823 | 1.9823
X = pi - theta_f | 1.0472 | 1.1593 | 1.1593
Ch_alpha (floating tendency, per rad) | -0.5653 | -0.6274 | -0.6274
Ch_delta (restoring tendency, per rad) | -0.9436 | -0.9654 | -0.9654
RESULTING HINGE MOMENT (worst case: alpha & delta_max together)
alpha (rad) | 0.0000 | 0.0175 | 0.0000
delta_max (rad) | 0.2618 | 0.5236 | 0.5236
Ch = Ch_alpha*alpha + Ch_delta*delta_max | -0.2470 | -0.5164 | -0.5055
Dynamic pressure, q = 0.5*rho*V^2 (Pa) | 324.013 | 324.013 | 324.013
Control-surface area, Sf = cf*bf (m^2) | 0.014 | 0.032 | 0.014
Hinge moment, H = Ch*q*Sf*cf (N*m) | -0.0708 | -0.3118 | -0.1376
... with safety margin, |H|*margin (N*m) | 0.0708 | 0.3118 | 0.1376
... in servo units (oz-in) | 11.80 | 62.34 | 22.93
COMPARE TO XFLR5 (paste your sweep results here)
XFLR5 Ch at same alpha, delta_max
Ratio: thin-airfoil / XFLR5

Sheet: Sheet1
11.94154344 | COMPUTED each run by MaxPayloadSweep.m = 1.25x the baseline self-consistent stall speed -- not read back in as an input, edit LANDING_SPEED_RATIO in that script instead.
