HudsonReynolds/451-DBF-Team01/--- AIRCRAFT BUILD FOLDER ---/3D Prints/Cowling/Cowling.stp

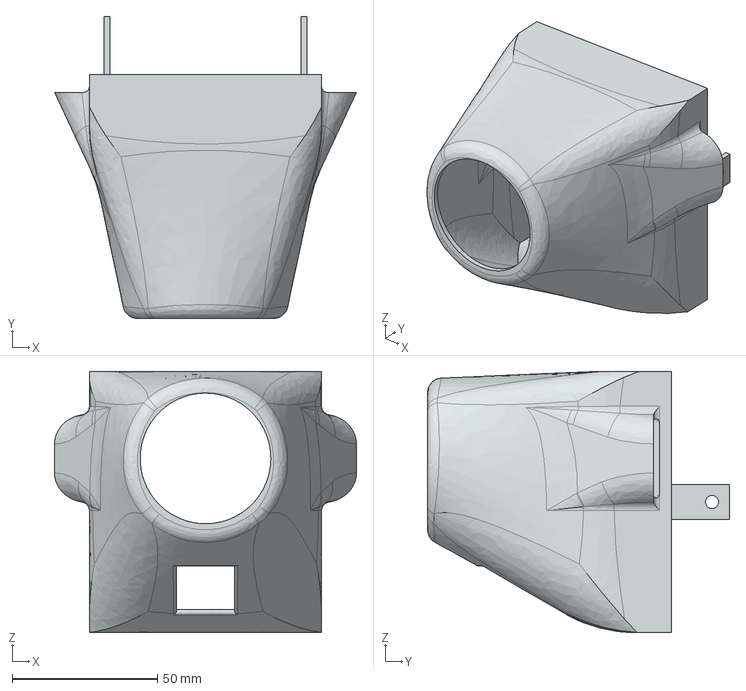
[picture p83: CAD file, 2026-10-27]
--- AIRCRAFT BUILD FOLDER ---/3D Prints/Cowling/Cowling.stp
104.0 x 104.0 x 90.0 mm
