HudsonReynolds/451-DBF-Team01/--- AIRCRAFT BUILD FOLDER ---/3D Prints/TailMount/TailMount.stp

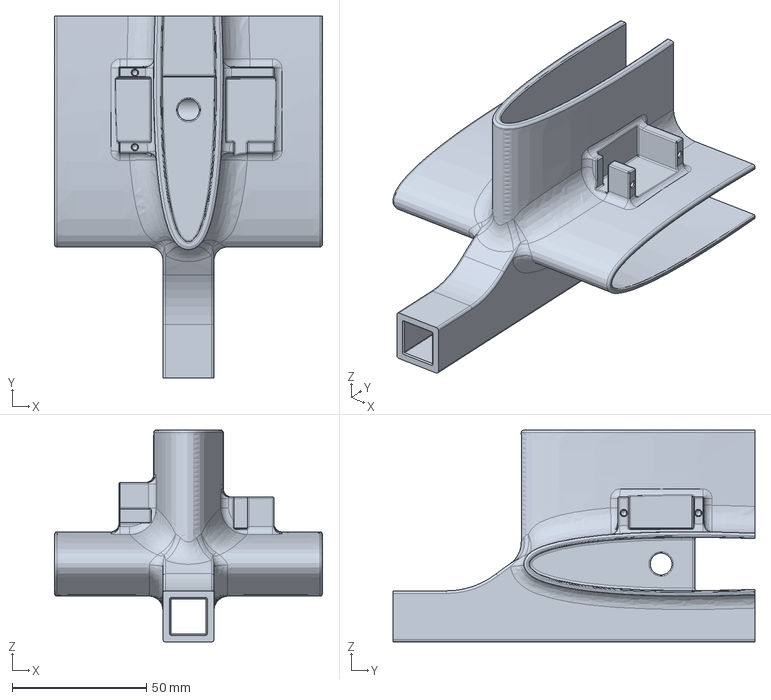
[picture p84: CAD file, 2026-10-27]
--- AIRCRAFT BUILD FOLDER ---/3D Prints/TailMount/TailMount.stp
100.0 x 135.0 x 79.1 mm
