HudsonReynolds/451-DBF-Team01/Assignment Deliverables/A10 Submission Files/Team01.obj

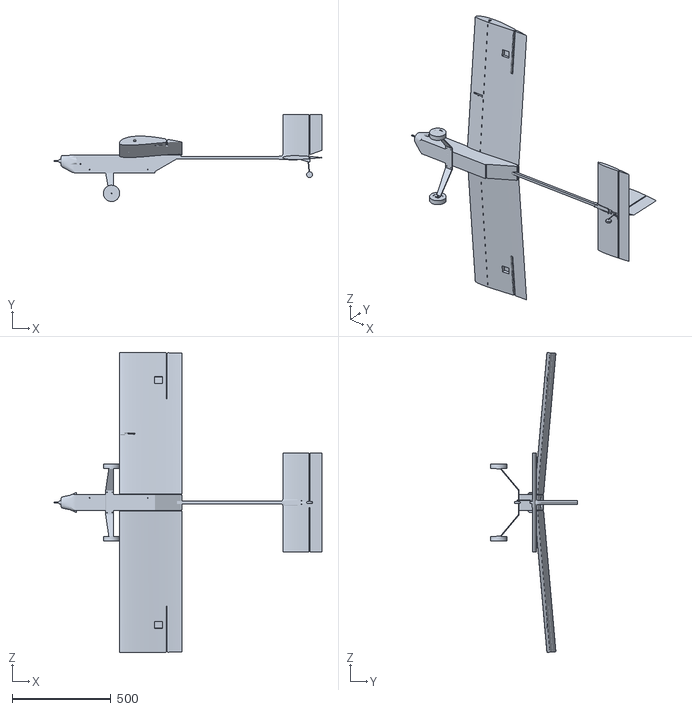
[picture p85: CAD file, 2026-10-20]
Assignment Deliverables/A10 Submission Files/Team01.obj
1358.8 x 442.1 x 1522.6
