HudsonReynolds/451-DBF-Team01/dxf/0000451001-L06_A_1-DBF-T1 VERTICAL TAIL.dxf

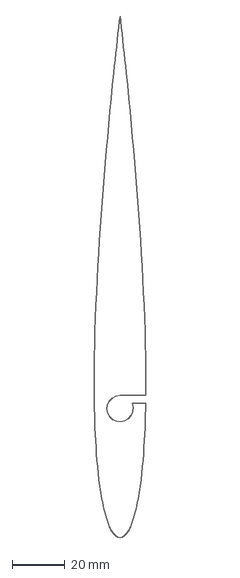
[picture p86: CAD file, 2026-10-29]
dxf/0000451001-L06_A_1-DBF-T1 VERTICAL TAIL.dxf
19.6 x 197.8 mm
