HudsonReynolds/451-DBF-Team01/dxf/0000451001-L03_A_1-DBF-T1 HORIZONTAL TAIL.dxf

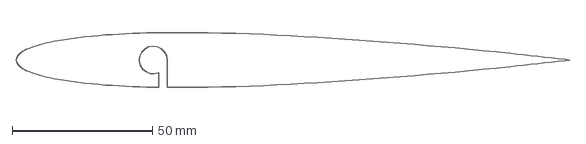
[picture p87: CAD file, 2026-10-29]
dxf/0000451001-L03_A_1-DBF-T1 HORIZONTAL TAIL.dxf
197.8 x 19.6 mm
