HudsonReynolds/451-DBF-Team01/dxf/0000451001-L02_A_1-DBF-T1 Wing_2.dxf

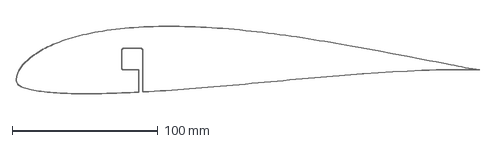
[picture p88: CAD file, 2026-10-29]
dxf/0000451001-L02_A_1-DBF-T1 Wing_2.dxf
318.1 x 46.3 mm
