HudsonReynolds/451-DBF-Team01/(list of files, cad)

Other CAD files:
dxf/wing dxf.dxf
--- AIRCRAFT BUILD FOLDER ---/FoamDXFs/0000451001-A03_A_1-DBF-T1 TAIL ASSEMBLY.dxf
--- AIRCRAFT BUILD FOLDER ---/FoamDXFs/0000451001-C01_B_1-DBF-T1 MAIN WING.dxf
--- AIRCRAFT BUILD FOLDER ---/FoamDXFs/0000451001-A03_A_1-DBF-T1 TAIL ASSEMBLY_1.dxf
