HudsonReynolds/451-DBF-Team01/Plots/V_n_Envelope_Operating_Limits.png

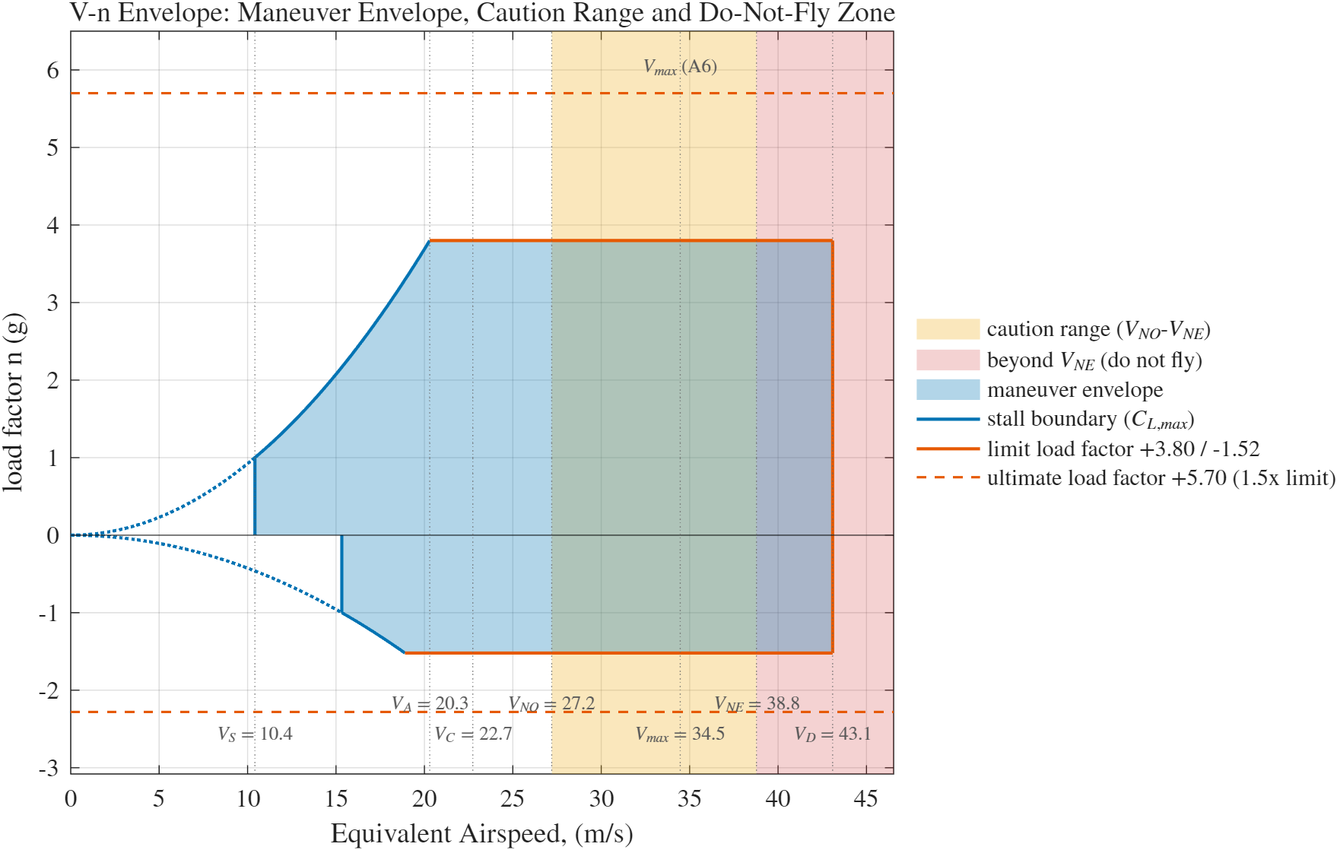
Plots/V_n_Envelope_Operating_Limits.png
