HudsonReynolds/451-DBF-Team01/Aicraft Performance Simulation/MaxPayloadSweepLog.xlsx

Deliverable 8 -- Maximum Payload Sweep (last run: 2026-10-06 17:28)
Run | Iteration | W_pay_kg | MTOM_kg | S_TO_m | V_S_mps | ROC_max_mps | t_climb_s | CL_turn | CL_limit | P_req_turn_W | P_avail_turn_W | LapsPossible | PeakPower_W | PeakCurrent_A | OverallResult
2026-10-06 17:28 | Grid 1/16 | 0.02 | 3.5516 | 7.595252115 | 8.944358384 | 8.656367584 | 3.465656895 | 0.5713089603 | 1.181818182 | 138.5443085 | 890 | 15 | 890 | 57.40267637 | PASS
2026-10-06 17:28 | Grid 2/16 | 0.2819626667 | 3.813562667 | 8.831622972 | 9.268353983 | 7.987332385 | 3.755947362 | 0.6134481704 | 1.181818182 | 148.1256067 | 890 | 14 | 890 | 57.39115602 | PASS
2026-10-06 17:28 | Grid 3/16 | 0.5439253333 | 4.075525333 | 10.18685325 | 9.581399909 | 7.400108076 | 4.053994846 | 0.6555873806 | 1.181818182 | 158.3443837 | 890 | 13 | 890 | 57.39179149 | PASS
2026-10-06 17:28 | Grid 4/16 | 0.805888 | 4.337488 | 11.66482673 | 9.884536553 | 6.879937083 | 4.360504993 | 0.6977265907 | 1.181818182 | 169.2928809 | 890 | 12 | 890 | 57.3812288 | PASS
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
