HudsonReynolds/451-DBF-Team01/Lab Documents/Prop Test Lab/PropLabExcelData.xlsx

Time (s) | ESC signal (µs) | Servo 1 (µs) | Servo 2 (µs) | Servo 3 (µs) | AccX (g) | AccY (g) | AccZ (g) | Torque (N·m) | Thrust (kgf) | Voltage (V) | Current (A) | Motor Electrical Speed (RPM) | Motor Optical Speed (RPM) | Electrical Power (W) | Mechanical Power (W) | Motor Efficiency (%) | Propeller Mech. Efficiency (kgf/W) | Overall Efficiency (kgf/W) | Vibration (g) | App message
18.953185 | 1900 |  |  |  | 0.50 | -0.11 | -0.81 |  |  | 14.99 | 35.75 | 11017 | 0.00 | 535.94 |  | 80.34 |  |  | 0.98
18.98976 | 1900 |  |  |  | 0.11 | -0.08 | -1.38 |  | 1.92 | 14.99 | 35.80 | 11017 | 0.00 | 536.62 |  | 80.24 |  | 0.0036 | 0.99
19.01305 | 1900 |  |  |  | 0.09 | 0.23 | -1.08 |  |  | 14.99 | 35.80 | 11013 | 0.00 | 536.56 |  | 80.22 |  |  | 0.98
19.036745 | 1900 |  |  |  | 0.64 | -0.10 | -0.77 | 0.37 |  | 14.99 | 35.85 | 11013 | 0.00 | 537.35 | 431.43 | 80.29 | 0.004442632 | 0.0036 | 0.98
19.06061 | 1900 |  |  |  | 0.05 | 0.21 | -1.19 |  |  | 14.99 | 35.84 | 11012 | 0.00 | 537.22 |  | 80.30 |  |  | 0.99
19.084595 | 1900 |  |  |  | -0.19 | 0.21 | -1.25 |  |  | 14.99 | 35.90 | 11015 | 0.00 | 538.10 |  | 80.19 |  |  | 0.98
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
