HudsonReynolds/451-DBF-Team01/Plots/Climb_Performance.png

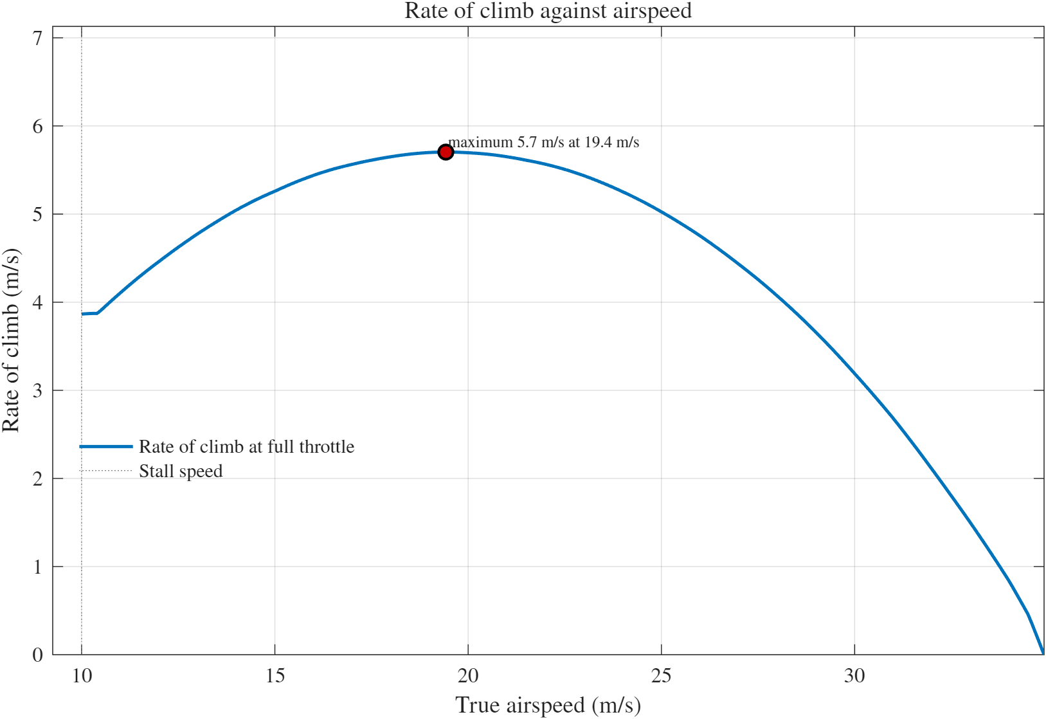
Plots/Climb_Performance.png
