HudsonReynolds/451-DBF-Team01/(commit log)

2026-08-31 added turn radius
    [SizingParams.xlsx]
2026-08-31 updated diagram
    [SizingParams.xlsx]
2026-09-01 changes yesterdat
    hi
    [SizingParams.xlsx]
2026-09-02 some changes
    [SizingParams.xlsx]
2026-09-09 drag buildup
    [SizingParams.xlsx]
2026-09-10 even more
    [SizingParams.xlsx]
2026-09-11 update to plots and stilabilty deriv
    [SizingParams.xlsx]
2026-09-11 pushing a5b mir will never see this lol
    thanks
    [SizingParams.xlsx]
2026-09-11 changes
    changes
    [SizingParams.xlsx]
2026-09-11 lastpuh
    pus
    [SizingParams.xlsx]
2026-09-12 added drag function, updated sheet
    [SizingParams.xlsx]
2026-09-12 updated drag polar
    [SizingParams.xlsx]
2026-09-12 fixed drag
    [SizingParams.xlsx]
2026-09-12 puh
    pih
    [SizingParams.xlsx]
2026-09-14 updated drag
    [SizingParams.xlsx]
2026-09-16 update bushit
    [SizingParams.xlsx]
2026-09-18 prop analysis
2026-09-19 I love Jackson Preisler
    [SizingParams.xlsx]
2026-09-20 workday clean up, code runs the same, bunch of stuff deleted and compacted
    code runs the same
    [SizingParams.xlsx]
2026-09-20 update prop
2026-09-20 new props
2026-09-22 hinge
    hingw
    [SizingParams.xlsx]
2026-09-23 changes
    hbw
    [SizingParams.xlsx]
2026-09-24 SAG
    WH
    [WireGaugeAccounting.xlsx]
2026-09-25 weight iteration
    [SizingParams.xlsx]
2026-09-25 updated fuselage wetted area
    [SizingParams.xlsx]
2026-09-26 added things
    ye
    [SizingParams.xlsx]
2026-09-26 done
    don
    [SizingParams.xlsx]
2026-09-27 h
    h
    [SizingParams.xlsx]
2026-09-28 a
    a
    [SizingParams.xlsx]
2026-09-28 V-N Diagram and Wing Loading
    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
2026-09-28 d
    d
    [SizingParams.xlsx]
2026-09-29 V-n, Wing, Tail, Fuselage, Takoff rotation First pass
    ff
    [SizingParams.xlsx]
2026-09-29 pushy pushy; mir makes me horny
    [SizingParams.xlsx]
2026-09-29 tail drag
    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
    [SizingParams.xlsx]
2026-10-03 starting a9
    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
    [PropLabExcelData.xlsx, SizingParams.xlsx]
2026-10-06 updated motor params
    [SizingParams.xlsx]
2026-10-06 added outputs sheet
    [MaxPayloadSweepLog.xlsx, RequirementsValidation.xlsx, SizingParams.xlsx]
2026-10-06 updated costs
    [CostBreakdown.xlsx]
2026-10-06 cost breakdwon update
    [CostBreakdown.xlsx]
2026-10-06 update airspeed edit
    [CostBreakdown.xlsx]
2026-10-07 update costs
    [CostBreakdown.xlsx]
2026-10-07 updated gear geometry
    [SizingParams.xlsx]
2026-10-07 margins :)
    [SizingParams.xlsx]
2026-10-08 updated params
    [SizingParams.xlsx]
2026-10-08 I have a rubber band around my balls
    [SizingParams.xlsx]
2026-10-08 margin I hardly know her
    [SizingParams.xlsx]
2026-10-21 final bom hopefully
2026-10-21 bom feedback
2026-10-29 wing dxf
